GuoJiashu/mech5720-2026-single_pixel_imaging/README

# Reflective Single-Pixel Imaging — Calibration

This project uses a projector to illuminate a reflective target and a light-dependent resistor (LDR) to measure the returned light. A Python program controls the projected patterns, while an Arduino UNO records the LDR voltage and sends measurements to the computer over USB serial.

This README covers the hardware setup and calibration workflow: electrical response, projector alignment, temporal response, measurement repeatability, spatial response, and acquisition timing.

The scripts described below are restored versions of the calibration programs. They preserve the documented measurement methods but have not yet been revalidated on the hardware after restoration. Recorded settings are starting points for reproducing the setup, rather than universal calibration values.

<!-- IMAGE: 在这里放实验装置全景照片，标出 projector、reflective target、LDR、Arduino 和 computer，以及照明和反射光路。建议路径：docs/images/setup_overview.jpg。照片添加后取消下一行注释。 -->
<!-- ![Reflective imaging calibration setup](docs/images/setup_overview.jpg) -->

## Parts List

The quantities below describe one detector channel.

| Component | Quantity | Specification | Purchase link |
|---|---:|---|---|
| Projector | 1 | XGIMI Z7 | https://xgimi.com.au/product/xgimi-elfin-flip-laser-portable-projector-1600-iso-rgb-triple-laser-google-tv-netflix-harman-kardon-audio/ |
| Arduino | 1 | https://www.jaycar.com.au/duinotech-uno-r3-main-board/p/XC4410 | |
| LDR | 3 | https://www.jaycar.com.au/large-light-dependent-resistor-ldr/p/RD3485 | |
| Resistor | 3 | 22 kΩ | https://www.jaycar.com.au/22k-ohm-0-5-watt-metal-film-resistors-pack-of-8/p/RR0604 |
| Tracing Paper | 1 | | https://www.officeworks.com.au/shop/officeworks/p/studymate-a4-tracing-pad-50-leaf-orange-smtrce50r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 |
| Foam Board | 3 | https://www.officeworks.com.au/shop/officeworks/p/a3-foam-board-5mm-white-ljpcfba3we |  |

## Hardware Setup

1. With the LDR disconnected from the powered circuit, measure its resistance under dark and representative illuminated conditions. Record the lighting conditions and both resistance values.
2. Assemble the voltage divider using the connections below. The recorded setup uses a 22 kΩ resistor.
3. Connect the Arduino to the computer by USB.
4. Connect the projector as an **extended display**. Set its display output to 1920 × 1080.
5. Place the target inside the projected region and aim the LDR at the reflected light. Keep direct projector light out of the detector's field of view.
6. Fix the component positions and keep ambient lighting and projector settings constant throughout each comparison.

| Connection | Destination |
|---|---|
| Arduino 5 V | First LDR terminal |
| Second LDR terminal | Arduino A0 and one end of the 22 kΩ resistor |
| Other end of the 22 kΩ resistor | Arduino GND |

With this arrangement, stronger illumination normally reduces the LDR resistance and increases the A0 voltage. The ADC reading represents the divider voltage; it is not a direct measurement of optical power.

<!-- IMAGE: 在这里放分压电路接线图和面包板近照，清楚标出 5V、LDR、A0、22 kΩ、GND。不要画成 ADS1115 采集电路。 -->
<!-- ![LDR divider wiring](docs/images/ldr_wiring.jpg) -->

## Software Setup

Install Python, Arduino IDE, and the Python dependencies:

```bash
python -m pip install numpy scipy opencv-python pyserial screeninfo matplotlib
```

Organise the restored calibration scripts as follows:

```text
cali/
├── arduino/
│   ├── ldr_acquisition/
│   │   └── ldr_acquisition.ino
│   └── ldr_temporal_stream/
│       └── ldr_temporal_stream.ino
├── calibration_common.py
├── 01_ldr_electrical.py
├── 02_roi_calibration.py
├── 03_ldr_temporal.py
├── 04_hadamard_repeatability.py
├── 05_spatial_response.py
├── 06_point_timing.py
└── 07_hadamard_timing.py
```

Run the Python scripts from inside `cali/`. The scripts use relative paths for `roi_calibration.json` and `results/`.

Check the configuration in `calibration_common.py` before running:

| Setting | Recorded value | Action |
|---|---|---|
| `SERIAL_PORT` | `COM8` | Replace with the Arduino port on your computer |
| Serial baud rate | 115200 | Must match the uploaded firmware |
| `PROJECTOR_INDEX` | `1` | Check the printed monitor list |
| `EXPECTED_RESOLUTION` | `(1920, 1080)` | Match the projector display resolution |
| Initial ROI `(x, y, width, height)` | `(732, 664, 352, 384)` | Recalibrate for the physical setup |

The standalone ROI script also defines its own projector index and initial ROI. Update these if necessary. Close Arduino Serial Monitor before running a Python acquisition script.

## Calibration Workflow

| Stage | Purpose | Python script | Arduino firmware |
|---|---|---|---|
| 1. Electrical response | Check divider response and ADC operating range | `01_ldr_electrical.py` | `ldr_acquisition.ino` |
| 2. ROI / projector alignment | Set the projected region and inspect pattern visibility | `02_roi_calibration.py` | Not required |
| 3. Temporal response | Measure response to black–white transitions | `03_ldr_temporal.py` | `ldr_temporal_stream.ino` |
| 4. Hadamard repeatability | Check repeated complementary measurements | `04_hadamard_repeatability.py` | `ldr_acquisition.ino` |
| 5. Spatial response | Check reflected signals across the target region | `05_spatial_response.py` | `ldr_acquisition.ino` |
| 6A. Point timing | Compare settling times for individual illuminated cells | `06_point_timing.py` | `ldr_acquisition.ino` |
| 6B. Hadamard timing | Compare settling times for complementary patterns | `07_hadamard_timing.py` | `ldr_acquisition.ino` |

### 1. Electrical Response

Upload `ldr_acquisition.ino`, then run:

```bash
python 01_ldr_electrical.py
```

The script displays grayscale levels of 0, 64, 128, 192, and 255 within the current ROI. Each level is measured five times, with a 2.0 s settling period before acquisition. Each measurement uses 125 ADC samples at 4 ms intervals, giving an acquisition window of approximately 0.5 s.

Check that the response changes clearly with illumination and does not clip near either ADC limit, 0 or 1023. Compare the variation between repetitions with the change between grayscale levels. If the ROI does not illuminate the intended target, align it in Stage 2 and repeat this test.

Outputs: `electrical_raw.csv`, `electrical_summary.csv`, and `electrical_response.png` in a timestamped `results/electrical/` directory.

This test measures the combined projector–LDR–divider response. It does not separate projector nonlinearity from detector nonlinearity, or replace the initial resistance measurements.

<!-- IMAGE: 放 electrical_response.png，即灰度—ADC 曲线，误差棒为五次测量均值之间的标准差。可在图注补充实际暗态/照明阻值。 -->
<!-- ![Electrical response](docs/images/electrical_response.png) -->

### 2. ROI / Projector Alignment

```bash
python 02_roi_calibration.py
```

Align the region of interest (ROI) with the target and inspect the projected checkerboards.

| Key | Function |
|---|---|
| `W` / `A` / `S` / `D` | Move the ROI |
| `J` / `L` | Decrease / increase width |
| `K` / `I` | Decrease / increase height |
| `[` / `]` | Decrease / increase adjustment step |
| `1` | Show ROI outline |
| `2` | Show a white ROI |
| `3` / `4` | Show a 16 × 16 / 32 × 32 checkerboard |
| `P` | Save ROI settings |
| `R` | Reset to the script's initial settings |
| `Q` / `Esc` | Exit |

Use lowercase keyboard input, without Shift. Press `P` to create `roi_calibration.json`; the acquisition scripts load this file automatically. The ROI alignment script itself starts from its hard-coded values.

Choose dimensions divisible by the intended grid size when practical, so projected cells have equal display-pixel dimensions. Inspect focus, target coverage, and the visibility of small cells. A visible checkerboard alone does not establish that the LDR can detect an individual cell reliably.

<!-- IMAGE: 放目标上实际投影的白色 ROI 和棋盘格照片，标出 ROI 边界；不要只放电脑截图。 -->
<!-- ![ROI alignment and projected checkerboard](docs/images/roi_alignment.jpg) -->

### 3. Temporal Response

Upload `ldr_temporal_stream.ino`, then run:

```bash
python 03_ldr_temporal.py
```

The projector alternates between black for 10 s and white for 10 s over three cycles. The Arduino streams one ADC reading every 20 ms. Inspect the rise, decay, plateau stability, and noise to assess how long the system needs to settle after a pattern change.

Outputs: `ldr_temporal.csv`, `ldr_temporal.npz`, and `ldr_temporal.png` in `results/temporal/`. These filenames are reused; copy the results into a separate run folder before repeating the test if they need to be retained.

The recorded host timestamps include display and serial timing uncertainty. The nominal 10 s boundaries are not exact optical transition measurements, so interpret estimated response times accordingly.

**Re-upload `ldr_acquisition.ino` before proceeding to Stages 4–6.**

<!-- IMAGE: 放完整 black–white 时间响应曲线；可加一个上升沿和一个下降沿的局部放大图，说明 settling time 的选取依据。 -->
<!-- ![Temporal response](docs/images/ldr_temporal.png) -->

### 4. Hadamard Repeatability

```bash
python 04_hadamard_repeatability.py
```

The test uses a 16 × 16 grid and eight zero-based Hadamard row indices: `8, 16, 24, 32, 40, 64, 128, 136`. Each pattern and its complement are measured five times with 2.0 s settling per displayed pattern, producing 80 individual measurements.

For each pair, the script calculates `delta_adc = positive_adc - negative_adc`. Assess the standard deviation of this difference across repetitions, rather than relying only on the noise within individual ADC captures. A small mean difference can be physically valid for some patterns; it is not automatically a failed measurement.

Outputs: `hadamard_measurements.csv`, `hadamard_pair_differences.csv`, and `hadamard_repeatability_summary.csv` in a timestamped `results/hadamard_repeatability/` directory.

<!-- IMAGE: 用 summary CSV 绘制八组 Hadamard 差分均值及标准差；此脚本目前只输出 CSV，不自动生成该图。 -->
<!-- ![Hadamard repeatability](docs/images/hadamard_repeatability.png) -->

### 5. Spatial Response

```bash
python 05_spatial_response.py
```

The script projects a 96 × 96 display-pixel white patch at nine positions arranged in a 3 × 3 grid. Each position is tested three times. Before every patch, it measures a black reference after 6.0 s settling; the patch is measured after 2.0 s settling.

The response is calculated as `delta_adc = patch_adc - black_adc`. Inspect the 3 × 3 response map and the variation across repetitions to identify weak regions. Differences can arise from target shape, reflectance, illumination, or detector viewing geometry; the map is not a detector-only sensitivity calibration. The large patch test also does not establish the signal-to-noise ratio of a single fine-grid cell.

Outputs: `spatial_raw.csv`, `spatial_summary.csv`, `spatial_data.npz`, and `spatial_response.png` in a timestamped `results/spatial_response/` directory.

<!-- IMAGE: 放 spatial_response.png，并配一张目标照片，标出对应的九个测量位置以及 detector 所在方向。 -->
<!-- ![Spatial response](docs/images/spatial_response.png) -->

### 6. Acquisition Timing Optimisation

Keep the geometry, ambient lighting, and projector settings unchanged during each timing comparison.

#### 6A. Point-Scanning Timing

```bash
python 06_point_timing.py
```

The script measures 32 selected cells on a 16 × 16 grid using settling times of 2.0, 1.0, and 0.5 s. Black references are collected at the start and after every 16 cells, with 6.0 s black settling. The script interpolates the background in time and compares corrected measurements against the 2.0 s baseline.

Inspect Pearson correlation together with bias, MAE, RMSE, and the 95th-percentile absolute error. High correlation alone does not rule out a systematic change in signal amplitude.

Outputs: `point_timing_raw.csv`, `point_timing_corrected.csv`, and `point_timing_summary.csv` in a timestamped `results/point_timing/` directory. In the restored script, black-reference anchors are used internally but are not saved in a separate CSV.

#### 6B. Hadamard Timing

```bash
python 07_hadamard_timing.py
```

The script compares 2.0 s and 1.0 s settling using the same eight Hadamard rows as Stage 4, with three repetitions per setting. It records a black reference before each repetition and compares the mean complementary differences and their repeat standard deviations.

Outputs: `timing_raw.csv`, `timing_pairs.csv`, `black_reference.csv`, and `timing_comparison.csv` in a timestamped `results/hadamard_timing/` directory.

Both timing tests collect the waiting-time conditions sequentially. Drift can therefore contribute to the measured differences. Treat 2.0 s as the comparison baseline, not an independently established ground truth. The previously recorded working settling time was 1.0 s for both methods; confirm its suitability again after changing the setup.

<!-- IMAGE: 放 point timing 和 Hadamard timing 对比图，展示相对 2.0 s baseline 的误差及重复波动。两个 timing 脚本目前输出 CSV，需要另行绘图。 -->
<!-- ![Timing comparison](docs/images/timing_comparison.png) -->

## Known Pitfalls

| Symptom / issue | Check |
|---|---|
| Serial port fails to open | Confirm the port and close Serial Monitor or other programs using it |
| Acquisition times out | Confirm the baud rate and upload `ldr_acquisition.ino`; temporal firmware uses a different protocol |
| Patterns appear on the computer monitor | Check the monitor index in both the common module and the standalone ROI script |
| ROI changes are not loaded | Press `P` to save and run acquisition from the same `cali/` directory |
| Response is clipped or very weak | Check wiring, divider resistance, detector orientation, illumination, and direct light leakage |
| Measurements depend on the preceding pattern | Recheck temporal response and increase settling time |
| Timing comparisons disagree | Check drift and repeatability before attributing all differences to settling time |
| Changing the target or background changes the signal | Repeat the relevant checks; the detector integrates all received light, including background reflections |

Retain the raw CSV files, ROI settings, hardware configuration, and setup photographs with each experiment. Do not replace measured calibration results with example values.

<!-- SUBMISSION NOTE: 课程要求最终仓库提供一个从仓库内数据（或稳定公开链接）生成论文关键图的脚本。当前 README 只覆盖 calibration，等对应结果和脚本完成后再补充；此处不声称已满足最终提交全部要求。 -->
