GuoJiashu/mech5720-2026-single_pixel_imaging/fourier_results/20261024_222205_895619/reconstruction_corrected/spectrum_analysis/radial_frequency_profile.csv

radius | mean_magnitude | median_magnitude | rms_magnitude | count
1.767766953122618945e-01 | 3.022257671467889963e+02 | 3.022257671467889963e+02 | 3.022257671467889963e+02 | 1.000000000000000000e+00
5.303300859367856557e-01 | nan | nan | nan | 0.000000000000000000e+00
8.838834765613095001e-01 | 1.463829034139222074e+02 | 1.463829034139222074e+02 | 1.538807243068025912e+02 | 4.000000000000000000e+00
1.237436867185833123e+00 | 5.824770147730846759e+01 | 5.824770147730846759e+01 | 6.986801264962008418e+01 | 4.000000000000000000e+00
1.590990257810357189e+00 | nan | nan | nan | 0.000000000000000000e+00
1.944543648434880811e+00 | 7.046362253684843324e+01 | 7.046362253684843324e+01 | 7.810626516275235076e+01 | 4.000000000000000000e+00
2.298097039059404878e+00 | 4.133822684969020855e+01 | 3.694488819344392994e+01 | 4.294456626098556740e+01 | 8.000000000000000000e+00
2.651650429683928500e+00 | 3.255678118946195099e+01 | 3.255678118946195099e+01 | 3.315687817871332044e+01 | 4.000000000000000000e+00
3.005203820308452123e+00 | 3.578019599320380451e+01 | 3.196757954502769650e+01 | 3.827041707677187077e+01 | 1.200000000000000000e+01
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
