GuoJiashu/mech5720-2026-single_pixel_imaging/fourier_results/20261025_002849_105656/reconstruction_corrected/spectrum_analysis/radial_frequency_profile.csv

radius | mean_magnitude | median_magnitude | rms_magnitude | count
3.535533906088987877e-01 | 3.030005307019344514e+02 | 3.030005307019344514e+02 | 3.030005307019344514e+02 | 1.000000000000000000e+00
1.060660171826696363e+00 | 1.026816517705819649e+02 | 9.895339652200169667e+01 | 1.196109597882424254e+02 | 8.000000000000000000e+00
1.767766953044493938e+00 | 7.205127628615088042e+01 | 7.205127628615088042e+01 | 7.982760587445604017e+01 | 4.000000000000000000e+00
2.474873734262291514e+00 | 3.972473809764658625e+01 | 3.730737839621809826e+01 | 4.126148670433882870e+01 | 1.200000000000000000e+01
3.181980515480089089e+00 | 3.190269858779567258e+01 | 2.831407684867858876e+01 | 3.545440142013759299e+01 | 1.200000000000000000e+01
3.889087296697886664e+00 | 1.754463252263073159e+01 | 1.979047756634872712e+01 | 1.878180643430124874e+01 | 2.400000000000000000e+01
4.596194077915684240e+00 | 1.891775937697173049e+01 | 1.866498029131999203e+01 | 1.919303729291997485e+01 | 8.000000000000000000e+00
5.303300859133481815e+00 | 1.139635093040973501e+01 | 1.114701882084449736e+01 | 1.230009077193065714e+01 | 3.200000000000000000e+01
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
