GuoJiashu/mech5720-2026-single_pixel_imaging/fourier_results/20261025_080248_743060/reconstruction_corrected/spectrum_analysis/radial_frequency_profile.csv

radius | mean_magnitude | median_magnitude | rms_magnitude | count
7.071067812021725185e-01 | 1.032069103009124547e+02 | 8.963566167414252561e+01 | 1.263954955567347440e+02 | 9.000000000000000000e+00
2.121320343606517334e+00 | 4.290574844329907478e+01 | 3.671684088117390843e+01 | 4.825233089216124682e+01 | 1.600000000000000000e+01
3.535533906010862371e+00 | 1.924892990092063627e+01 | 1.596806944804961148e+01 | 2.171671499129238470e+01 | 3.600000000000000000e+01
4.949747468415207408e+00 | 1.105762064964178748e+01 | 1.168673737212324326e+01 | 1.209555776665056470e+01 | 4.000000000000000000e+01
6.363961030819552889e+00 | 7.654689417525719186e+00 | 7.770722261024829436e+00 | 8.664979351908172589e+00 | 6.000000000000000000e+01
7.778174593223897482e+00 | 7.081172089376984502e+00 | 5.867989467552281901e+00 | 8.567317490345420339e+00 | 6.400000000000000000e+01
9.192388155628242075e+00 | 3.844302833805369968e+00 | 3.131039093527419936e+00 | 4.749348535493709278e+00 | 8.000000000000000000e+01
1.060660171803258756e+01 | 4.983127674750293501e+00 | 3.858005837173887898e+00 | 6.353314220041501592e+00 | 1.000000000000000000e+02
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
