GuoJiashu/mech5720-2026-single_pixel_imaging/analyze/fourier/fourier_background_drift_16.png

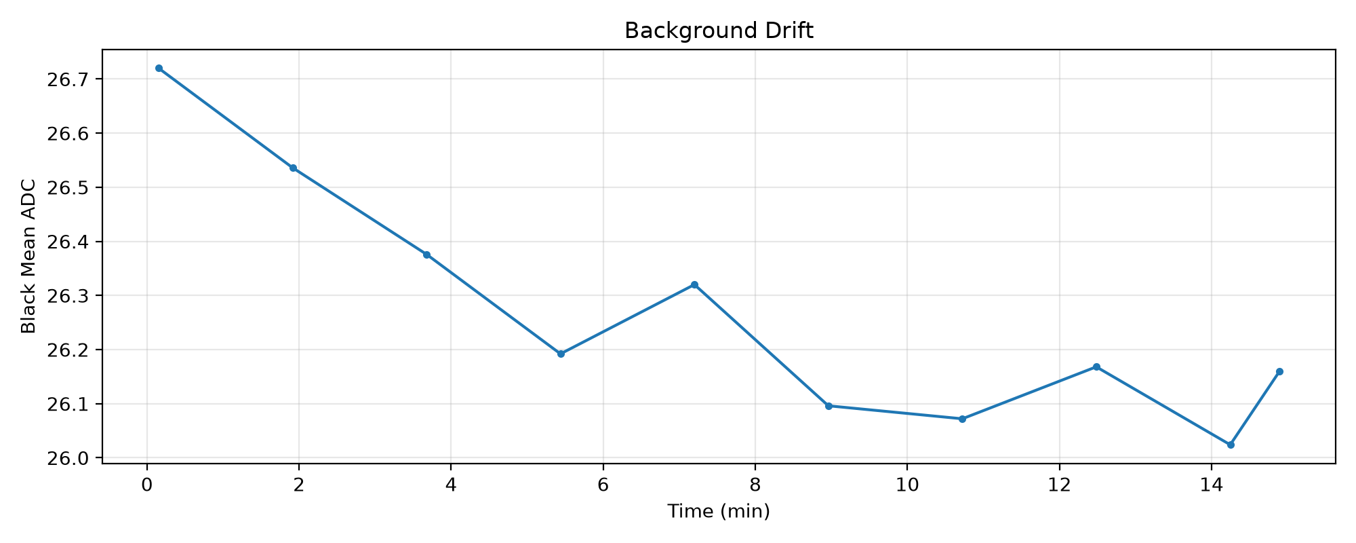
analyze/fourier/fourier_background_drift_16.png
