GuoJiashu/mech5720-2026-single_pixel_imaging/analyze/fourier/fourier_background_noise_32.png

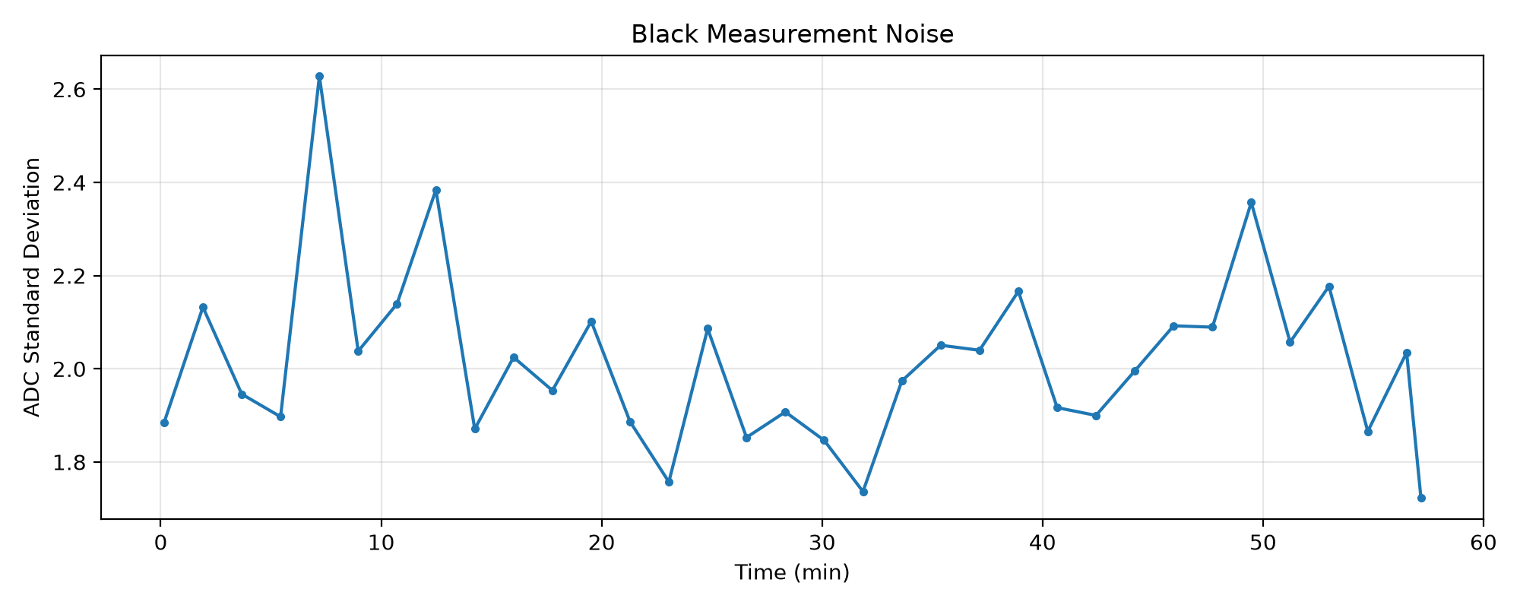
analyze/fourier/fourier_background_noise_32.png
