GuoJiashu/mech5720-2026-single_pixel_imaging/analyze/fourier/NLOS_background_drift_16.png

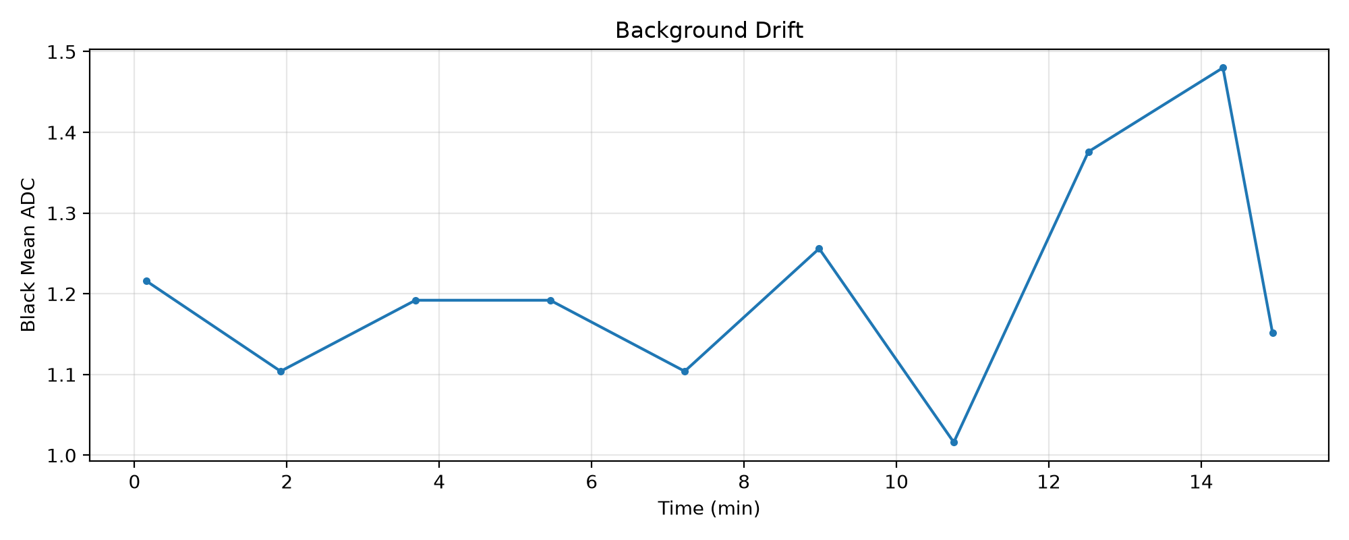
analyze/fourier/NLOS_background_drift_16.png
