GuoJiashu/mech5720-2026-single_pixel_imaging/analyze/fourier/NLOS_background_noise_32.png

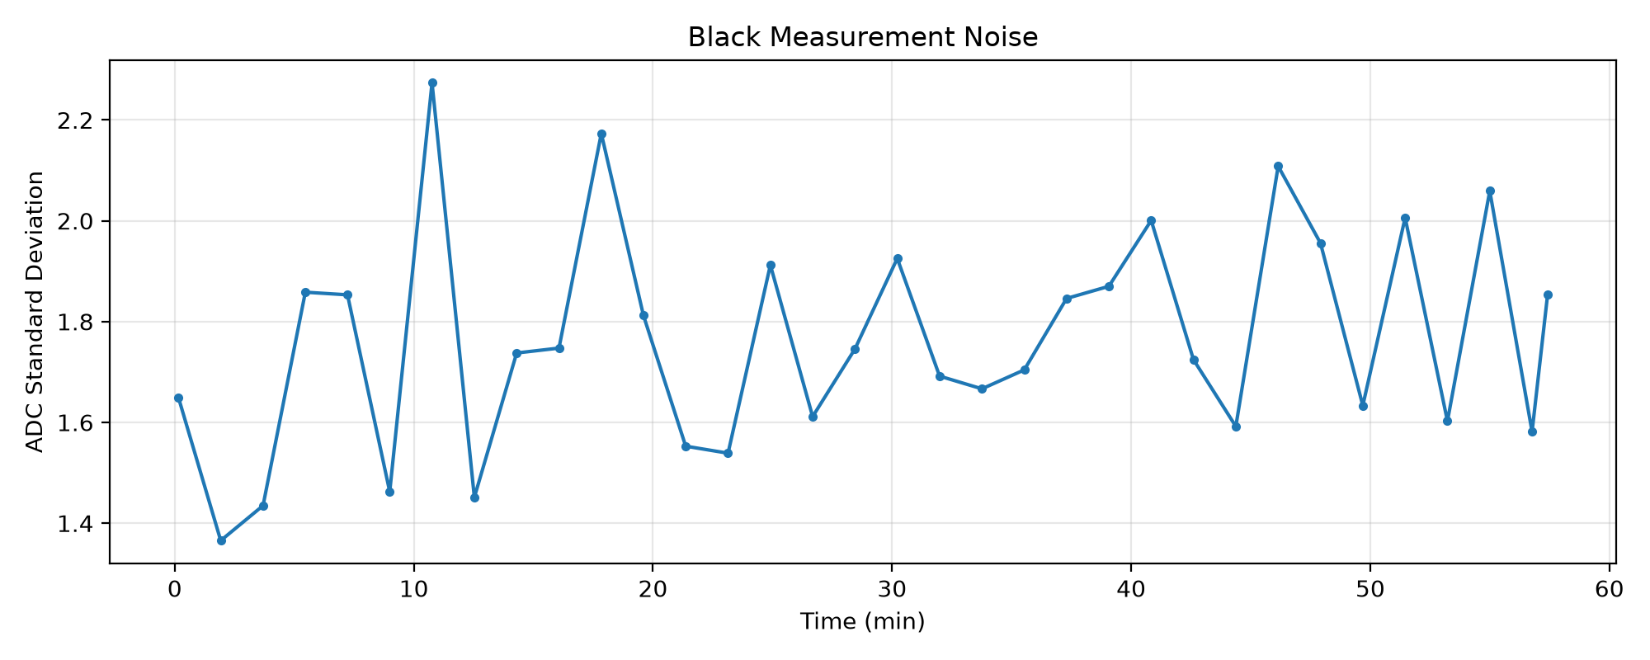
analyze/fourier/NLOS_background_noise_32.png
