GuoJiashu/mech5720-2026-single_pixel_imaging/analyze/fourier/NLOS_background_noise_64.png

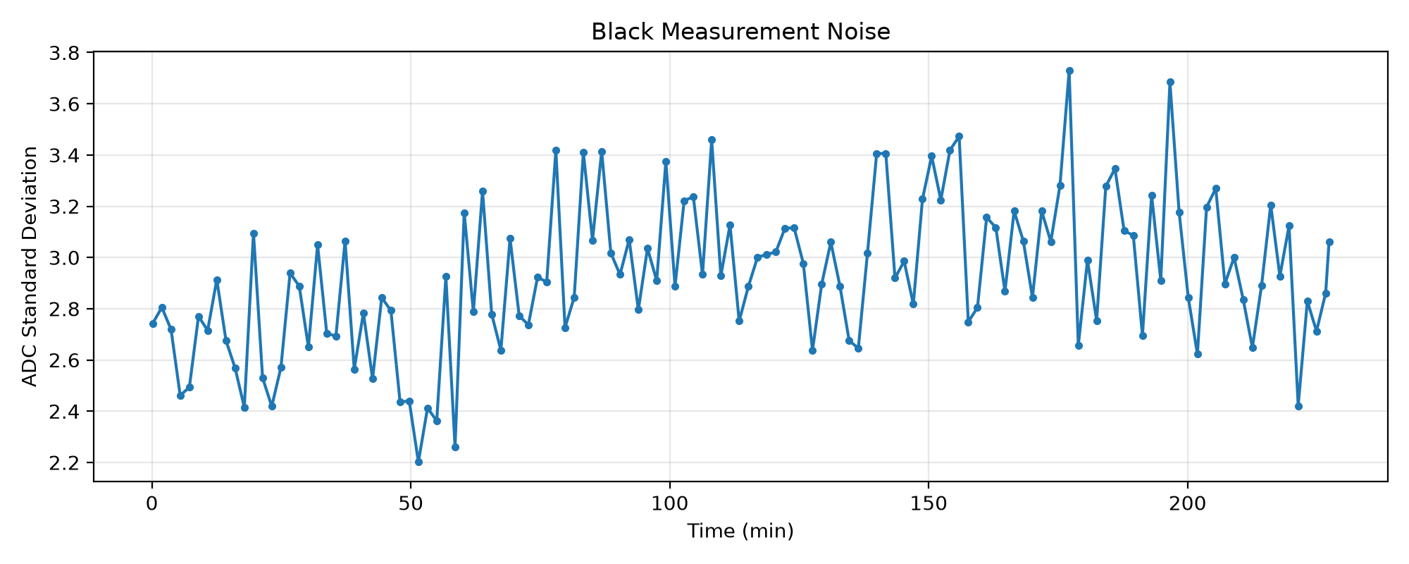
analyze/fourier/NLOS_background_noise_64.png
