GuoJiashu/mech5720-2026-single_pixel_imaging/analyze/hadamard/hadamard_background_drift_64.png

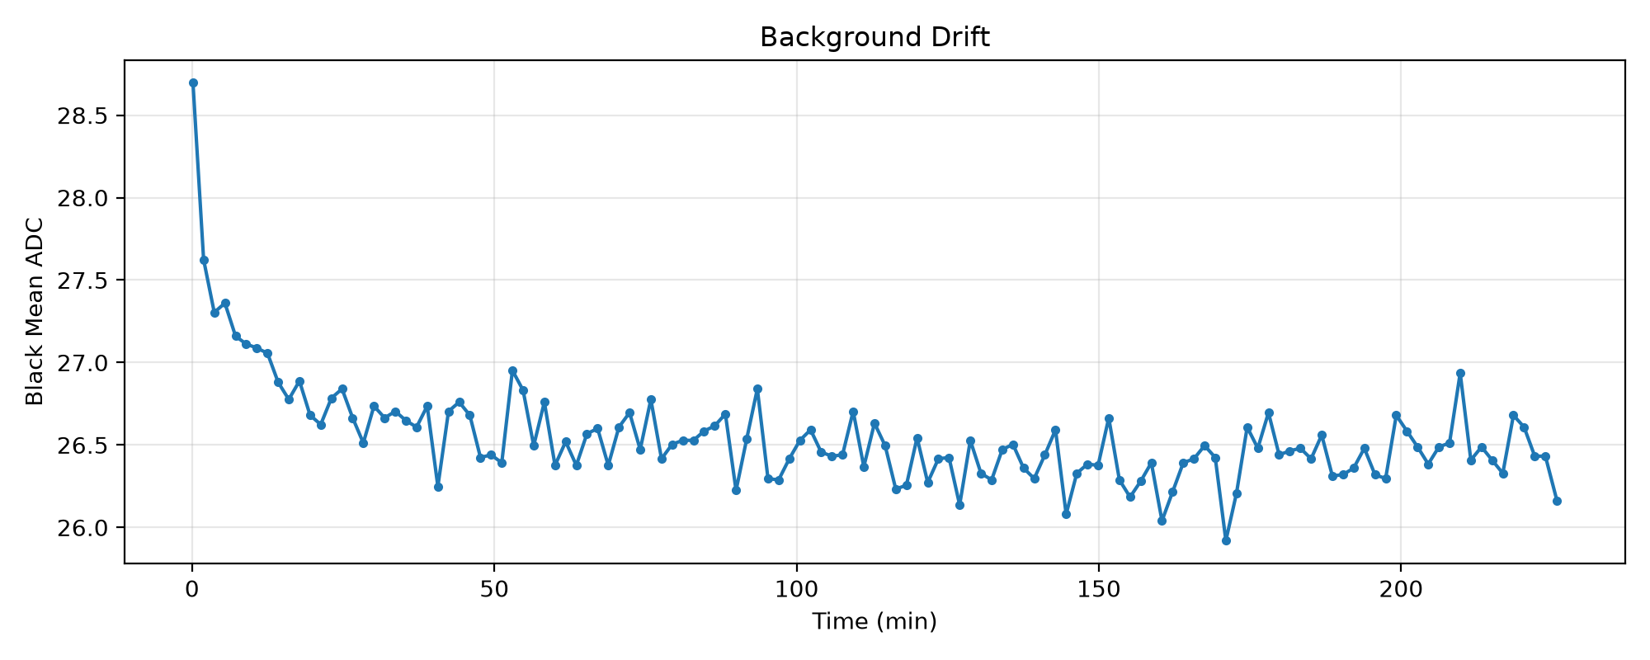
analyze/hadamard/hadamard_background_drift_64.png
