GuoJiashu/mech5720-2026-single_pixel_imaging/analyze/hadamard/NLOS_background_noise_64.png

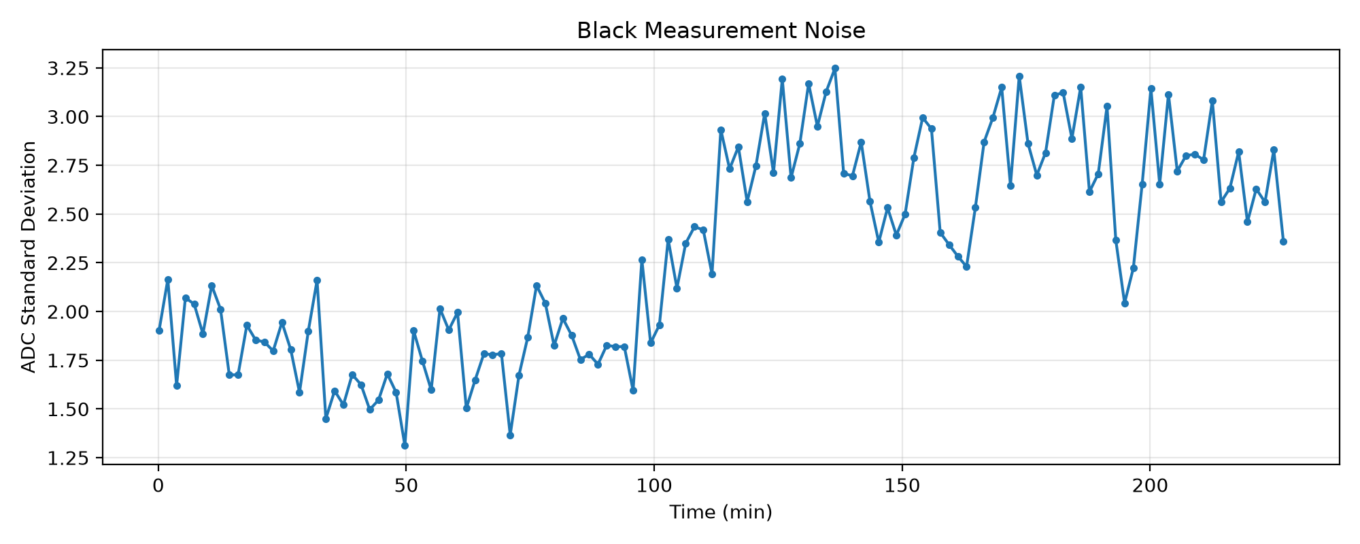
analyze/hadamard/NLOS_background_noise_64.png
