GuoJiashu/mech5720-2026-single_pixel_imaging/analyze/point_scanning/NLOS_background_drift_16.png

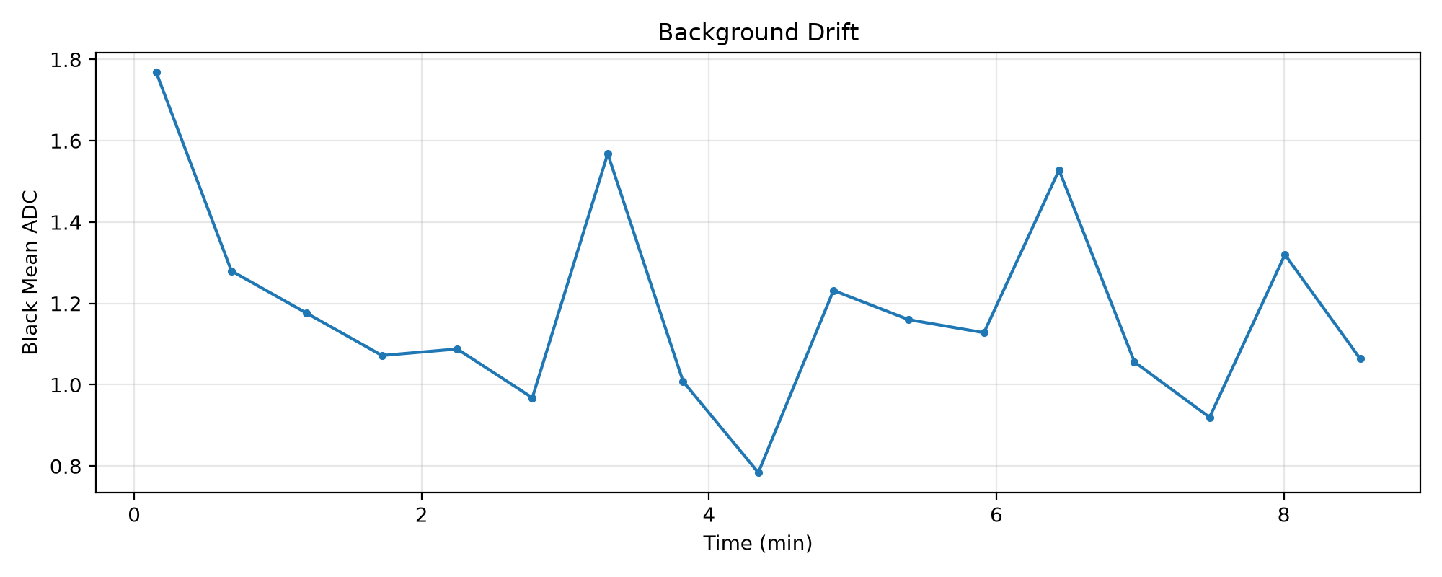
analyze/point_scanning/NLOS_background_drift_16.png
