GuoJiashu/mech5720-2026-single_pixel_imaging/analyze/point_scanning/NLOS_background_noise_64.png

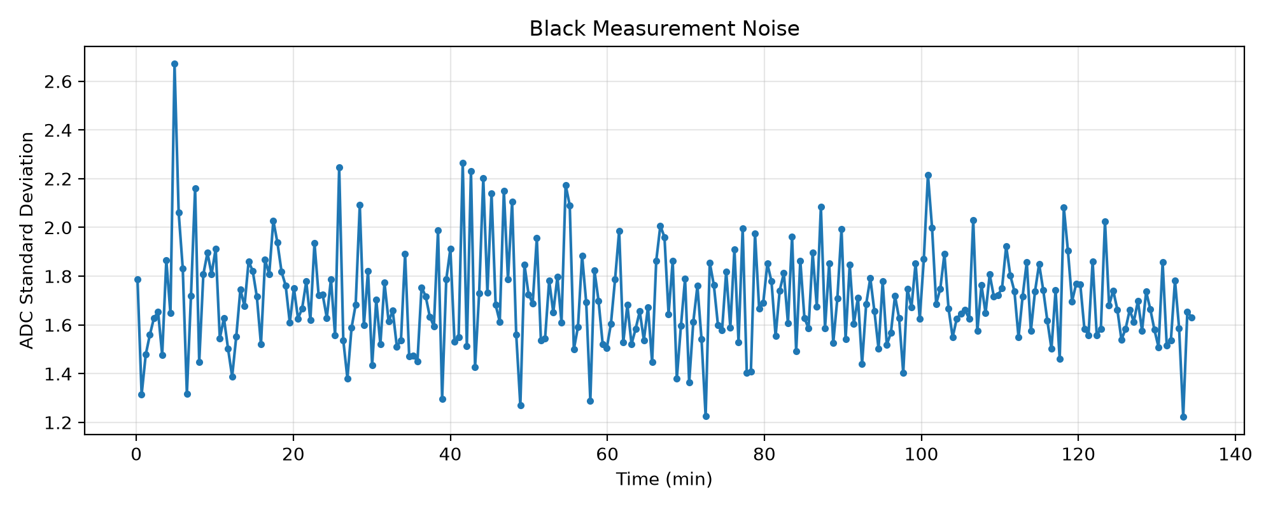
analyze/point_scanning/NLOS_background_noise_64.png
