GuoJiashu/mech5720-2026-single_pixel_imaging/analyze/point_scanning/PS_background_drift_32.png

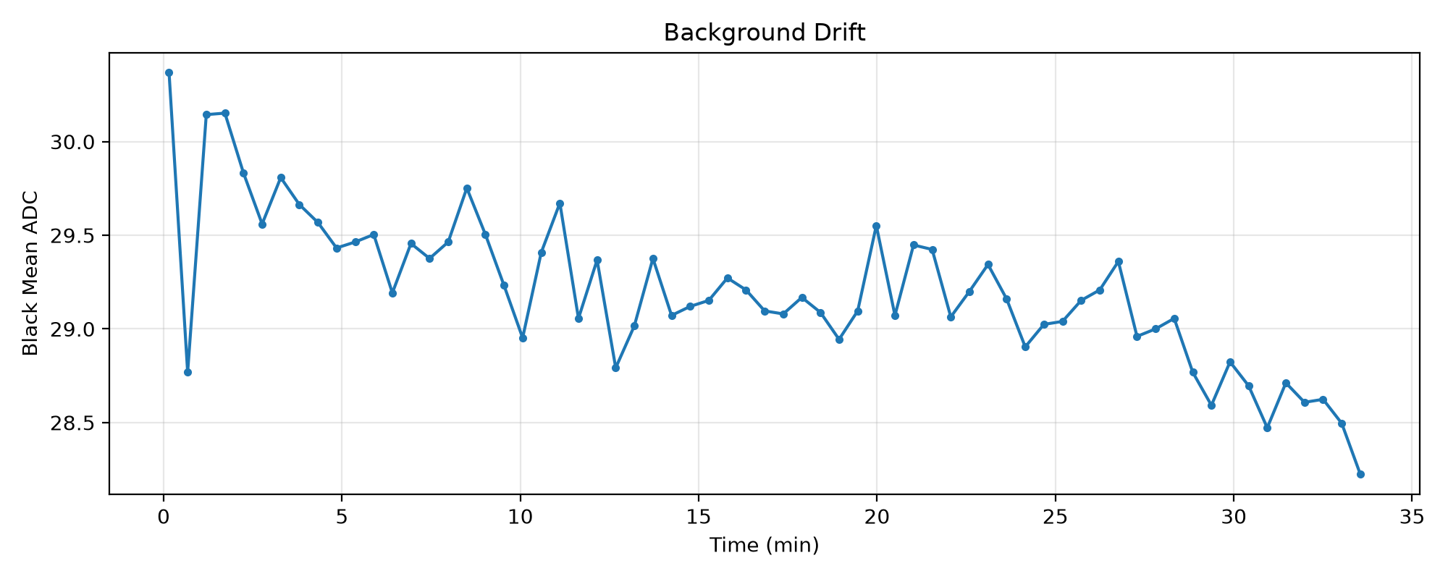
analyze/point_scanning/PS_background_drift_32.png
