GuoJiashu/mech5720-2026-single_pixel_imaging/enhancement_comparison.png

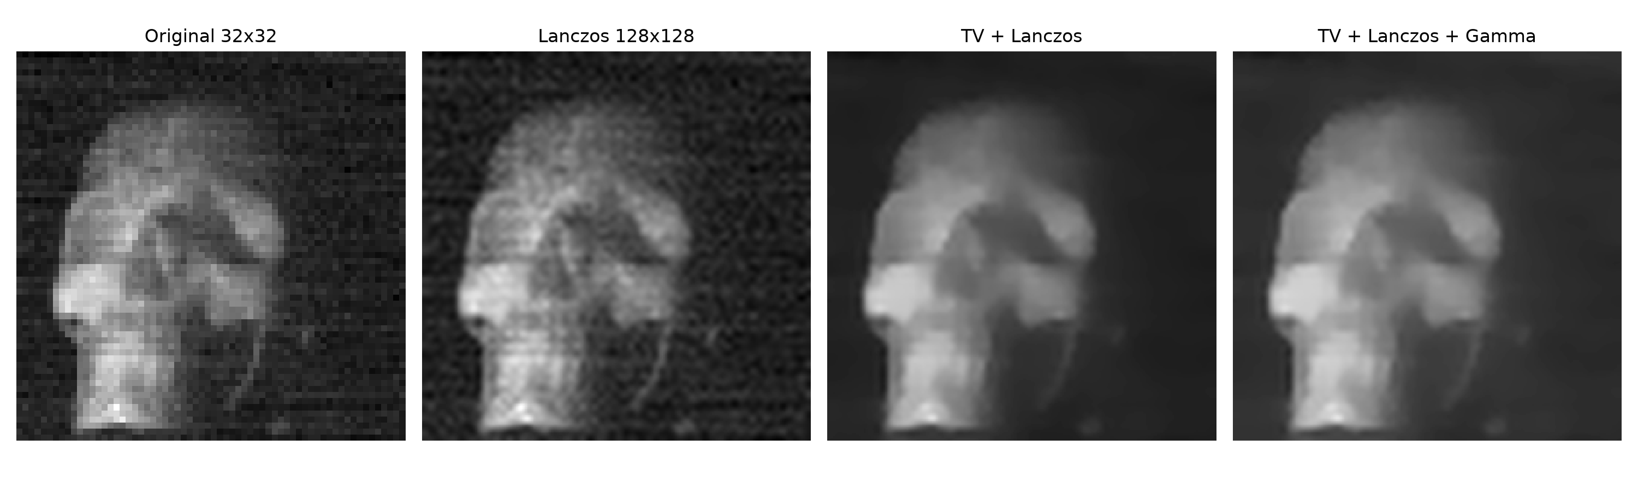
enhancement_comparison.png
