GuoJiashu/mech5720-2026-single_pixel_imaging/fourier_results/20261024_222205_895619/reconstruction_corrected/spectrum_analysis/filtering_comparison.png

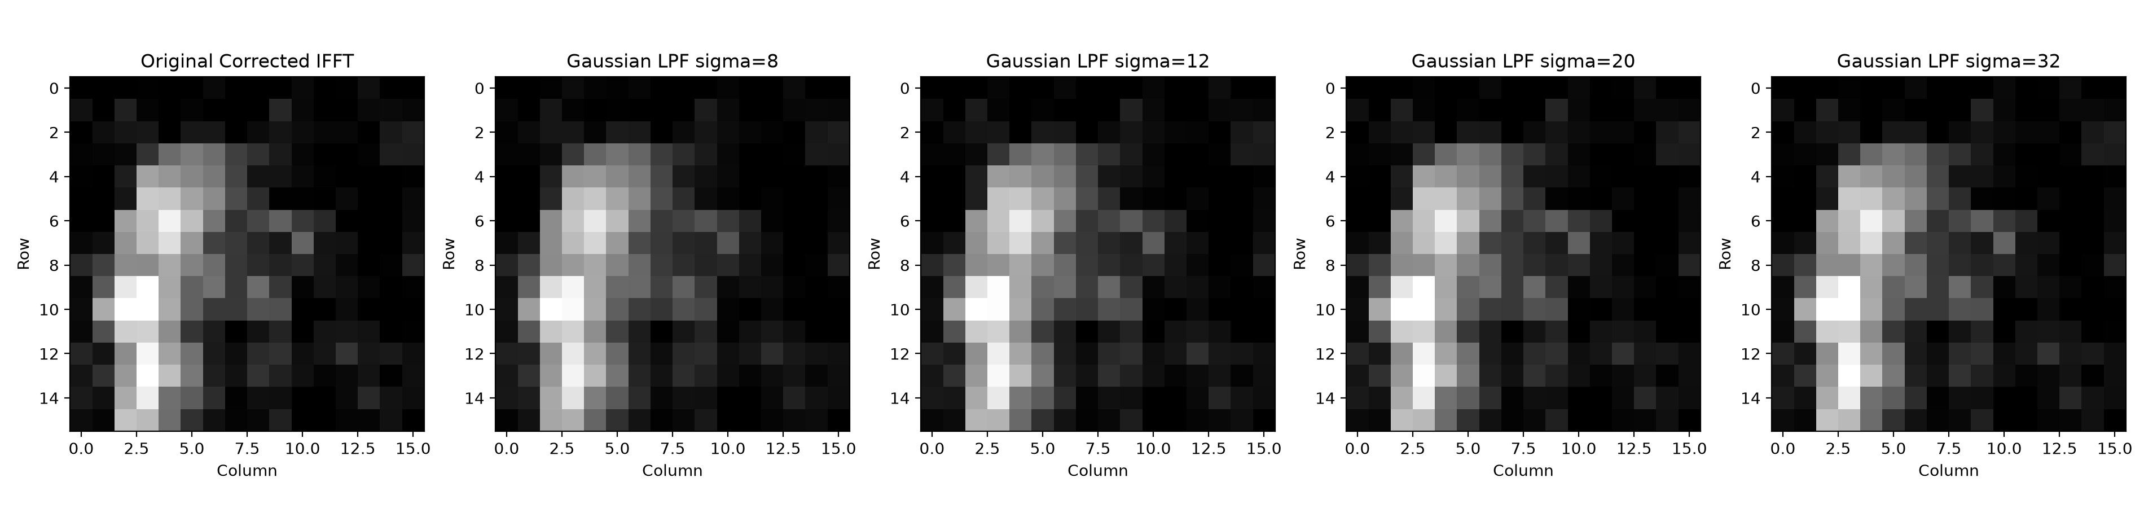
fourier_results/20261024_222205_895619/reconstruction_corrected/spectrum_analysis/filtering_comparison.png
