GuoJiashu/mech5720-2026-single_pixel_imaging/fourier_results/20261025_080248_743060/reconstruction_corrected/spectrum_analysis/spectrum_analysis.png

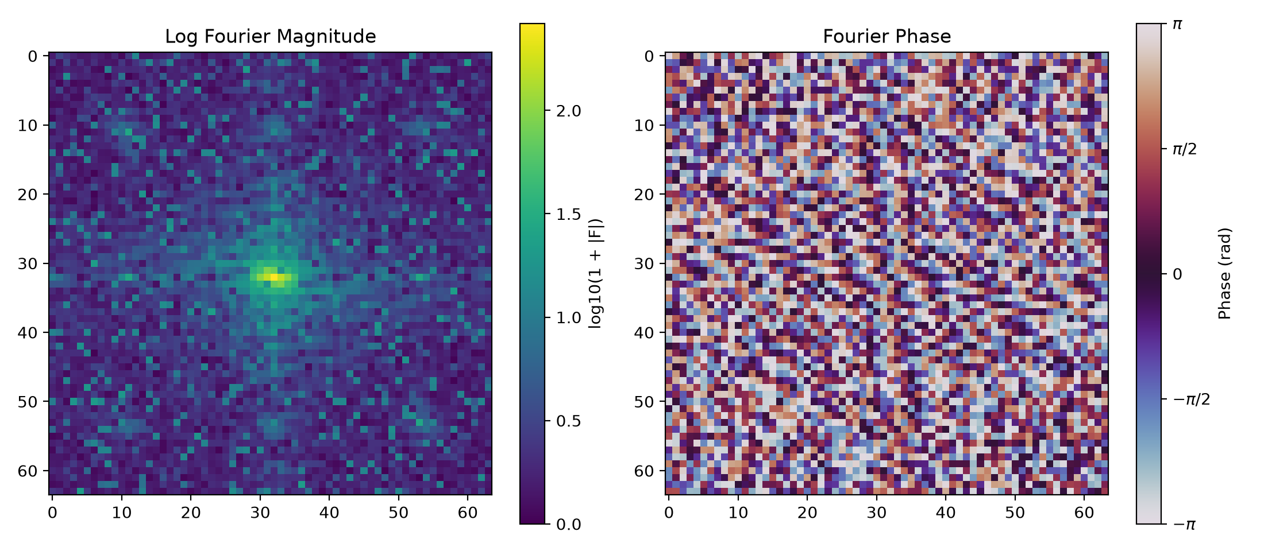
fourier_results/20261025_080248_743060/reconstruction_corrected/spectrum_analysis/spectrum_analysis.png
