GuoJiashu/mech5720-2026-single_pixel_imaging/imaging_2d/datasets/ground_truth/GT1.jpg

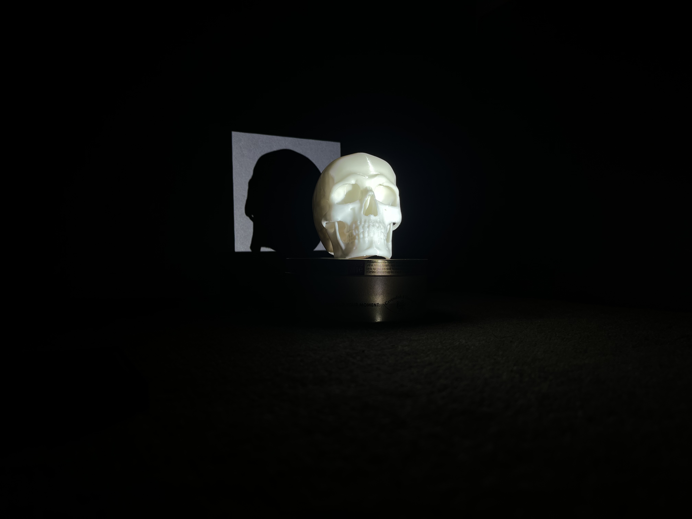
imaging_2d/datasets/ground_truth/GT1.jpg
