GuoJiashu/mech5720-2026-single_pixel_imaging/imaging_2d/results/fourier/20261025_002849_105656/reconstruction_corrected/spectrum_analysis/radial_frequency_analysis.png

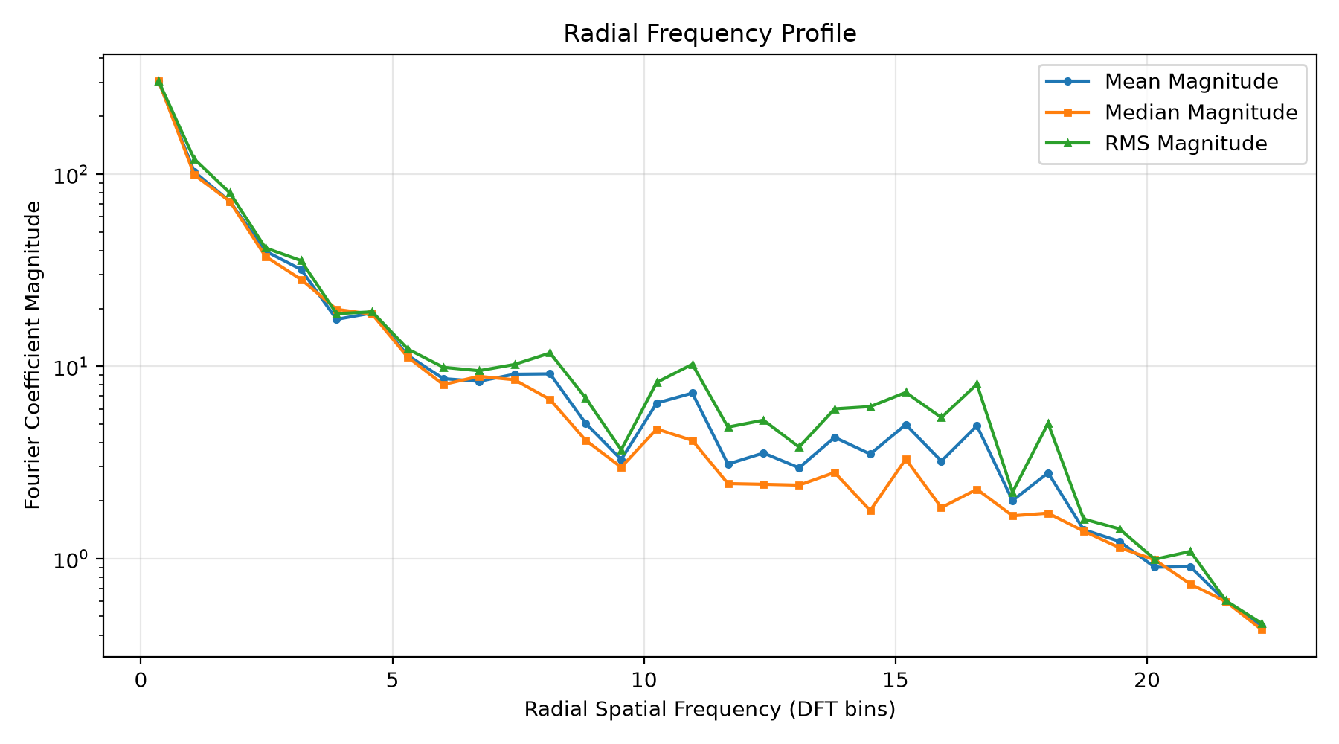
imaging_2d/results/fourier/20261025_002849_105656/reconstruction_corrected/spectrum_analysis/radial_frequency_analysis.png
