GuoJiashu/mech5720-2026-single_pixel_imaging/analyze/report_results/compressive_sensing/summary.csv

Scene | Method | Resolution | Algorithm | Requested_Rate | Actual_Group_Rate | Measured_Groups | Total_Groups | Signal_Projections | Full_Signal_Projections | SSIM | Reference | Sampling_Design | Source
Direct_Scene | Hadamard | 64x64 | ZeroFilled | 1.0 | 1.0 | 4096 | 4096 | 8192 | 8192 | 1.0 | Full-sampling internal reference; not independent ground truth | Retrospective subsets of a complete acquisition | C:\Users\13658\Desktop\MECH 5720\Major\code\hadamard_results\20261024_013607_094384\hadamard_data.npz
Direct_Scene | Hadamard | 64x64 | TV_ADMM | 1.0 | 1.0 | 4096 | 4096 | 8192 | 8192 | 0.9120054517499858 | Full-sampling internal reference; not independent ground truth | Retrospective subsets of a complete acquisition | C:\Users\13658\Desktop\MECH 5720\Major\code\hadamard_results\20261024_013607_094384\hadamard_data.npz
Direct_Scene | Hadamard | 64x64 | ZeroFilled | 0.5 | 0.5 | 2048 | 4096 | 4096 | 8192 | 0.3779824800803362 | Full-sampling internal reference; not independent ground truth | Retrospective subsets of a complete acquisition | C:\Users\13658\Desktop\MECH 5720\Major\code\hadamard_results\20261024_013607_094384\hadamard_data.npz
Direct_Scene | Hadamard | 64x64 | TV_ADMM | 0.5 | 0.5 | 2048 | 4096 | 4096 | 8192 | 0.8032941358001652 | Full-sampling internal reference; not independent ground truth | Retrospective subsets of a complete acquisition | C:\Users\13658\Desktop\MECH 5720\Major\code\hadamard_results\20261024_013607_094384\hadamard_data.npz
Direct_Scene | Hadamard | 64x64 | ZeroFilled | 0.25 | 0.25 | 1024 | 4096 | 2048 | 8192 | 0.25159493167986074 | Full-sampling internal reference; not independent ground truth | Retrospective subsets of a complete acquisition | C:\Users\13658\Desktop\MECH 5720\Major\code\hadamard_results\20261024_013607_094384\hadamard_data.npz
Direct_Scene | Hadamard | 64x64 | TV_ADMM | 0.25 | 0.25 | 1024 | 4096 | 2048 | 8192 | 0.524832433437833 | Full-sampling internal reference; not independent ground truth | Retrospective subsets of a complete acquisition | C:\Users\13658\Desktop\MECH 5720\Major\code\hadamard_results\20261024_013607_094384\hadamard_data.npz
Direct_Scene | Hadamard | 64x64 | ZeroFilled | 0.1 | 0.10009765625 | 410 | 4096 | 820 | 8192 | 0.14238077074370567 | Full-sampling internal reference; not independent ground truth | Retrospective subsets of a complete acquisition | C:\Users\13658\Desktop\MECH 5720\Major\code\hadamard_results\20261024_013607_094384\hadamard_data.npz
Direct_Scene | Hadamard | 64x64 | TV_ADMM | 0.1 | 0.10009765625 | 410 | 4096 | 820 | 8192 | 0.22462261931563787 | Full-sampling internal reference; not independent ground truth | Retrospective subsets of a complete acquisition | C:\Users\13658\Desktop\MECH 5720\Major\code\hadamard_results\20261024_013607_094384\hadamard_data.npz
Direct_Scene | Fourier | 64x64 | ZeroFilled | 1.0 | 1.0 | 2050 | 2050 | 8200 | 8200 | 1.0 | Full-sampling internal reference; not independent ground truth | Retrospective subsets of a complete acquisition | C:\Users\13658\Desktop\MECH 5720\Major\code\fourier_results\20261024_052155_912611\fourier_data.npz
Direct_Scene | Fourier | 64x64 | TV_ADMM | 1.0 | 1.0 | 2050 | 2050 | 8200 | 8200 | 0.9502124463127677 | Full-sampling internal reference; not independent ground truth | Retrospective subsets of a complete acquisition | C:\Users\13658\Desktop\MECH 5720\Major\code\fourier_results\20261024_052155_912611\fourier_data.npz
Direct_Scene | Fourier | 64x64 | ZeroFilled | 0.5 | 0.5 | 1025 | 2050 | 4100 | 8200 | 0.5823616899685953 | Full-sampling internal reference; not independent ground truth | Retrospective subsets of a complete acquisition | C:\Users\13658\Desktop\MECH 5720\Major\code\fourier_results\20261024_052155_912611\fourier_data.npz
Direct_Scene | Fourier | 64x64 | TV_ADMM | 0.5 | 0.5 | 1025 | 2050 | 4100 | 8200 | 0.5553774821518953 | Full-sampling internal reference; not independent ground truth | Retrospective subsets of a complete acquisition | C:\Users\13658\Desktop\MECH 5720\Major\code\fourier_results\20261024_052155_912611\fourier_data.npz
Direct_Scene | Fourier | 64x64 | ZeroFilled | 0.25 | 0.2497560975609756 | 512 | 2050 | 2048 | 8200 | 0.3087289583544085 | Full-sampling internal reference; not independent ground truth | Retrospective subsets of a complete acquisition | C:\Users\13658\Desktop\MECH 5720\Major\code\fourier_results\20261024_052155_912611\fourier_data.npz
Direct_Scene | Fourier | 64x64 | TV_ADMM | 0.25 | 0.2497560975609756 | 512 | 2050 | 2048 | 8200 | 0.2528710077523149 | Full-sampling internal reference; not independent ground truth | Retrospective subsets of a complete acquisition | C:\Users\13658\Desktop\MECH 5720\Major\code\fourier_results\20261024_052155_912611\fourier_data.npz
Direct_Scene | Fourier | 64x64 | ZeroFilled | 0.1 | 0.1 | 205 | 2050 | 820 | 8200 | 0.1700509246643884 | Full-sampling internal reference; not independent ground truth | Retrospective subsets of a complete acquisition | C:\Users\13658\Desktop\MECH 5720\Major\code\fourier_results\20261024_052155_912611\fourier_data.npz
Direct_Scene | Fourier | 64x64 | TV_ADMM | 0.1 | 0.1 | 205 | 2050 | 820 | 8200 | 0.11895291734797789 | Full-sampling internal reference; not independent ground truth | Retrospective subsets of a complete acquisition | C:\Users\13658\Desktop\MECH 5720\Major\code\fourier_results\20261024_052155_912611\fourier_data.npz
NLOS | Hadamard | 64x64 | ZeroFilled | 1.0 | 1.0 | 4096 | 4096 | 8192 | 8192 | 1.0 | Full-sampling internal reference; not independent ground truth | Retrospective subsets of a complete acquisition | C:\Users\13658\Desktop\MECH 5720\Major\code\hadamard_results\20261025_041555_865482\hadamard_data.npz
NLOS | Hadamard | 64x64 | TV_ADMM | 1.0 | 1.0 | 4096 | 4096 | 8192 | 8192 | 0.9438816604482299 | Full-sampling internal reference; not independent ground truth | Retrospective subsets of a complete acquisition | C:\Users\13658\Desktop\MECH 5720\Major\code\hadamard_results\20261025_041555_865482\hadamard_data.npz
NLOS | Hadamard | 64x64 | ZeroFilled | 0.5 | 0.5 | 2048 | 4096 | 4096 | 8192 | 0.5207121931238394 | Full-sampling internal reference; not independent ground truth | Retrospective subsets of a complete acquisition | C:\Users\13658\Desktop\MECH 5720\Major\code\hadamard_results\20261025_041555_865482\hadamard_data.npz
NLOS | Hadamard | 64x64 | TV_ADMM | 0.5 | 0.5 | 2048 | 4096 | 4096 | 8192 | 0.6288402339627459 | Full-sampling internal reference; not independent ground truth | Retrospective subsets of a complete acquisition | C:\Users\13658\Desktop\MECH 5720\Major\code\hadamard_results\20261025_041555_865482\hadamard_data.npz
NLOS | Hadamard | 64x64 | ZeroFilled | 0.25 | 0.25 | 1024 | 4096 | 2048 | 8192 | 0.37288933718652845 | Full-sampling internal reference; not independent ground truth | Retrospective subsets of a complete acquisition | C:\Users\13658\Desktop\MECH 5720\Major\code\hadamard_results\20261025_041555_865482\hadamard_data.npz
NLOS | Hadamard | 64x64 | TV_ADMM | 0.25 | 0.25 | 1024 | 4096 | 2048 | 8192 | 0.4368921613918815 | Full-sampling internal reference; not independent ground truth | Retrospective subsets of a complete acquisition | C:\Users\13658\Desktop\MECH 5720\Major\code\hadamard_results\20261025_041555_865482\hadamard_data.npz
NLOS | Hadamard | 64x64 | ZeroFilled | 0.1 | 0.10009765625 | 410 | 4096 | 820 | 8192 | 0.19367132736849113 | Full-sampling internal reference; not independent ground truth | Retrospective subsets of a complete acquisition | C:\Users\13658\Desktop\MECH 5720\Major\code\hadamard_results\20261025_041555_865482\hadamard_data.npz
NLOS | Hadamard | 64x64 | TV_ADMM | 0.1 | 0.10009765625 | 410 | 4096 | 820 | 8192 | 0.17501959244174875 | Full-sampling internal reference; not independent ground truth | Retrospective subsets of a complete acquisition | C:\Users\13658\Desktop\MECH 5720\Major\code\hadamard_results\20261025_041555_865482\hadamard_data.npz
NLOS | Fourier | 64x64 | ZeroFilled | 1.0 | 1.0 | 2050 | 2050 | 8200 | 8200 | 1.0 | Full-sampling internal reference; not independent ground truth | Retrospective subsets of a complete acquisition | C:\Users\13658\Desktop\MECH 5720\Major\code\fourier_results\20261025_080248_743060\fourier_data.npz
NLOS | Fourier | 64x64 | TV_ADMM | 1.0 | 1.0 | 2050 | 2050 | 8200 | 8200 | 0.9681595812173144 | Full-sampling internal reference; not independent ground truth | Retrospective subsets of a complete acquisition | C:\Users\13658\Desktop\MECH 5720\Major\code\fourier_results\20261025_080248_743060\fourier_data.npz
NLOS | Fourier | 64x64 | ZeroFilled | 0.5 | 0.5 | 1025 | 2050 | 4100 | 8200 | 0.602240985383804 | Full-sampling internal reference; not independent ground truth | Retrospective subsets of a complete acquisition | C:\Users\13658\Desktop\MECH 5720\Major\code\fourier_results\20261025_080248_743060\fourier_data.npz
NLOS | Fourier | 64x64 | TV_ADMM | 0.5 | 0.5 | 1025 | 2050 | 4100 | 8200 | 0.5384187684106608 | Full-sampling internal reference; not independent ground truth | Retrospective subsets of a complete acquisition | C:\Users\13658\Desktop\MECH 5720\Major\code\fourier_results\20261025_080248_743060\fourier_data.npz
NLOS | Fourier | 64x64 | ZeroFilled | 0.25 | 0.2497560975609756 | 512 | 2050 | 2048 | 8200 | 0.3666058882949119 | Full-sampling internal reference; not independent ground truth | Retrospective subsets of a complete acquisition | C:\Users\13658\Desktop\MECH 5720\Major\code\fourier_results\20261025_080248_743060\fourier_data.npz
NLOS | Fourier | 64x64 | TV_ADMM | 0.25 | 0.2497560975609756 | 512 | 2050 | 2048 | 8200 | 0.30226388817661987 | Full-sampling internal reference; not independent ground truth | Retrospective subsets of a complete acquisition | C:\Users\13658\Desktop\MECH 5720\Major\code\fourier_results\20261025_080248_743060\fourier_data.npz
NLOS | Fourier | 64x64 | ZeroFilled | 0.1 | 0.1 | 205 | 2050 | 820 | 8200 | 0.23098820423687255 | Full-sampling internal reference; not independent ground truth | Retrospective subsets of a complete acquisition | C:\Users\13658\Desktop\MECH 5720\Major\code\fourier_results\20261025_080248_743060\fourier_data.npz
NLOS | Fourier | 64x64 | TV_ADMM | 0.1 | 0.1 | 205 | 2050 | 820 | 8200 | 0.12958511125384792 | Full-sampling internal reference; not independent ground truth | Retrospective subsets of a complete acquisition | C:\Users\13658\Desktop\MECH 5720\Major\code\fourier_results\20261025_080248_743060\fourier_data.npz
