GuoJiashu/mech5720-2026-single_pixel_imaging/analyze/fourier_snr_results/fourier_snr_summary.csv

Scene | Resolution | Grid_Size | Acquired_Groups | Expected_Groups | Valid_NonDC_Pairs | Complete_Flag | Duration_min | Median_Coefficient_Magnitude_ADC | Median_Noise_Proxy_ADC | SNR_P10_dB | Median_SNR_Proxy_dB | SNR_P90_dB | Fraction_SNR_Above_0dB_pct | DC_Real_Difference_ADC | Black_Reference_Count | Source_File
Direct_Scene | 16x16 | 16 | 130 | 130 | 126 | True | 14.404881 | 10.007789 | 21.676545 | -18.967370 | -6.798228 | 4.879398 | 22.222222 | 685.528000 | 10 | C:\Users\13658\Desktop\MECH 5720\Major\code\fourier_results\20261023_213635_003130\fourier_data.npz
Direct_Scene | 32x32 | 32 | 514 | 514 | 510 | True | 56.673260 | 3.431254 | 21.690873 | -26.371010 | -16.019729 | -2.485206 | 6.078431 | 684.648100 | 34 | C:\Users\13658\Desktop\MECH 5720\Major\code\fourier_results\20261023_215608_700959\fourier_data.npz
Direct_Scene | 64x64 | 64 | 2050 | 2050 | 2046 | True | 225.764181 | 1.226373 | 21.556254 | -35.703356 | -24.869646 | -5.908587 | 1.612903 | 671.776100 | 130 | C:\Users\13658\Desktop\MECH 5720\Major\code\fourier_results\20261024_052155_912611\fourier_data.npz
NLOS | 16x16 | 16 | 130 | 130 | 126 | True | 14.444003 | 8.277000 | 7.846080 | -10.154370 | 0.490063 | 12.016826 | 51.587302 | 302.336000 | 10 | C:\Users\13658\Desktop\MECH 5720\Major\code\fourier_results\20261024_222205_895619\fourier_data.npz
NLOS | 32x32 | 32 | 514 | 514 | 510 | True | 56.926574 | 3.028232 | 8.021560 | -18.554335 | -8.473266 | 6.596578 | 21.960784 | 302.936000 | 34 | C:\Users\13658\Desktop\MECH 5720\Major\code\fourier_results\20261025_002849_105656\fourier_data.npz
NLOS | 64x64 | 64 | 2050 | 2050 | 2046 | True | 226.824159 | 1.248320 | 7.856106 | -26.233285 | -15.832533 | 0.210265 | 10.508309 | 262.216000 | 130 | C:\Users\13658\Desktop\MECH 5720\Major\code\fourier_results\20261025_080248_743060\fourier_data.npz
