GuoJiashu/mech5720-2026-single_pixel_imaging/analyze/hadamard_snr_results/hadamard_snr_summary.csv

Scene | Method | Resolution | Grid_Size | Total_Hadamard_Rows | Measured_Rows_Including_DC | Valid_NonDC_Rows | Median_Abs_Differential_ADC | Mean_Abs_Differential_ADC | Median_Noise_Proxy_ADC | Mean_Noise_Proxy_ADC | Median_SNR_Proxy_dB | P10_SNR_Proxy_dB | P90_SNR_Proxy_dB | Fraction_SNR_Proxy_Above_0_dB | Fraction_SNR_Proxy_Above_10_dB | DC_Differential_ADC | Source_File
Direct_Scene | Hadamard | 16x16 | 16 | 256 | 256 | 255 | 9.272300 | 16.567065 | 15.242327 | 15.241105 | -4.329363 | -23.575895 | 6.568828 | 0.286275 | 0.058824 | 688.007900 | C:\Users\13658\Desktop\MECH 5720\Major\code\hadamard_results\20261023_191716_313850\hadamard_data.npz
Direct_Scene | Hadamard | 32x32 | 32 | 1024 | 1024 | 1023 | 2.991800 | 6.816676 | 15.330944 | 15.332499 | -14.210127 | -30.735645 | -0.854977 | 0.086022 | 0.015640 | 685.495900 | C:\Users\13658\Desktop\MECH 5720\Major\code\hadamard_results\20261023_200537_930670\hadamard_data.npz
Direct_Scene | Hadamard | 64x64 | 64 | 4096 | 4096 | 4095 | 0.968000 | 2.580931 | 15.270257 | 15.265281 | -23.938788 | -40.394867 | -9.593360 | 0.021978 | 0.003663 | 683.992300 | C:\Users\13658\Desktop\MECH 5720\Major\code\hadamard_results\20261024_013607_094384\hadamard_data.npz
NLOS | Hadamard | 16x16 | 16 | 256 | 256 | 255 | 6.808000 | 13.091264 | 6.032707 | 6.039384 | 0.969685 | -11.445572 | 14.622929 | 0.545098 | 0.180392 | 305.896000 | C:\Users\13658\Desktop\MECH 5720\Major\code\hadamard_results\20261024_220710_549725\hadamard_data.npz
NLOS | Hadamard | 32x32 | 32 | 1024 | 1024 | 1023 | 2.688000 | 5.470704 | 5.938548 | 5.956468 | -6.909689 | -22.164536 | 5.514110 | 0.220919 | 0.044966 | 300.015900 | C:\Users\13658\Desktop\MECH 5720\Major\code\hadamard_results\20261024_232029_873143\hadamard_data.npz
NLOS | Hadamard | 64x64 | 64 | 4096 | 4096 | 4095 | 0.928000 | 2.272679 | 5.808734 | 5.759512 | -15.894604 | -32.071028 | -0.915125 | 0.084982 | 0.010256 | 221.495900 | C:\Users\13658\Desktop\MECH 5720\Major\code\hadamard_results\20261025_041555_865482\hadamard_data.npz
