GuoJiashu/mech5720-2026-single_pixel_imaging/analyze/hadamard_snr_results/Direct_Scene_hadamard_acquisition_order.png

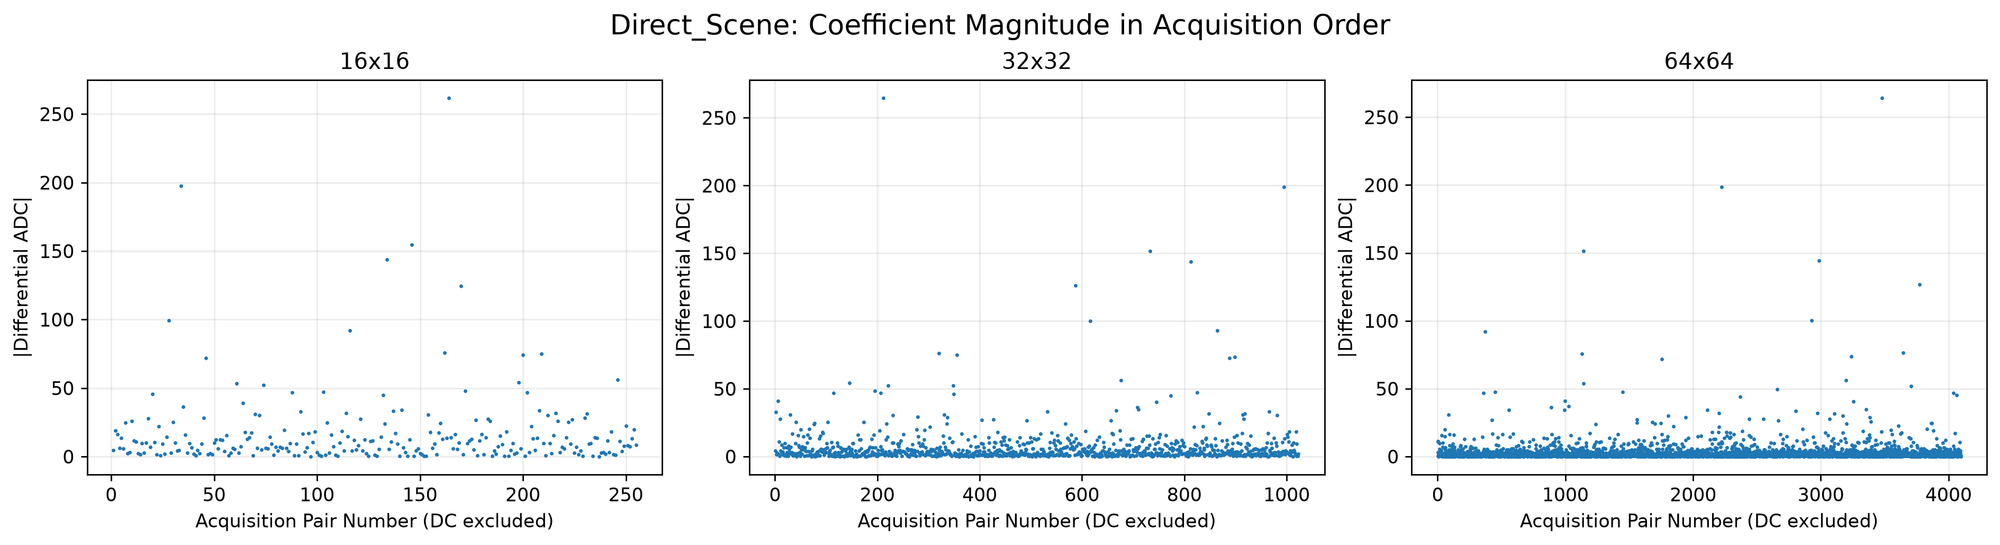
analyze/hadamard_snr_results/Direct_Scene_hadamard_acquisition_order.png
