GuoJiashu/mech5720-2026-single_pixel_imaging/model/Lens Holder.stl

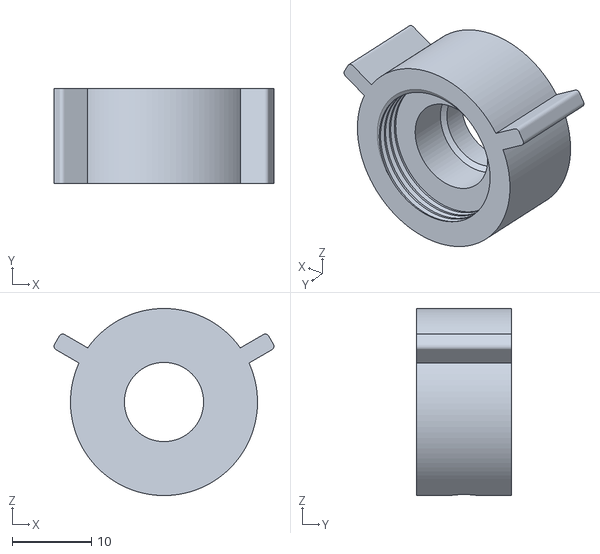
[picture p43: CAD file, 2026-10-23]
model/Lens Holder.stl
27.8 x 12.0 x 23.6
