GuoJiashu/mech5720-2026-single_pixel_imaging/model/Lens Holder Cap.stl

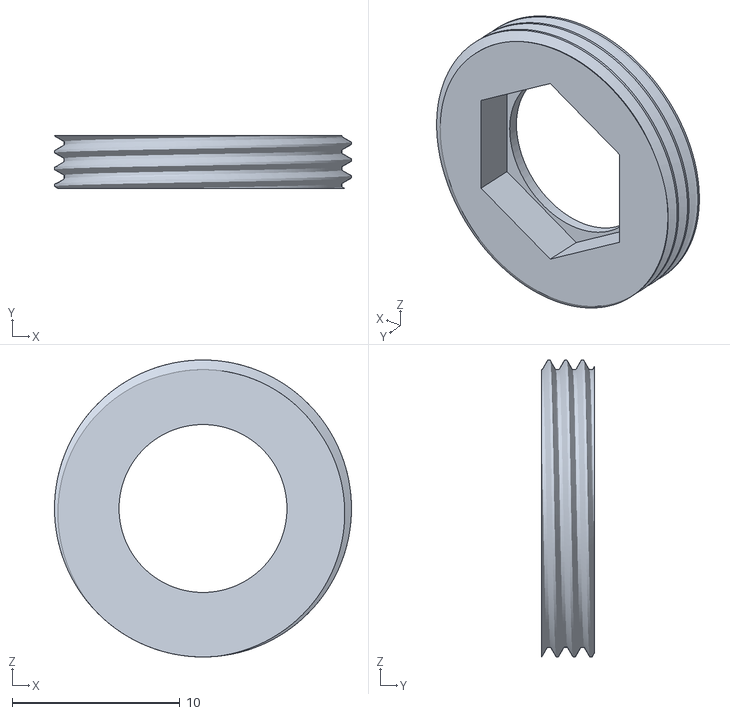
[picture p44: CAD file, 2026-10-23]
model/Lens Holder Cap.stl
17.7 x 3.15 x 17.7
