GuoJiashu/mech5720-2026-single_pixel_imaging/model/LDR_stander.SLDPRT

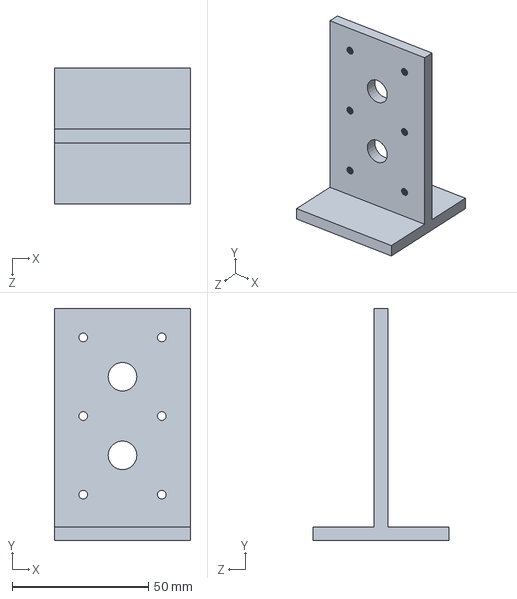
[picture p45: CAD file, 2026-10-23]
model/LDR_stander.SLDPRT
50.0 x 85.0 x 50.0 mm
