GuoJiashu/mech5720-2026-single_pixel_imaging/model/holder_tube.stl

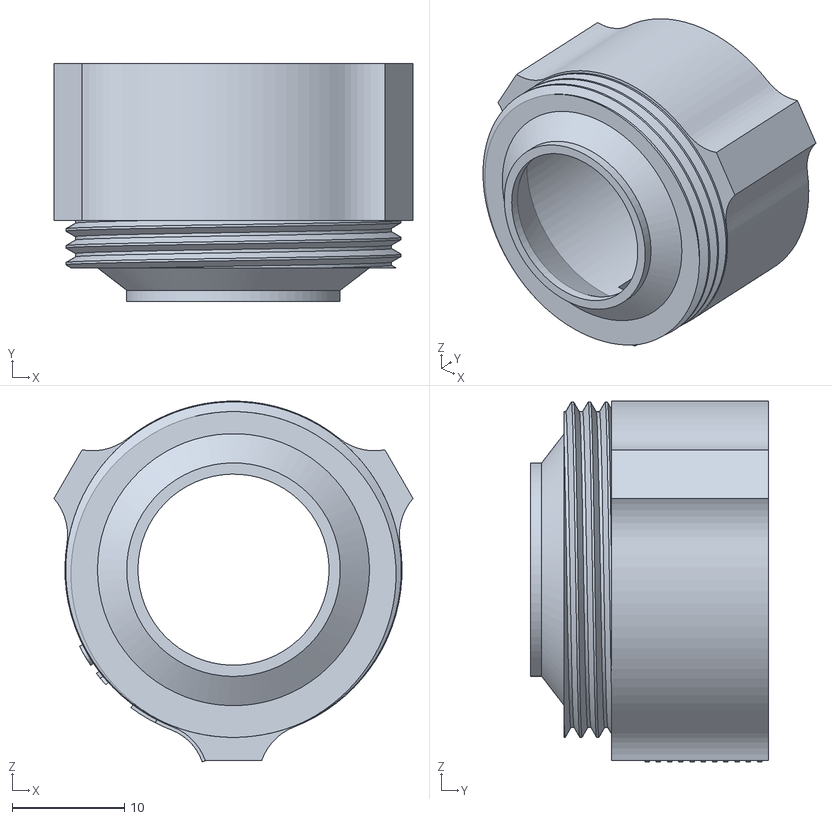
[picture p46: CAD file, 2026-10-23]
model/holder_tube.stl
31.9 x 21.2 x 32.1
