GuoJiashu/mech5720-2026-single_pixel_imaging/model/LDR_holder.SLDPRT

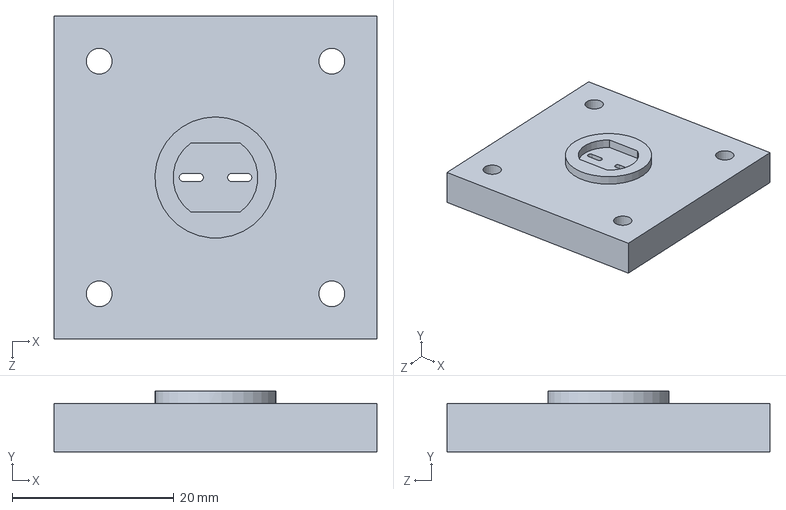
[picture p47: CAD file, 2026-10-23]
model/LDR_holder.SLDPRT
40.0 x 7.50 x 40.0 mm
