GuoJiashu/mech5720-2026-single_pixel_imaging/model/Lens Base.stl

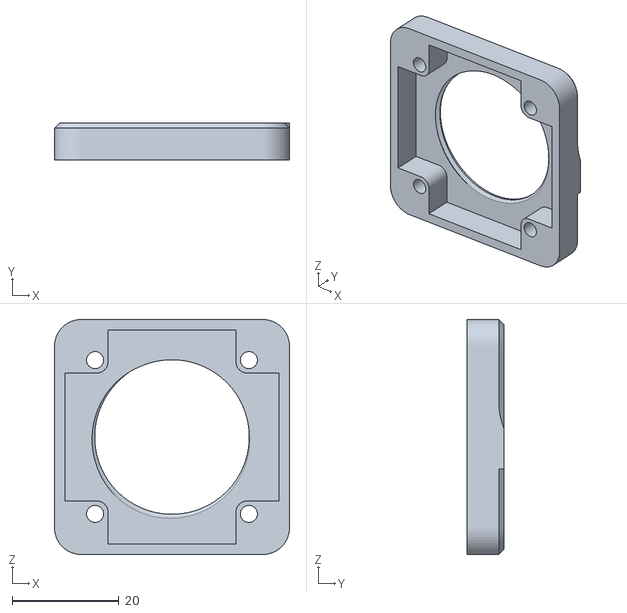
[picture p48: CAD file, 2026-10-23]
model/Lens Base.stl
44.0 x 7.00 x 44.0
