GuoJiashu/mech5720-2026-single_pixel_imaging/model/USYD.SLDPRT

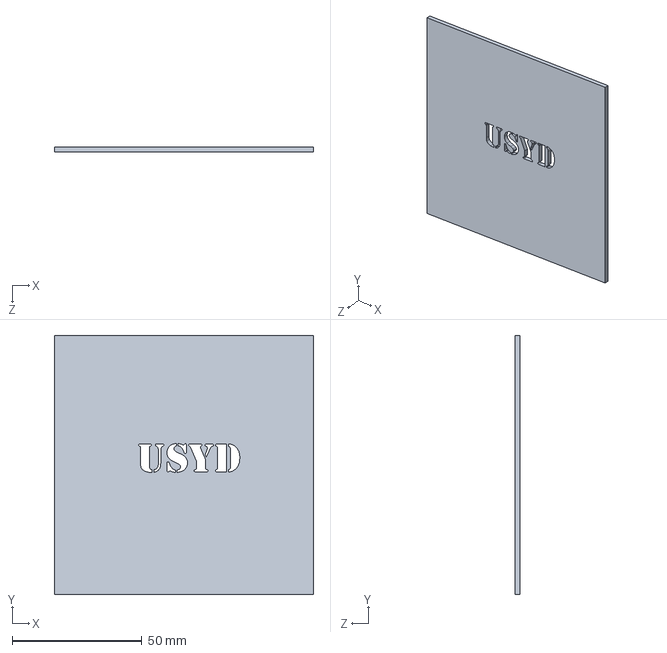
[picture p49: CAD file, 2026-10-23]
model/USYD.SLDPRT
100.0 x 100.0 x 2.00 mm
