GuoJiashu/mech5720-2026-single_pixel_imaging/model/A4_FoamBoard_Holder_5mm.SLDPRT

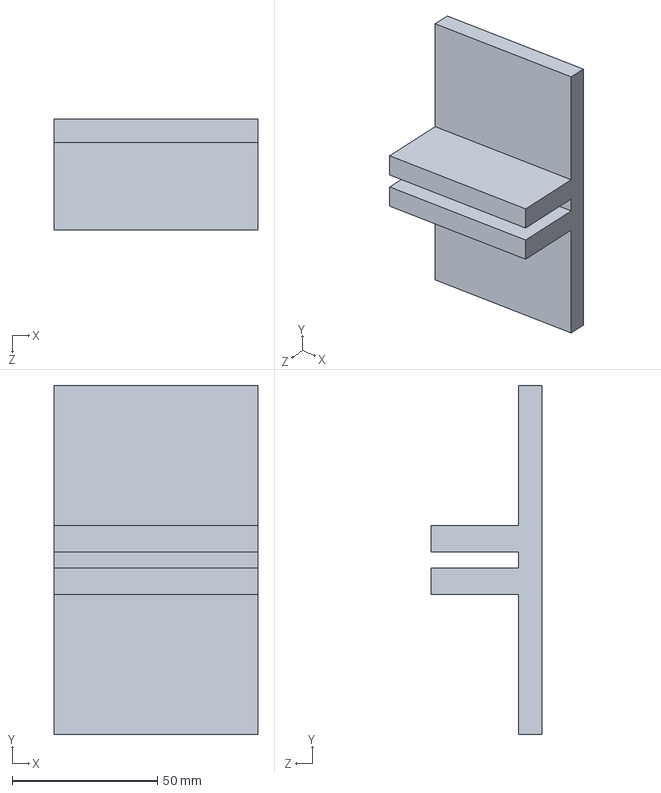
[picture p50: CAD file, 2026-10-23]
model/A4_FoamBoard_Holder_5mm.SLDPRT
70.0 x 120.0 x 38.0 mm
