GuoJiashu/mech5720-2026-single_pixel_imaging/model/holder.SLDPRT

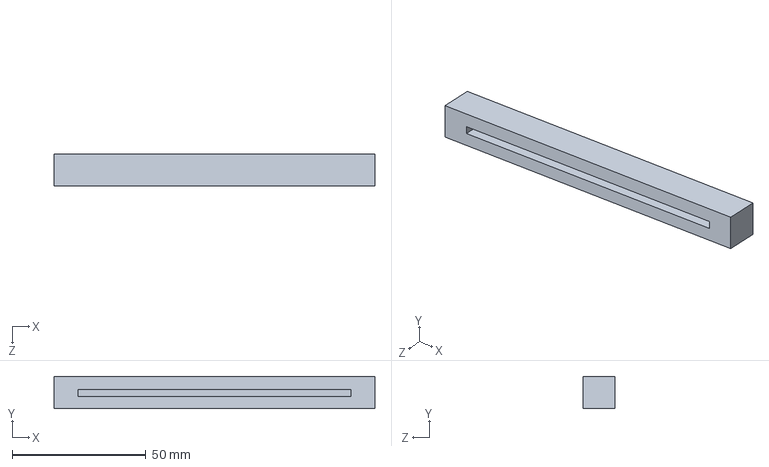
[picture p51: CAD file, 2026-10-23]
model/holder.SLDPRT
120.0 x 12.0 x 12.0 mm
