GuoJiashu/mech5720-2026-single_pixel_imaging/(list of files, cad)

Other CAD files:
model/TRON.SLDPRT
model/A4_FoamBoard_Holder_5mm.stl
model/LDR_holder.STL
model/LDR_stander.STL
model/Lens Holder Cap.f3d
model/Lens Holder.f3d
model/TRON.STL
model/USYD.STL
model/holder.STL
model/holder_tube.f3d
