GuoJiashu/mech5720-2026-single_pixel_imaging/fourier_results/20261024_222205_895619/reconstruction_corrected/fourier_coefficients.csv

fy | fx | real | imag | magnitude
1 | 12 | -5.955271983079598 | 7.828728104302627 | 9.836373728338641
3 | 5 | -0.07528908238236909 | 5.428710646267319 | 5.4292327014802115
6 | 1 | 0.6526151481439513 | 8.99670645435424 | 9.020345534257885
8 | 6 | -0.49928851228219173 | -2.107171958007484 | 2.165516723350355
3 | 8 | -0.6512849154356388 | -2.531263123729161 | 2.613707145535842
2 | 10 | 3.0687197822575456 | -0.947271839523097 | 3.2115985178680524
1 | 0 | -92.21928938039167 | 35.82871079342064 | 98.93479595644293
5 | 9 | -0.52328075726939 | 0.7807154258416347 | 0.9398613339612983
0 | 3 | -51.67527182629945 | 37.42873273027041 | 63.80629868685343
2 | 8 | 8.636832659074031 | 4.8207323421283945 | 9.891124238189029
5 | 5 | -9.475276380118743 | -10.899271394572025 | 14.442125169523084
4 | 6 | -6.987384368820756 | -5.067284848576577 | 8.631391316251069
6 | 2 | 8.844692998339696 | 10.756702211556359 | 13.92606321624962
1 | 11 | 12.732727851148127 | -2.787267342089649 | 13.034232534663584
5 | 2 | -3.26726748881984 | -6.00326760698681 | 6.8347830107909235
7 | 1 | -1.8752798605967484 | 9.236732360218383 | 9.425173698657506
6 | 9 | -18.42131626566652 | -4.917423441735025 | 19.066356397199623
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
