GuoJiashu/mech5720-2026-single_pixel_imaging/fourier_results/20261024_222205_895619/reconstruction_corrected/fourier_raw_corrected.csv

freq_index | fy | fx | phase_deg | time_s | measurement_id | mean_adc | std_adc | min_adc | max_adc | n_samples | capture_ms | estimated_black_adc | corrected_adc
0 | 1 | 12 | 0 | 10.732011299995065 | 1 | 146.248 | 4.7001 | 137 | 157 | 125 | 496 | 1.2143451235876108 | 145.03365487641238
0 | 1 | 12 | 90 | 12.276348799998232 | 2 | 162.728 | 4.1258 | 153 | 171 | 125 | 496 | 1.212711375051895 | 161.5152886249481
0 | 1 | 12 | 180 | 13.824926799999957 | 3 | 152.2 | 3.3745 | 145 | 161 | 125 | 496 | 1.2110731405079955 | 150.98892685949198
0 | 1 | 12 | 270 | 15.3691816999999 | 4 | 154.896 | 4.0438 | 145 | 166 | 125 | 496 | 1.2094394793544965 | 153.6865605206455
1 | 3 | 5 | 0 | 16.917511899999226 | 5 | 162.04 | 3.9419 | 153 | 174 | 125 | 496 | 1.2078015069572399 | 160.83219849304274
1 | 3 | 5 | 90 | 18.4659171999956 | 6 | 165.448 | 4.2378 | 156 | 174 | 125 | 496 | 1.2061634551119933 | 164.241836544888
1 | 3 | 5 | 180 | 20.026590899993607 | 7 | 162.112 | 4.1547 | 153 | 171 | 125 | 496 | 1.2045124245748882 | 160.9074875754251
1 | 3 | 5 | 270 | 21.57525270000042 | 8 | 160.016 | 3.7178 | 152 | 168 | 125 | 496 | 1.2028741013792945 | 158.81312589862068
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
