GuoJiashu/mech5720-2026-single_pixel_imaging/fourier_results/20261025_002849_105656/reconstruction_corrected/fourier_coefficients.csv

fy | fx | real | imag | magnitude
14 | 9 | -19.922050087466715 | -4.066060645470799 | 20.33275507303865
11 | 17 | -0.7380366804003131 | -1.2180362612777742 | 1.4241876545609613
3 | 20 | -1.954102200741886 | 1.5818105231062702 | 2.5140882923942858
10 | 11 | 3.2458960179064604 | 5.341897961405124 | 6.250737139660028
5 | 12 | -1.54608563229408 | 2.7260336288945837 | 3.133949605250595
9 | 22 | -1.5141009220135686 | -1.5781015405025585 | 2.186985613619552
16 | 7 | -0.4741892260675229 | -0.5860869259101378 | 0.7538921055703606
8 | 11 | 0.76593681034214 | -0.3540902316379686 | 0.8438240868679452
1 | 18 | -2.6100900704618937 | -1.7860772828553593 | 3.162695406809792
3 | 11 | 2.645884702245297 | 1.6058835448845343 | 3.095087691375901
7 | 9 | 0.6299368902828633 | -0.03408892572335276 | 0.6308585741639852
13 | 17 | -1.3541148802503926 | 0.14189907410263913 | 1.3615294547481231
3 | 0 | 7.40591124969319 | 25.58194882346197 | 26.63237929747471
9 | 15 | -3.7940899076675976 | 0.03789846402855801 | 3.7942791833286127
6 | 15 | -0.9861164013900918 | -0.058091025219766834 | 0.9878259585076858
13 | 7 | -1.274214499641829 | -1.35409020509897 | 1.8593501215861545
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
