GuoJiashu/mech5720-2026-single_pixel_imaging/fourier_results/20261025_002849_105656/reconstruction_corrected/fourier_raw_corrected.csv

freq_index | fy | fx | phase_deg | time_s | measurement_id | mean_adc | std_adc | min_adc | max_adc | n_samples | capture_ms | estimated_black_adc | corrected_adc
0 | 14 | 9 | 0 | 10.7133857000008 | 1 | 137.064 | 4.6848 | 126 | 150 | 125 | 496 | 1.058936863206632 | 136.00506313679335
0 | 14 | 9 | 90 | 12.26686989999871 | 2 | 154.072 | 4.3703 | 142 | 164 | 125 | 496 | 1.0539090621648435 | 153.01809093783515
0 | 14 | 9 | 180 | 13.818650200002594 | 3 | 156.976 | 3.6621 | 149 | 164 | 125 | 496 | 1.0488867757399176 | 155.92711322426007
0 | 14 | 9 | 270 | 15.375396600000386 | 4 | 158.128 | 3.7265 | 148 | 166 | 125 | 496 | 1.0438484166940258 | 157.08415158330595
1 | 11 | 17 | 0 | 16.931712600002356 | 5 | 159.344 | 3.9022 | 149 | 168 | 125 | 496 | 1.0388114506237096 | 158.30518854937628
1 | 11 | 17 | 90 | 18.489355500001693 | 6 | 159.112 | 3.6283 | 150 | 168 | 125 | 496 | 1.0337701900847471 | 158.07822980991526
1 | 11 | 17 | 180 | 20.03283460000239 | 7 | 160.072 | 3.9333 | 150 | 168 | 125 | 496 | 1.0287747702233976 | 159.0432252297766
1 | 11 | 17 | 270 | 21.59034800000518 | 8 | 160.32 | 4.1593 | 150 | 169 | 125 | 496 | 1.0237339288069582 | 159.29626607119303
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
