GuoJiashu/mech5720-2026-single_pixel_imaging/fourier_results/20261025_080248_743060/reconstruction_corrected/fourier_coefficients.csv

fy | fx | real | imag | magnitude
30 | 45 | -6.996901854868867 | -1.8609033531860177 | 7.240137903145654
29 | 24 | 0.042990387718731427 | 0.07509629237316062 | 0.08653107282590501
19 | 43 | 0.8753968240343397 | 1.955132090856381 | 2.142162713760524
9 | 42 | 0.9474659012348638 | -0.32495908841121945 | 1.0016436707451624
13 | 33 | 1.0351350310997418 | 0.10694751707046635 | 1.0406451383720587
20 | 23 | 0.03460325069966075 | 0.7311414915831165 | 0.7319598798249587
9 | 4 | 3.098754192923451 | -2.884973781577145 | 4.233834109710512
11 | 45 | -0.6461208323998449 | 1.5700446101908199 | 1.6977962799023658
14 | 10 | 0.12279855436463549 | -1.0850813391973304 | 1.092007782769114
29 | 3 | -0.8766351459763939 | 0.835654182129133 | 1.21111811615175
21 | 22 | 3.5708874716407593 | 4.858793833861881 | 6.029851976217589
24 | 27 | 0.4911468645775585 | 0.859049490658947 | 0.9895409390145326
2 | 34 | -1.2934212943000603 | 0.22658673540308882 | 1.3131184993021279
11 | 4 | 0.47481132227517264 | -0.11696798164214783 | 0.4890064421765174
23 | 30 | -0.062234301135248415 | 0.5934778529652363 | 0.596731991934419
10 | 35 | 0.4428191360751157 | 0.4434380293289166 | 0.6266786043335332
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
