GuoJiashu/mech5720-2026-single_pixel_imaging/fourier_results/20261025_080248_743060/reconstruction_corrected/fourier_raw_corrected.csv

freq_index | fy | fx | phase_deg | time_s | measurement_id | mean_adc | std_adc | min_adc | max_adc | n_samples | capture_ms | estimated_black_adc | corrected_adc
0 | 30 | 45 | 0 | 10.733819600005518 | 1 | 250.288 | 3.837 | 242 | 260 | 125 | 496 | 142.85340037675334 | 107.43459962324667
0 | 30 | 45 | 90 | 12.29429400000663 | 2 | 255.776 | 3.6186 | 247 | 264 | 125 | 496 | 142.97910383228873 | 112.79689616771128
0 | 30 | 45 | 180 | 13.850935400012531 | 3 | 257.536 | 3.8112 | 247 | 265 | 125 | 496 | 143.10449852188447 | 114.43150147811554
0 | 30 | 45 | 270 | 15.411391200002981 | 4 | 257.888 | 3.8168 | 243 | 266 | 125 | 496 | 143.23020047910268 | 114.6577995208973
1 | 29 | 24 | 0 | 16.97215810000489 | 5 | 257.6719 | 3.5646 | 250 | 265 | 125 | 496 | 143.35592749687072 | 114.31597250312927
1 | 29 | 24 | 90 | 18.525032200006535 | 6 | 257.968 | 3.7156 | 249 | 267 | 125 | 496 | 143.48101871296598 | 114.48698128703404
1 | 29 | 24 | 180 | 20.089177600006224 | 7 | 257.88 | 3.7964 | 251 | 265 | 125 | 496 | 143.60701788458945 | 114.27298211541054
1 | 29 | 24 | 270 | 21.642124999998487 | 8 | 258.144 | 3.7604 | 249 | 266 | 125 | 496 | 143.73211500533912 | 114.41188499466088
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
