GuoJiashu/mech5720-2026-single_pixel_imaging/3d_cali/results/spi_capture/20261029_203517_780684/plots/05_reconstruct_3d/3d/surface_3d.png

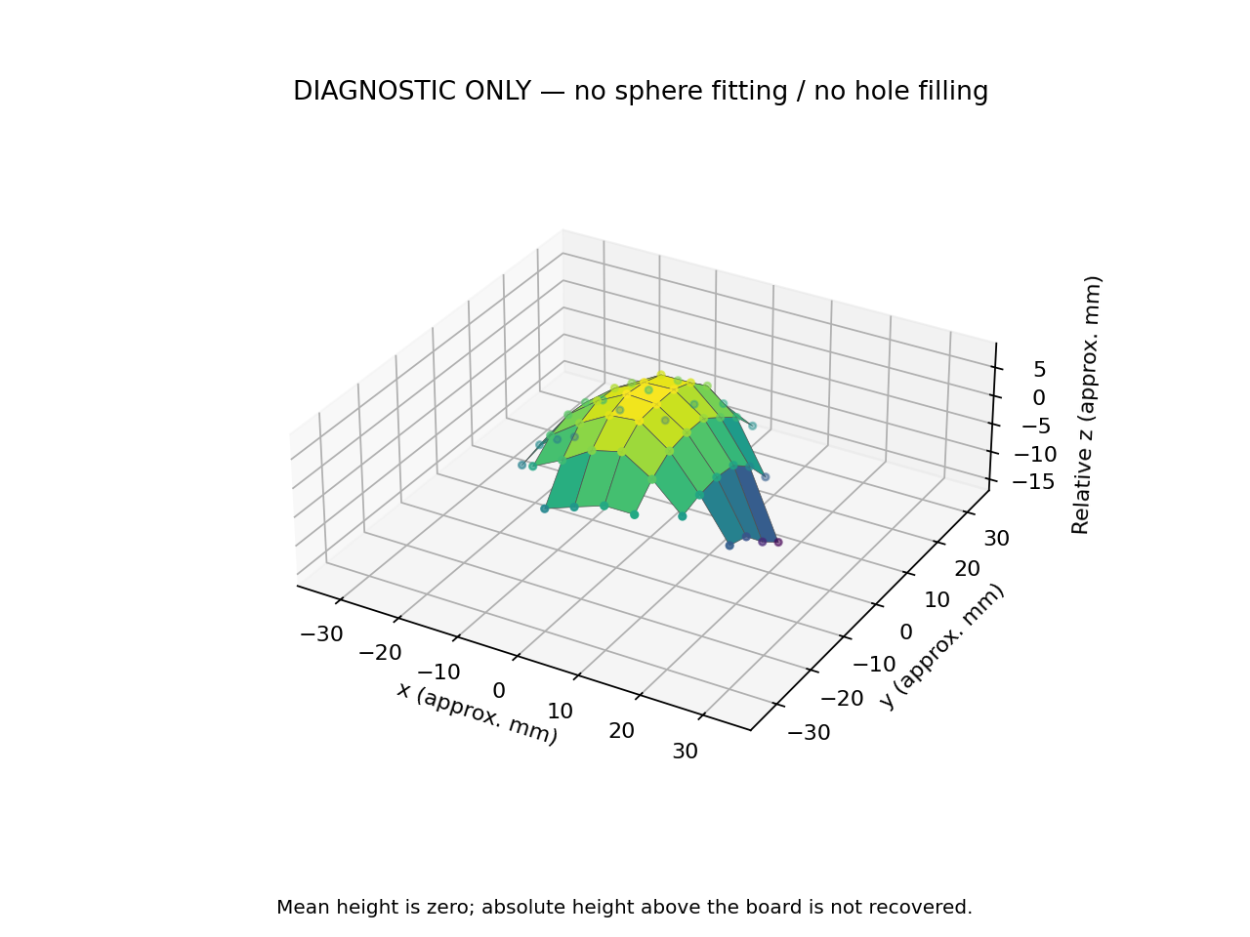
3d_cali/results/spi_capture/20261029_203517_780684/plots/05_reconstruct_3d/3d/surface_3d.png
