GuoJiashu/mech5720-2026-single_pixel_imaging/cali/results/ldr_timing/20261028_232909_437906/step_responses.png

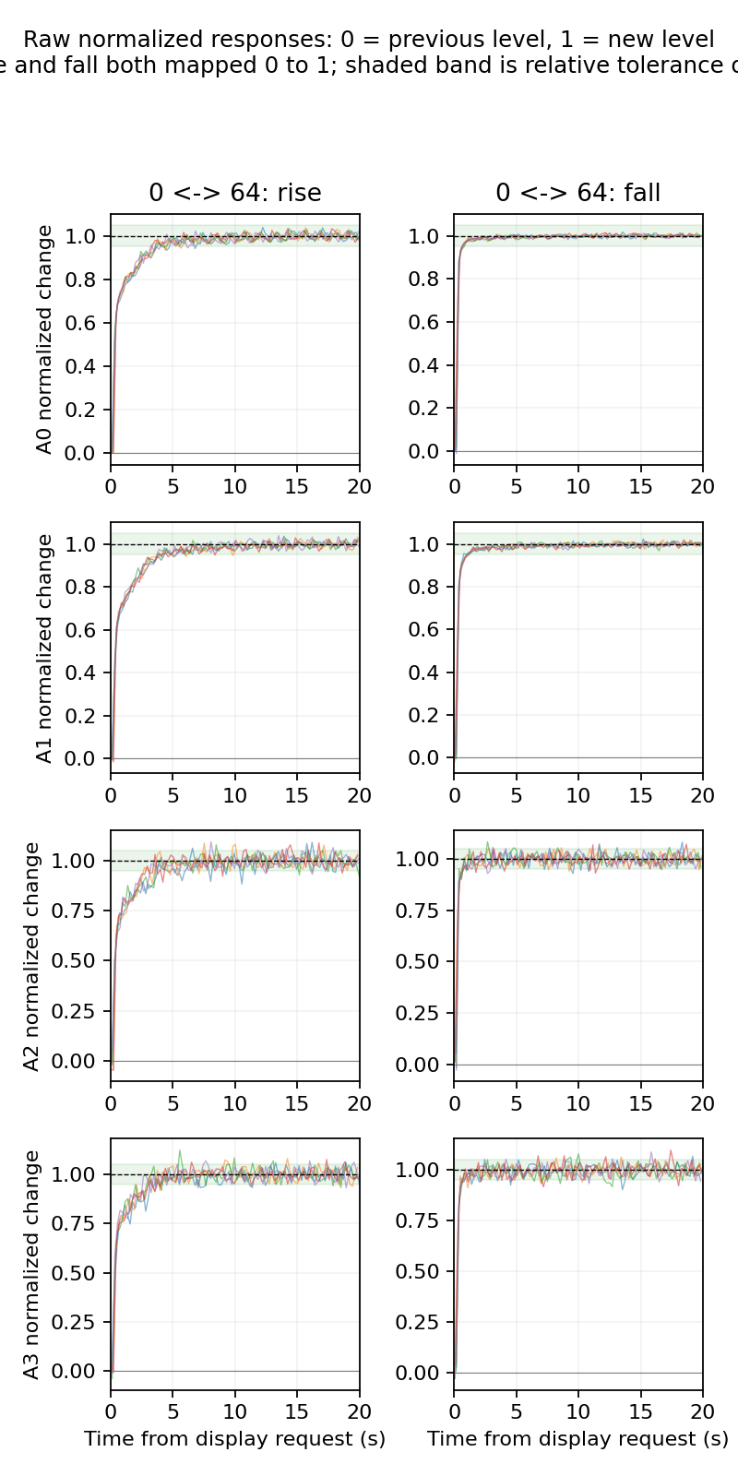
cali/results/ldr_timing/20261028_232909_437906/step_responses.png
