GuoJiashu/mech5720-2026-single_pixel_imaging/imaging_2d/results/calibration/ldr_timing/20261028_231529_496515/step_responses.png

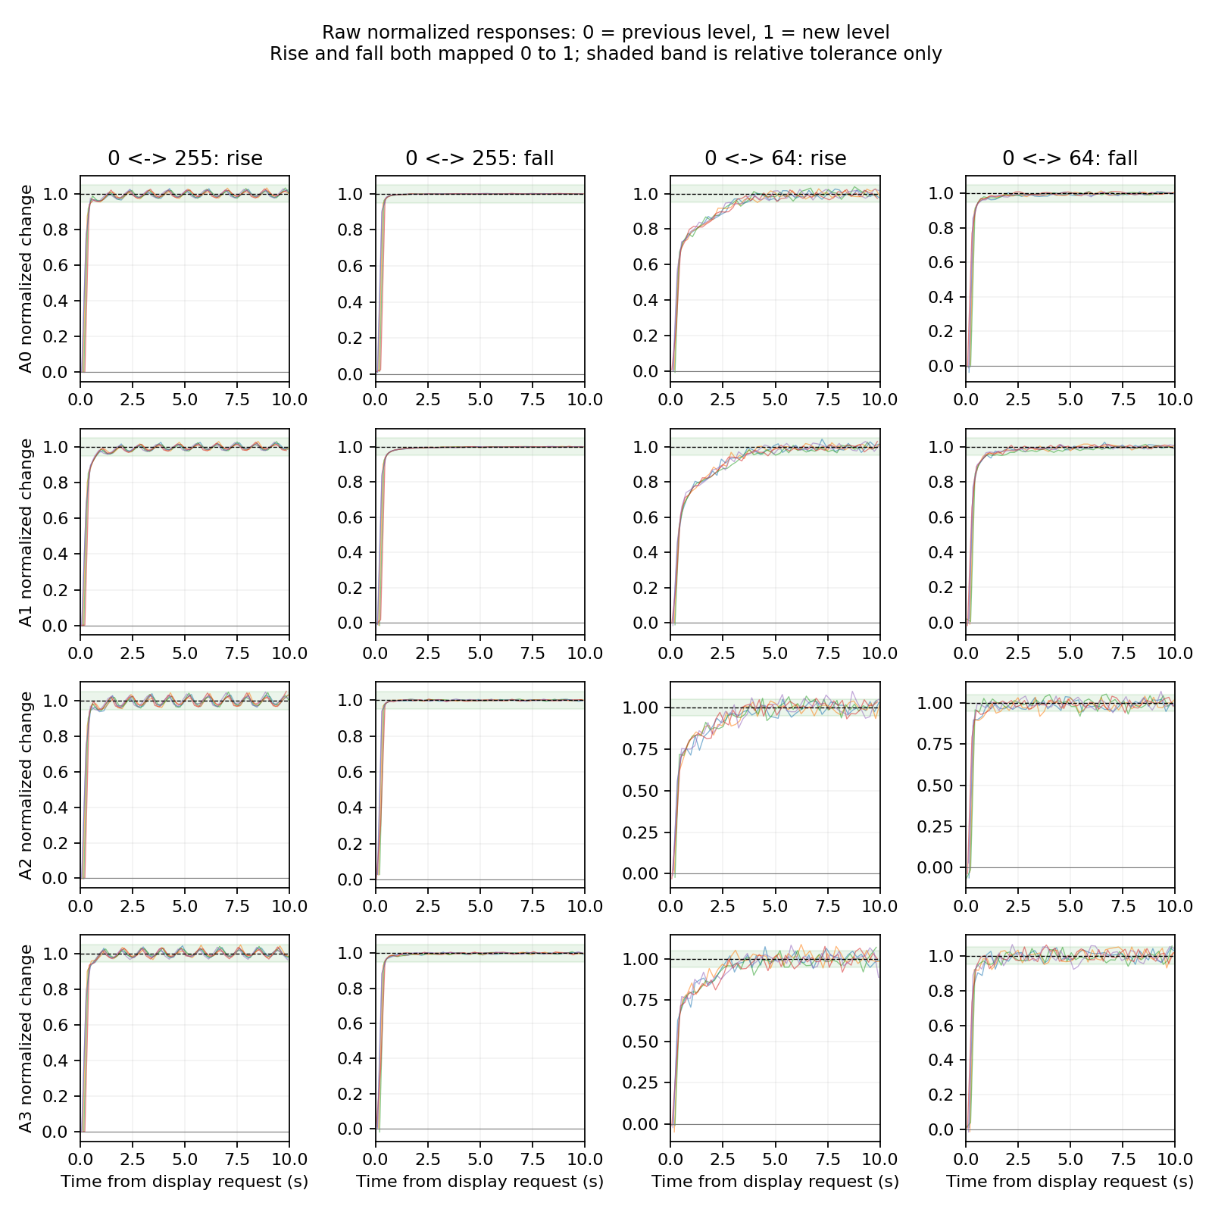
imaging_2d/results/calibration/ldr_timing/20261028_231529_496515/step_responses.png
