GuoJiashu/mech5720-2026-single_pixel_imaging/imaging_3d/results/calibration/ldr_timing/2026-11-07_17-41-25/02_plot_ldr_timing_test/step_responses.png

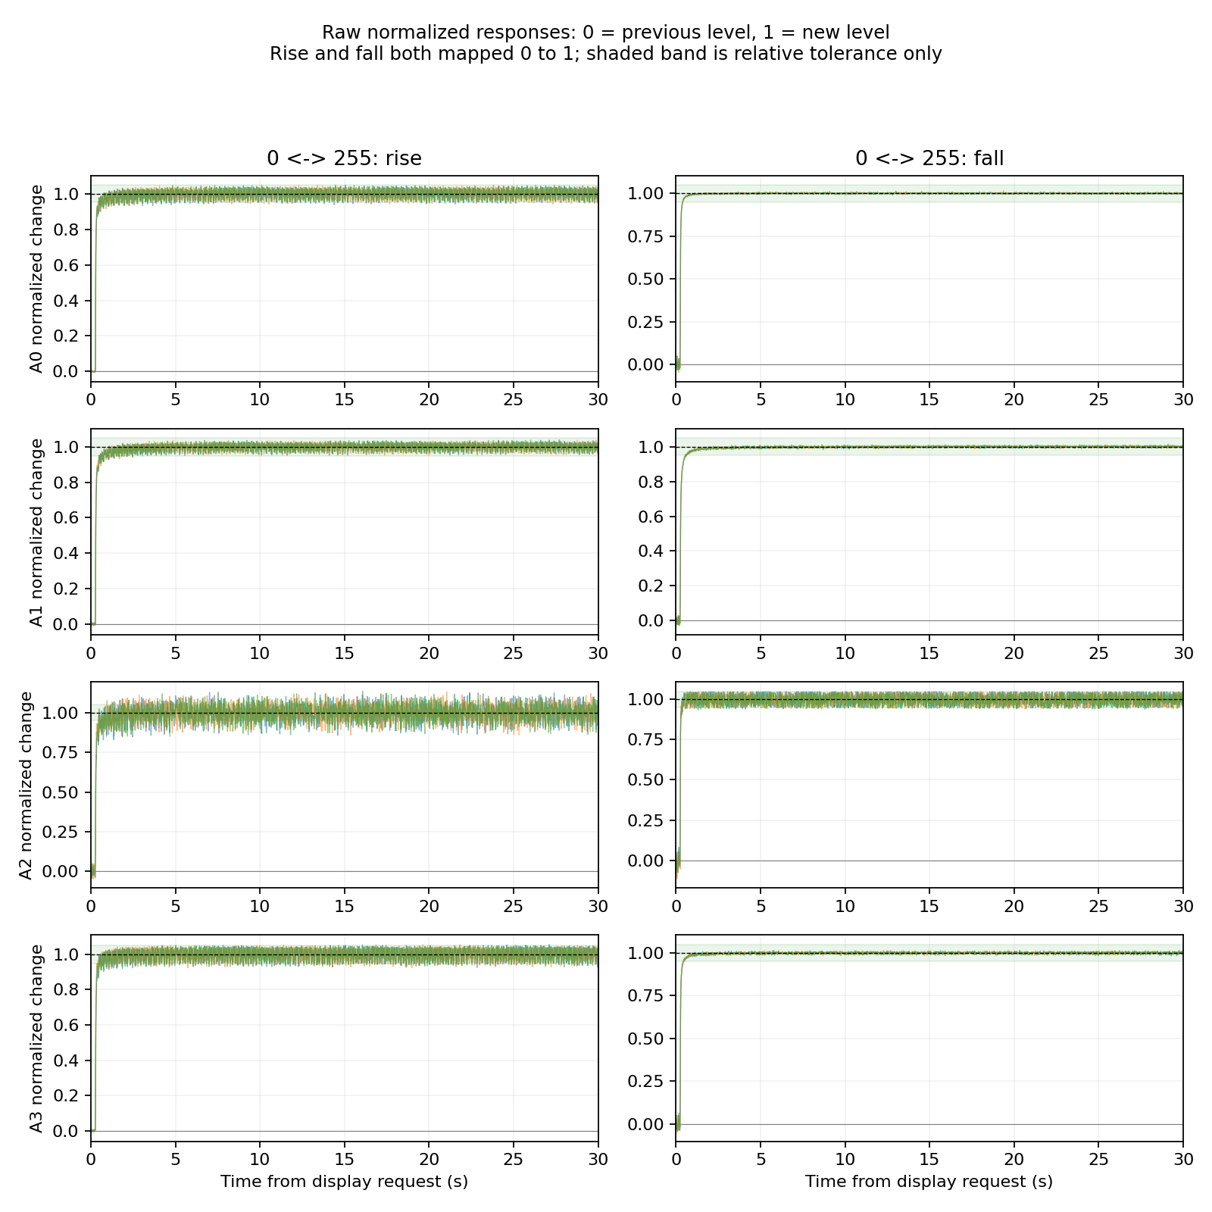
imaging_3d/results/calibration/ldr_timing/2026-11-07_17-41-25/02_plot_ldr_timing_test/step_responses.png
