GuoJiashu/mech5720-2026-single_pixel_imaging/imaging_3d/results/hadamard_capture/2026-11-07_12-58-59/05_reconstruct_3d/3d/surface_3d.png

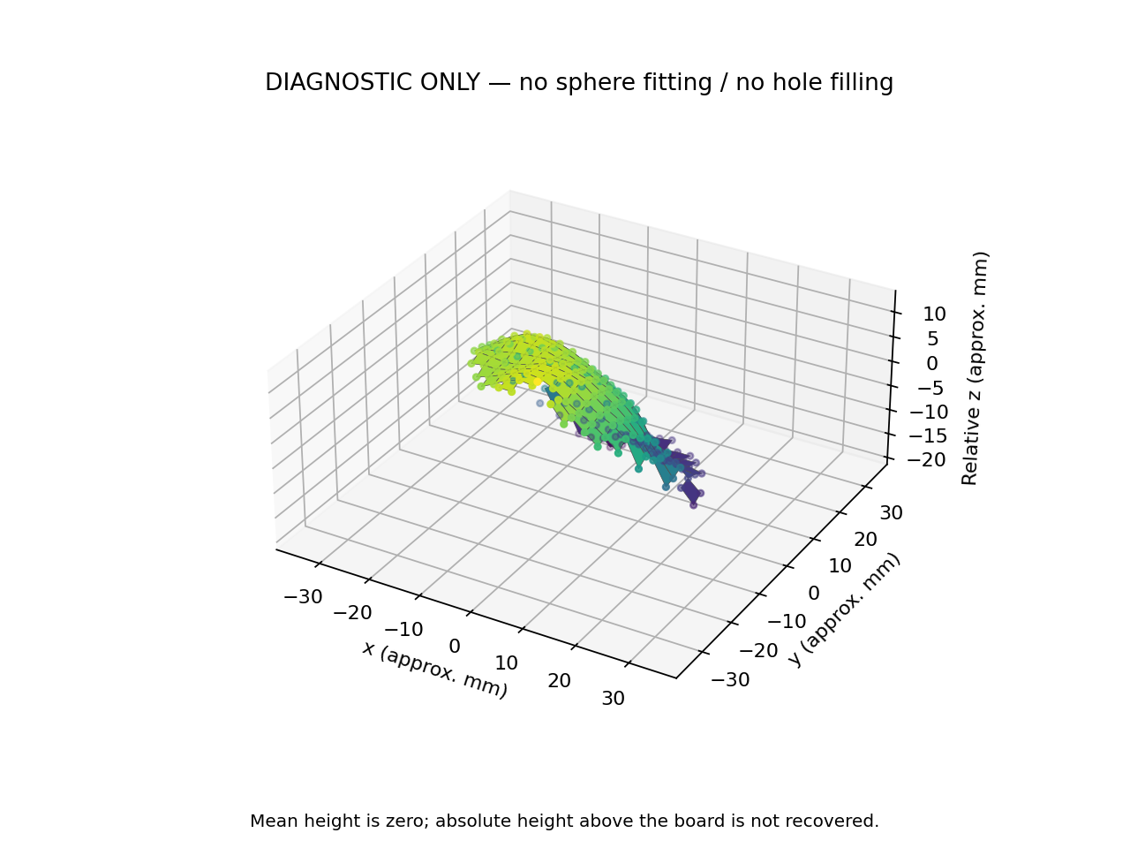
imaging_3d/results/hadamard_capture/2026-11-07_12-58-59/05_reconstruct_3d/3d/surface_3d.png
