GuoJiashu/mech5720-2026-single_pixel_imaging/analyze/image_cnr_results/image_cnr_summary.csv

Scene | Method | Resolution | Grid_Size | Signal_Pixels | Background_Pixels | Signal_Mean | Background_Mean | Background_Spatial_Std | Absolute_Contrast | CNR_Linear | CNR_dB | Signal_Median | Background_Median | Source_File
Direct_Scene | Point Scanning | 16x16 | 16 | 6 | 12 | 30.62579974 | 0.53755929 | 0.38153760 | 30.08824045 | 78.86048550 | 37.93718893 | 28.16805911 | 0.57858232 | C:\Users\13658\Desktop\MECH 5720\Major\code\point_scan_results\20261023_212721_046887\point_scan_data.npz
Direct_Scene | Point Scanning | 32x32 | 32 | 28 | 54 | 8.42091326 | 0.05029968 | 0.26424456 | 8.37061358 | 31.67752440 | 30.01502468 | 8.16282285 | 0.02001840 | C:\Users\13658\Desktop\MECH 5720\Major\code\point_scan_results\20261023_183716_068313\point_scan_data.npz
Direct_Scene | Point Scanning | 64x64 | 64 | 105 | 215 | 1.99540289 | -0.00023016 | 0.18903027 | 1.99563305 | 10.55721434 | 20.47098678 | 1.89335068 | -0.00795765 | C:\Users\13658\Desktop\MECH 5720\Major\code\point_scan_results\20261023_232207_754080\point_scan_data.npz
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
