GuoJiashu/mech5720-2026-single_pixel_imaging/analyze/background_analysis_results_NLOS/background_summary.csv

Method | Resolution | Grid_Size | Black_Measurements | Duration_min | Mean_Black_ADC | Between_Window_Std_ADC | Min_Black_ADC | Max_Black_ADC | Drift_Range_ADC | Net_Drift_ADC | Mean_Within_Window_Std_ADC | Median_Within_Window_Std_ADC | Max_Within_Window_Std_ADC | Mean_Black_Interval_s | Std_Black_Interval_s | Source_File
Point Scanning | 16x16 | 16 | 17 | 8.377504 | 1.183529 | 0.250064 | 0.784000 | 1.768000 | 0.984000 | -0.704000 | 1.747394 | 1.751200 | 2.265200 | 31.415641 | 0.046153 | C:\Users\13658\Desktop\MECH 5720\Major\code\point_scan_results\20261024_215743_952485\black_anchors.csv
Point Scanning | 32x32 | 32 | 65 | 33.529268 | 1.035323 | 0.218792 | 0.632000 | 1.592000 | 0.960000 | -0.224000 | 1.617602 | 1.616400 | 2.159400 | 31.433688 | 0.038969 | C:\Users\13658\Desktop\MECH 5720\Major\code\point_scan_results\20261024_223747_962874\black_anchors.csv
Point Scanning | 64x64 | 64 | 257 | 134.247369 | 1.097837 | 0.153879 | 0.704000 | 1.576000 | 0.872000 | -0.320000 | 1.704387 | 1.682000 | 2.671200 | 31.464227 | 0.028677 | C:\Users\13658\Desktop\MECH 5720\Major\code\point_scan_results\20261025_020124_483501\black_anchors.csv
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
