GuoJiashu/mech5720-2026-single_pixel_imaging/fourier_results/20261024_222205_895619/fourier_frequencies.csv

freq_index | fy | fx | fourier_real | fourier_imag
0 | 1 | 12 | -5.951999999999998 | 7.832000000000022
1 | 3 | 5 | -0.07200000000000273 | 5.432000000000016
2 | 6 | 1 | 0.6559000000000026 | 9.0
3 | 8 | 6 | -0.4960000000000093 | -2.10390000000001
4 | 3 | 8 | -0.6479999999999961 | -2.5279999999999916
5 | 2 | 10 | 3.0719999999999743 | -0.9439999999999884
6 | 1 | 0 | -92.216 | 35.831999999999994
7 | 5 | 9 | -0.5199999999999818 | 0.7839999999999918
8 | 0 | 3 | -51.672000000000025 | 37.43199999999999
9 | 2 | 8 | 8.64009999999999 | 4.824000000000012
10 | 5 | 5 | -9.472000000000008 | -10.895999999999987
11 | 4 | 6 | -6.984100000000012 | -5.063999999999993
12 | 6 | 2 | 8.848000000000013 | 10.76000000000002
13 | 1 | 11 | 12.736000000000018 | -2.783999999999992
14 | 5 | 2 | -3.26400000000001 | -6.0
15 | 7 | 1 | -1.872000000000014 | 9.240000000000009
16 | 6 | 9 | -18.423900000000003 | -4.920000000000016
17 | 5 | 11 | 0.856000000000023 | 1.200000000000017
18 | 6 | 3 | 9.423900000000003 | -3.695999999999998
19 | 5 | 6 | 2.200000000000017 | 4.391999999999996
20 | 6 | 0 | -15.831999999999994 | -0.02400000000000091
21 | 4 | 8 | -0.695999999999998 | 4.680000000000007
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
