GuoJiashu/mech5720-2026-single_pixel_imaging/fourier_results/20261025_002849_105656/fourier_frequencies.csv

freq_index | fy | fx | fourier_real | fourier_imag
0 | 14 | 9 | -19.912000000000006 | -4.055999999999983
1 | 11 | 17 | -0.7280000000000086 | -1.2079999999999984
2 | 3 | 20 | -1.9440000000000168 | 1.5919000000000096
3 | 10 | 11 | 3.2560000000000002 | 5.352000000000004
4 | 5 | 12 | -1.5360000000000014 | 2.7360999999999933
5 | 9 | 22 | -1.5039999999999907 | -1.568000000000012
6 | 16 | 7 | -0.46410000000000196 | -0.5760000000000218
7 | 8 | 11 | 0.7760000000000105 | -0.3439999999999941
8 | 1 | 18 | -2.5999999999999943 | -1.775999999999982
9 | 3 | 11 | 2.656000000000006 | 1.6159999999999854
10 | 7 | 9 | 0.6399999999999864 | -0.02400000000000091
11 | 13 | 17 | -1.343999999999994 | 0.1519999999999868
12 | 3 | 0 | 7.415999999999997 | 25.591999999999985
13 | 9 | 15 | -3.783999999999992 | 0.04800000000000182
14 | 6 | 15 | -0.9759999999999991 | -0.04800000000000182
15 | 13 | 7 | -1.2641000000000133 | -1.3440000000000225
16 | 12 | 25 | -18.88810000000001 | -5.415999999999997
17 | 14 | 7 | -1.0 | -1.2639999999999816
18 | 1 | 29 | 13.864000000000004 | -26.599999999999994
19 | 12 | 20 | -1.0320000000000107 | -0.5520000000000209
20 | 6 | 24 | -1.728100000000012 | -0.3199999999999932
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
