GuoJiashu/mech5720-2026-single_pixel_imaging/point_scan_results/20261024_215743_952485/black_anchors.csv

time_s | measurement_id | mean_adc | std_adc | min_adc | max_adc | n_samples | capture_ms
9.21562350000022 | 0 | 1.768 | 2.2652 | 0 | 10 | 125 | 496
40.5897432999991 | 17 | 1.28 | 1.8648 | 0 | 7 | 125 | 496
72.00475419999566 | 34 | 1.176 | 1.7601 | 0 | 9 | 125 | 496
103.45670439999958 | 51 | 1.072 | 1.6567 | 0 | 7 | 125 | 496
134.8801145999969 | 68 | 1.088 | 1.8449 | 0 | 8 | 125 | 496
166.23005520000152 | 85 | 0.968 | 1.6845 | 0 | 9 | 125 | 496
197.7104232999991 | 102 | 1.568 | 1.9064 | 0 | 8 | 125 | 496
229.1908551000015 | 119 | 1.008 | 1.4892 | 0 | 7 | 125 | 496
260.5816427999962 | 136 | 0.784 | 1.2154 | 0 | 6 | 125 | 496
291.9640689000007 | 153 | 1.232 | 1.7512 | 0 | 8 | 125 | 496
323.3952533999982 | 170 | 1.16 | 1.6333 | 0 | 7 | 125 | 496
354.80609879999975 | 187 | 1.128 | 1.875 | 0 | 9 | 125 | 496
386.1441552999968 | 204 | 1.528 | 2.1424 | 0 | 12 | 125 | 496
417.6286977999989 | 221 | 1.056 | 1.5466 | 0 | 7 | 125 | 496
448.99885820000054 | 238 | 0.92 | 1.4897 | 0 | 6 | 125 | 496
480.45087039999635 | 255 | 1.32 | 1.9903 | 0 | 9 | 125 | 496
511.8658753999989 | 272 | 1.064 | 1.59 | 0 | 8 | 125 | 496
