GuoJiashu/mech5720-2026-single_pixel_imaging/point_scan_results/20261024_215743_952485/point_scan_corrected.csv

row | col | spot_adc | estimated_black_adc | delta_adc
0 | 0 | 1.248 | 1.7437225997715569 | -0.49572259977155686
0 | 1 | 1.328 | 1.7193817118783976 | -0.39138171187839754
0 | 2 | 1.48 | 1.6953018067076455 | -0.21530180670764554
0 | 3 | 1.208 | 1.6710826134857804 | -0.4630826134857804
0 | 4 | 1.248 | 1.646999137065804 | -0.3989991370658039
0 | 5 | 1.192 | 1.62266084050594 | -0.43066084050594
0 | 6 | 0.912 | 1.5985851520845287 | -0.6865851520845286
0 | 7 | 1.136 | 1.5745548073288043 | -0.43855480732880436
0 | 8 | 1.216 | 1.550407269293392 | -0.33440726929339193
0 | 9 | 1.232 | 1.5263207224700803 | -0.29432072247008034
0 | 10 | 1.168 | 1.5022408359644228 | -0.3342408359644229
0 | 11 | 1.232 | 1.478287409943516 | -0.24628740994351594
0 | 12 | 1.36 | 1.4542616583494359 | -0.09426165834943578
0 | 13 | 1.032 | 1.4301805352830554 | -0.3981805352830554
0 | 14 | 1.16 | 1.4061561649038121 | -0.2461561649038122
0 | 15 | 1.176 | 1.3818794972791084 | -0.20587949727910848
1 | 0 | 0.792 | 1.2748729275786967 | -0.4828729275786967
1 | 1 | 1.072 | 1.2697602108933288 | -0.19776021089332874
1 | 2 | 1.104 | 1.264635725973912 | -0.16063572597391196
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
