GuoJiashu/mech5720-2026-single_pixel_imaging/point_scan_results/20261025_020124_483501/point_scan_corrected.csv

row | col | spot_adc | estimated_black_adc | delta_adc
0 | 0 | 1.24 | 1.3198959916225281 | -0.07989599162252814
0 | 1 | 1.28 | 1.2877898456742012 | -0.007789845674201157
0 | 2 | 1.08 | 1.2556768241133702 | -0.17567682411337016
0 | 3 | 0.832 | 1.2234858480836586 | -0.3914858480836586
0 | 4 | 0.944 | 1.1913776612593445 | -0.24737766125934457
0 | 5 | 1.2 | 1.1592655984164457 | 0.040734401583554236
0 | 6 | 0.904 | 1.1271570248131084 | -0.2231570248131084
0 | 7 | 0.96 | 1.0951301808879677 | -0.1351301808879677
0 | 8 | 1.12 | 1.062945843877265 | 0.05705415612273512
0 | 9 | 1.304 | 1.030833818066373 | 0.2731661819336271
0 | 10 | 0.992 | 0.9988845809204474 | -0.006884580920447414
0 | 11 | 0.712 | 0.9668641517647731 | -0.2548641517647732
0 | 12 | 0.832 | 0.9348371617686551 | -0.1028371617686551
0 | 13 | 1.096 | 0.9029794369270314 | 0.19302056307296866
0 | 14 | 0.992 | 0.870873031754655 | 0.12112696824534497
0 | 15 | 0.712 | 0.8388459286051655 | -0.12684592860516553
0 | 16 | 1.088 | 0.7107513708883784 | 0.3772486291116217
0 | 17 | 1.088 | 0.7174707119146169 | 0.3705292880853832
0 | 18 | 1.12 | 0.7242074411985354 | 0.3957925588014647
0 | 19 | 1.032 | 0.7309262646578545 | 0.30107373534214554
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
