GuoJiashu/mech5720-2026-single_pixel_imaging/point_scan_results/20261025_020124_483501/spot_raw.csv

row | col | index | time_s | measurement_id | mean_adc | std_adc | min_adc | max_adc | n_samples | capture_ms
0 | 0 | 0 | 10.740856399999757 | 1 | 1.24 | 1.6675 | 0 | 9 | 125 | 496
0 | 1 | 1 | 12.301426300000458 | 2 | 1.28 | 1.8032 | 0 | 8 | 125 | 496
0 | 2 | 2 | 13.862330399999337 | 3 | 1.08 | 1.7255 | 0 | 9 | 125 | 496
0 | 3 | 3 | 15.427023600001121 | 4 | 0.832 | 1.1963 | 0 | 4 | 125 | 496
0 | 4 | 4 | 16.98769270000048 | 5 | 0.944 | 1.4045 | 0 | 5 | 125 | 496
0 | 5 | 5 | 18.548550200001046 | 6 | 1.2 | 1.8923 | 0 | 10 | 125 | 496
0 | 6 | 6 | 20.109238100005314 | 7 | 0.904 | 1.4942 | 0 | 6 | 125 | 496
0 | 7 | 7 | 21.665953399999125 | 8 | 0.96 | 1.5155 | 0 | 7 | 125 | 496
0 | 8 | 8 | 23.230323900002986 | 9 | 1.12 | 1.8254 | 0 | 7 | 125 | 496
0 | 9 | 9 | 24.791179600004398 | 10 | 1.304 | 1.8238 | 0 | 8 | 125 | 496
0 | 10 | 10 | 26.344122700000298 | 11 | 0.992 | 1.6039 | 0 | 7 | 125 | 496
0 | 11 | 11 | 27.90052619999915 | 12 | 0.712 | 1.3843 | 0 | 8 | 125 | 496
0 | 12 | 12 | 29.457248600003368 | 13 | 0.832 | 1.5066 | 0 | 7 | 125 | 496
0 | 13 | 13 | 31.0057436000061 | 14 | 1.096 | 1.6916 | 0 | 7 | 125 | 496
0 | 14 | 14 | 32.56632610000088 | 15 | 0.992 | 1.6728 | 0 | 8 | 125 | 496
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
