GuoJiashu/mech5720-2026-single_pixel_imaging/fourier_results/20261023_215608_700959/black_reference.csv

after_groups | time_s | mean_adc | std_adc
0 | 9.156917799999064 | 26.424 | 1.8848
16 | 114.8185794999954 | 25.968 | 2.1325
32 | 220.49754699999903 | 26.064 | 1.9458
48 | 326.14275749999797 | 25.768 | 1.8971
64 | 431.8217602000004 | 25.592 | 2.6277
80 | 537.4834560000018 | 26.008 | 2.0379
96 | 643.1988729000004 | 25.896 | 2.1396
112 | 748.8949457999988 | 25.728 | 2.384
128 | 854.6009584999993 | 25.912 | 1.8709
144 | 960.2915218999988 | 26.072 | 2.0248
160 | 1066.0196213000017 | 26.12 | 1.9535
176 | 1171.6373534000013 | 26.256 | 2.1019
192 | 1277.2540747999956 | 26.192 | 1.8867
208 | 1382.923390799995 | 26.024 | 1.7573
224 | 1488.5539680000002 | 26.104 | 2.0861
240 | 1594.2443268999996 | 25.896 | 1.8527
256 | 1699.9097389000017 | 26.08 | 1.9075
272 | 1805.6170366000006 | 26.44 | 1.8465
288 | 1911.2674359000011 | 26.016 | 1.7366
304 | 2017.0116443000006 | 26.216 | 1.974
320 | 2122.714092299997 | 26.144 | 2.0506
336 | 2228.3967454000012 | 26.128 | 2.0398
352 | 2334.1039298999967 | 26.032 | 2.1662
368 | 2439.7577317999967 | 26.328 | 1.9167
384 | 2545.411191399995 | 26.104 | 1.9
400 | 2651.073630699997 | 26.256 | 1.9956
416 | 2756.694410099997 | 26.096 | 2.0923
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
