GuoJiashu/mech5720-2026-single_pixel_imaging/fourier_results/20261024_052155_912611/fourier_raw.csv

freq_index | fy | fx | phase_deg | time_s | measurement_id | mean_adc | std_adc | min_adc | max_adc | n_samples | capture_ms
0 | 30 | 45 | 0 | 10.709997199999634 | 1 | 536.0482 | 11.3193 | 508 | 559 | 125 | 496
0 | 30 | 45 | 90 | 12.254169599997113 | 2 | 546.8319 | 11.3881 | 524 | 566 | 125 | 496
0 | 30 | 45 | 180 | 13.804006200000003 | 3 | 550.2561 | 10.6725 | 530 | 570 | 125 | 496
0 | 30 | 45 | 270 | 15.359025899997505 | 4 | 551.096 | 10.703 | 531 | 571 | 125 | 496
1 | 29 | 24 | 0 | 16.907200000001467 | 5 | 549.7921 | 10.7578 | 528 | 570 | 125 | 496
1 | 29 | 24 | 90 | 18.45570790000056 | 6 | 550.52 | 11.1287 | 528 | 570 | 125 | 496
1 | 29 | 24 | 180 | 20.004111099995498 | 7 | 551.0321 | 10.624 | 532 | 572 | 125 | 496
1 | 29 | 24 | 270 | 21.552584500001103 | 8 | 550.6641 | 10.6043 | 529 | 572 | 125 | 496
2 | 19 | 43 | 0 | 23.101716099998157 | 9 | 550.3439 | 10.6696 | 531 | 571 | 125 | 496
2 | 19 | 43 | 90 | 24.65337400000135 | 10 | 552.6478 | 10.331 | 533 | 574 | 125 | 496
2 | 19 | 43 | 180 | 26.19810399999551 | 11 | 551.5359 | 11.1229 | 530 | 571 | 125 | 496
2 | 19 | 43 | 270 | 27.746828199997253 | 12 | 549.3521 | 11.0119 | 526 | 569 | 125 | 496
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
