GuoJiashu/mech5720-2026-single_pixel_imaging/point_scan_results/20261023_183716_068313/spot_raw.csv

row | col | index | time_s | measurement_id | mean_adc | std_adc | min_adc | max_adc | n_samples | capture_ms
0 | 0 | 0 | 10.712244599999394 | 1 | 29.928 | 2.0367 | 23 | 37 | 125 | 496
0 | 1 | 1 | 12.260036499999842 | 2 | 29.84 | 2.2697 | 24 | 36 | 125 | 496
0 | 2 | 2 | 13.804697999999917 | 3 | 29.528 | 1.941 | 25 | 35 | 125 | 496
0 | 3 | 3 | 15.352744200001325 | 4 | 29.664 | 2.2999 | 24 | 38 | 125 | 496
0 | 4 | 4 | 16.901681300001655 | 5 | 29.136 | 2.1035 | 24 | 38 | 125 | 496
0 | 5 | 5 | 18.446199800000613 | 6 | 29.632 | 2.046 | 22 | 37 | 125 | 496
0 | 6 | 6 | 19.997912499999074 | 7 | 30.024 | 2.2341 | 23 | 36 | 125 | 496
0 | 7 | 7 | 21.54282560000138 | 8 | 29.864 | 2.1415 | 23 | 35 | 125 | 496
0 | 8 | 8 | 23.08232059999864 | 9 | 29.744 | 2.0237 | 23 | 35 | 125 | 496
0 | 9 | 9 | 24.628021700002137 | 10 | 30.08 | 2.0891 | 24 | 36 | 125 | 496
0 | 10 | 10 | 26.1711647000011 | 11 | 30.312 | 2.0416 | 25 | 36 | 125 | 496
0 | 11 | 11 | 27.715808400000242 | 12 | 30.272 | 2.2554 | 23 | 35 | 125 | 496
0 | 12 | 12 | 29.256403800001863 | 13 | 30.08 | 2.1425 | 24 | 36 | 125 | 496
0 | 13 | 13 | 30.808121800000663 | 14 | 29.832 | 2.2423 | 24 | 36 | 125 | 496
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
