GuoJiashu/mech5720-2026-single_pixel_imaging/point_scan_results/20261023_212721_046887/spot_raw.csv

row | col | index | time_s | measurement_id | mean_adc | std_adc | min_adc | max_adc | n_samples | capture_ms
0 | 0 | 0 | 10.698466599998937 | 1 | 26.472 | 1.9493 | 22 | 32 | 125 | 496
0 | 1 | 1 | 12.238978400000633 | 2 | 26.512 | 1.937 | 22 | 32 | 125 | 496
0 | 2 | 2 | 13.787007999999332 | 3 | 26.528 | 2.0501 | 21 | 32 | 125 | 496
0 | 3 | 3 | 15.334754600000451 | 4 | 26.104 | 2.0392 | 20 | 32 | 125 | 496
0 | 4 | 4 | 16.888084999998682 | 5 | 26.064 | 1.9417 | 22 | 31 | 125 | 496
0 | 5 | 5 | 18.43604509999932 | 6 | 26.032 | 2.0943 | 20 | 30 | 125 | 496
0 | 6 | 6 | 19.98051000000123 | 7 | 26.28 | 1.974 | 21 | 31 | 125 | 496
0 | 7 | 7 | 21.528748199998518 | 8 | 26.224 | 1.9297 | 21 | 32 | 125 | 496
0 | 8 | 8 | 23.073436499998934 | 9 | 26.104 | 2.1658 | 22 | 31 | 125 | 496
0 | 9 | 9 | 24.617712800001755 | 10 | 26.176 | 1.8668 | 21 | 32 | 125 | 496
0 | 10 | 10 | 26.169621900000493 | 11 | 26.184 | 1.7057 | 21 | 30 | 125 | 496
0 | 11 | 11 | 27.722204599998804 | 12 | 26.152 | 1.8581 | 22 | 31 | 125 | 496
0 | 12 | 12 | 29.266846200000145 | 13 | 26.44 | 2.0651 | 19 | 32 | 125 | 496
0 | 13 | 13 | 30.81019599999854 | 14 | 26.176 | 1.7828 | 23 | 31 | 125 | 496
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
