GuoJiashu/mech5720-2026-single_pixel_imaging/analyze/background_analysis_results/Direct_Scene/background_summary.csv

Scene_Type | Method | Resolution | Grid_Size | Black_Measurements | Duration_min | Mean_Black_ADC | Median_Black_ADC | Between_Window_Std_ADC | First_Black_ADC | Last_Black_ADC | Min_Black_ADC | Max_Black_ADC | Drift_Range_ADC | Net_Drift_ADC | Mean_Within_Window_Std_ADC | Median_Within_Window_Std_ADC | Max_Within_Window_Std_ADC | Mean_Black_Interval_s | Std_Black_Interval_s | Source_File
Direct_Scene | Point Scanning | 16x16 | 16 | 17 | 8.354458 | 26.098824 | 26.368000 | 0.472635 | 26.472000 | 26.552000 | 25.088000 | 26.552000 | 1.464000 | 0.080000 | 2.053394 | 2.080400 | 2.325400 | 31.329217 | 0.016616 | C:\Users\13658\Desktop\MECH 5720\Major\code\point_scan_results\20261023_212721_046887\black_anchors.csv
Direct_Scene | Point Scanning | 32x32 | 32 | 65 | 33.394391 | 29.202462 | 29.160000 | 0.406288 | 30.368000 | 28.224000 | 28.224000 | 30.368000 | 2.144000 | -2.144000 | 2.108208 | 2.102600 | 2.728800 | 31.307241 | 0.017838 | C:\Users\13658\Desktop\MECH 5720\Major\code\point_scan_results\20261023_183716_068313\black_anchors.csv
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
