GuoJiashu/mech5720-2026-single_pixel_imaging/hadamard_results/20261024_220710_549725/admm_results_128_256_sequency/admm_convergence.csv

iteration | objective | primal | dual | data_fidelity
1.000000000000000000e+00 | 1.112300783820153516e+00 | 7.571186228560874976e-02 | 2.927543352822334355e-01 | 9.170122989020455806e-02
2.000000000000000000e+00 | 1.102935484373791741e+00 | 6.565794848889056068e-02 | 2.468170168068046233e-01 | 8.514206423038134242e-02
3.000000000000000000e+00 | 1.096831010466064793e+00 | 5.099292335897673278e-02 | 2.662276473006977007e-01 | 8.005795793986247855e-02
4.000000000000000000e+00 | 1.091440341815701265e+00 | 2.795321113313139691e-02 | 2.891027452504114637e-01 | 7.564977218082390154e-02
5.000000000000000000e+00 | 1.086220270306430091e+00 | 9.493949469846701267e-03 | 2.919968975902774155e-01 | 7.139511519172372922e-02
6.000000000000000000e+00 | 1.080773990677038388e+00 | 1.220096608869444474e-02 | 2.790415178660897721e-01 | 6.695507202219197485e-02
7.000000000000000000e+00 | 1.075167558469439788e+00 | 1.867951697955473264e-02 | 2.593095316887558677e-01 | 6.237889252948476682e-02
8.000000000000000000e+00 | 1.069641731825554665e+00 | 2.041947864830395698e-02 | 2.395369113982144804e-01 | 5.786962101033520101e-02
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
