GuoJiashu/mech5720-2026-single_pixel_imaging/hadamard_results/20261024_220710_549725/admm_results_192_256_sequency/admm_convergence.csv

iteration | objective | primal | dual | data_fidelity
1.000000000000000000e+00 | 1.016054220595769664e+00 | 4.503838993129382490e-02 | 1.475584524440284317e-01 | 9.715925339634425006e-03
2.000000000000000000e+00 | 1.012906134660803259e+00 | 1.942367285733604537e-02 | 1.245534791785677386e-01 | 9.560888275268701955e-03
3.000000000000000000e+00 | 1.011532768966077800e+00 | 1.428106850693684239e-02 | 1.220158845868052622e-01 | 9.437568867532998909e-03
4.000000000000000000e+00 | 1.010354473218172178e+00 | 7.308040765299997008e-03 | 1.211140174368221106e-01 | 9.367879184153870067e-03
5.000000000000000000e+00 | 1.009277458093496893e+00 | 2.716486195912326887e-03 | 1.179382518885960934e-01 | 9.309266659967419325e-03
6.000000000000000000e+00 | 1.008267530655392763e+00 | 3.746213778376763625e-03 | 1.129756969368379133e-01 | 9.236703442170954986e-03
7.000000000000000000e+00 | 1.007314491229545084e+00 | 4.936484009656212993e-03 | 1.074803989595246173e-01 | 9.152288340603973588e-03
8.000000000000000000e+00 | 1.006421132290439502e+00 | 5.009553022210778278e-03 | 1.022877513673152577e-01 | 9.067473142605102579e-03
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
