GuoJiashu/mech5720-2026-single_pixel_imaging/hadamard_results/20261024_220710_549725/admm_results_256_256_sequency/admm_convergence.csv

iteration | objective | primal | dual | data_fidelity
1.000000000000000000e+00 | 1.018321080806217971e+00 | 4.376546754935997652e-02 | 1.369979393702964454e-01 | 8.201973513887338488e-03
2.000000000000000000e+00 | 1.015677496269047131e+00 | 1.777931093773097923e-02 | 1.046634799660046966e-01 | 8.541879809471363688e-03
3.000000000000000000e+00 | 1.014816461322718188e+00 | 1.472959354280270645e-02 | 9.427373171336764224e-02 | 8.814386318289874067e-03
4.000000000000000000e+00 | 1.014117846448591820e+00 | 9.447374922693740559e-03 | 8.831664578155067058e-02 | 9.123348719242330498e-03
5.000000000000000000e+00 | 1.013548168515256531e+00 | 4.645634440559464826e-03 | 8.227228623313297129e-02 | 9.459246819009382162e-03
6.000000000000000000e+00 | 1.013076908132026555e+00 | 1.957024629071126270e-03 | 7.541222911947347007e-02 | 9.807766236152842820e-03
7.000000000000000000e+00 | 1.012682341696997890e+00 | 2.252097515351334303e-03 | 6.845889877814140267e-02 | 1.015757669320187413e-02
8.000000000000000000e+00 | 1.012350398187308764e+00 | 2.792895920004734821e-03 | 6.213836148005601884e-02 | 1.050177760734124534e-02
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
