GuoJiashu/mech5720-2026-single_pixel_imaging/hadamard_results/20261024_220710_549725/admm_results_64_256_sequency/admm_convergence.csv

iteration | objective | primal | dual | data_fidelity
1.000000000000000000e+00 | 1.067678189603714412e+00 | 8.626746080853617271e-02 | 3.169372195333048370e-01 | 1.081176090227241871e-01
2.000000000000000000e+00 | 1.051975379713174119e+00 | 7.821904390603397206e-02 | 2.805866104231291014e-01 | 9.469840534157918099e-02
3.000000000000000000e+00 | 1.041707247522863478e+00 | 5.392290642530610939e-02 | 3.201389701640803276e-01 | 8.488889731674210959e-02
4.000000000000000000e+00 | 1.033226252946800372e+00 | 2.139627630966062580e-02 | 3.416256317384734897e-01 | 7.678902568870708822e-02
5.000000000000000000e+00 | 1.024835376370701212e+00 | 1.013391424067703640e-02 | 3.299632248679823521e-01 | 6.876228045604244887e-02
6.000000000000000000e+00 | 1.016236638381600388e+00 | 2.446795143906343312e-02 | 2.991252041410557561e-01 | 6.052131609341135365e-02
7.000000000000000000e+00 | 1.007847231438009805e+00 | 2.956169409449178540e-02 | 2.639162431726695957e-01 | 5.249337576125274324e-02
8.000000000000000000e+00 | 1.000223583287550566e+00 | 2.758888583763387942e-02 | 2.324007728090277669e-01 | 4.519019446824477926e-02
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
