GuoJiashu/mech5720-2026-single_pixel_imaging/hadamard_results/20261024_232029_873143/admm_results_1024_1024_sequency/admm_convergence.csv

iteration | objective | primal | dual | data_fidelity
1.000000000000000000e+00 | 9.628527673395786968e-01 | 1.095029959989640561e-01 | 3.351008465211570142e-01 | 1.249437514988870346e-01
2.000000000000000000e+00 | 9.529307836913631924e-01 | 7.381389802370204312e-02 | 2.287001609081840414e-01 | 1.263968513089465395e-01
3.000000000000000000e+00 | 9.495389165603749237e-01 | 5.840204390177755611e-02 | 2.059571088154702190e-01 | 1.271014996208981729e-01
4.000000000000000000e+00 | 9.468517711828047245e-01 | 3.613366682643663619e-02 | 2.038995953741111478e-01 | 1.279903491045739639e-01
5.000000000000000000e+00 | 9.446332661740459713e-01 | 1.795709275793533344e-02 | 1.949515892385422777e-01 | 1.291773007232461801e-01
6.000000000000000000e+00 | 9.427100912683697986e-01 | 9.420116636470379085e-03 | 1.775444071384829348e-01 | 1.305472273945851303e-01
7.000000000000000000e+00 | 9.409868631603323097e-01 | 9.686604044681966161e-03 | 1.570579363356937319e-01 | 1.319995525924990976e-01
8.000000000000000000e+00 | 9.394761836238416652e-01 | 1.070044975519026872e-02 | 1.377825433599620675e-01 | 1.334765078887377721e-01
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
