GuoJiashu/mech5720-2026-single_pixel_imaging/hadamard_results/20261024_232029_873143/admm_results_256_1024_sequency/admm_convergence.csv

iteration | objective | primal | dual | data_fidelity
1.000000000000000000e+00 | 7.278900178332450288e-01 | 8.637666152455303337e-02 | 2.445252595307933763e-01 | 1.915559349674021000e-02
2.000000000000000000e+00 | 7.163466846999576587e-01 | 2.371579339530535679e-02 | 2.178826785470667771e-01 | 1.927727474869016938e-02
3.000000000000000000e+00 | 7.109076891695450540e-01 | 1.603039684956331784e-02 | 2.143589453394109112e-01 | 1.876679949526993685e-02
4.000000000000000000e+00 | 7.061805916499847013e-01 | 7.948986078773047012e-03 | 2.098553040422191651e-01 | 1.842995590594893179e-02
5.000000000000000000e+00 | 7.018051090756042276e-01 | 6.497223479494260157e-03 | 2.020295879898653668e-01 | 1.814654642507891602e-02
6.000000000000000000e+00 | 6.976704322294954297e-01 | 8.054568354827613269e-03 | 1.934482992544251656e-01 | 1.788118287115851579e-02
7.000000000000000000e+00 | 6.937476115606774352e-01 | 8.872912885356127113e-03 | 1.854369076148910112e-01 | 1.761578935223508113e-02
8.000000000000000000e+00 | 6.900418056886122864e-01 | 8.318347221280142020e-03 | 1.786274500382750430e-01 | 1.737592300611805196e-02
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
