GuoJiashu/mech5720-2026-single_pixel_imaging/hadamard_results/20261024_232029_873143/admm_results_512_1024_sequency/admm_convergence.csv

iteration | objective | primal | dual | data_fidelity
1.000000000000000000e+00 | 7.766919570863823896e-01 | 9.050492370702500899e-02 | 2.624970988309827113e-01 | 3.309929293612393075e-02
2.000000000000000000e+00 | 7.656608127416326681e-01 | 2.984925010724330877e-02 | 2.274384499501267698e-01 | 3.343989477933511506e-02
3.000000000000000000e+00 | 7.607997005684292713e-01 | 2.104027364275825110e-02 | 2.198724012669160399e-01 | 3.309884728901579809e-02
4.000000000000000000e+00 | 7.565797409299739318e-01 | 1.136479890208399492e-02 | 2.143792756180629144e-01 | 3.299478615748988042e-02
5.000000000000000000e+00 | 7.527843253773478516e-01 | 6.022899930748409729e-03 | 2.064504307158031293e-01 | 3.297602550620564593e-02
6.000000000000000000e+00 | 7.492785327285378383e-01 | 6.671043074442460641e-03 | 1.963854634732589421e-01 | 3.298176810998450920e-02
7.000000000000000000e+00 | 7.460494664796435416e-01 | 8.480273041153724503e-03 | 1.856446073555300669e-01 | 3.300002195386709386e-02
8.000000000000000000e+00 | 7.430738690419866899e-01 | 8.766054135321608640e-03 | 1.761165912290241498e-01 | 3.302252100430680404e-02
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
