GuoJiashu/mech5720-2026-single_pixel_imaging/hadamard_results/20261024_232029_873143/admm_results_768_1024_sequency/admm_convergence.csv

iteration | objective | primal | dual | data_fidelity
1.000000000000000000e+00 | 8.276254706420769214e-01 | 9.560921552019581438e-02 | 2.776472298110881365e-01 | 5.667590293126634204e-02
2.000000000000000000e+00 | 8.172706132455631600e-01 | 4.350272322020042742e-02 | 2.198756433494153673e-01 | 5.751494339331401223e-02
3.000000000000000000e+00 | 8.133328729021050973e-01 | 3.268022615380142271e-02 | 2.069263218070696853e-01 | 5.781155488436860029e-02
4.000000000000000000e+00 | 8.101082743335703551e-01 | 1.956485145884758262e-02 | 2.009379629266893896e-01 | 5.829683807378182453e-02
5.000000000000000000e+00 | 8.073145224049743662e-01 | 9.746175367524782460e-03 | 1.926477851673129016e-01 | 5.891531983143550449e-02
6.000000000000000000e+00 | 8.048219181953657486e-01 | 5.772915529342547217e-03 | 1.811663486679279400e-01 | 5.959122180147590625e-02
7.000000000000000000e+00 | 8.025713772029516857e-01 | 6.902880997829059090e-03 | 1.684769487278728051e-01 | 6.028093511686989647e-02
8.000000000000000000e+00 | 8.005459672041568275e-01 | 8.004572780236050844e-03 | 1.566031515769628069e-01 | 6.094950084815171226e-02
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
