GuoJiashu/mech5720-2026-single_pixel_imaging/hadamard_results/20261025_041555_865482/admm_results_1024_4096_sequency/admm_convergence.csv

iteration | objective | primal | dual | data_fidelity
1.000000000000000000e+00 | 6.950759379369766400e-01 | 2.167544814761287741e-01 | 4.089311652570049027e-01 | 1.952259438688074000e-01
2.000000000000000000e+00 | 6.677039711654721987e-01 | 7.339582671158825788e-02 | 3.302301630368789653e-01 | 2.004881814355372049e-01
3.000000000000000000e+00 | 6.581823102333484998e-01 | 4.109882629005703891e-02 | 3.015429911751448810e-01 | 2.028375925787042899e-01
4.000000000000000000e+00 | 6.504560901227439684e-01 | 2.274322983344980592e-02 | 2.746973116488952149e-01 | 2.052620464788483812e-01
5.000000000000000000e+00 | 6.439788415605738336e-01 | 1.675778804872075922e-02 | 2.477607011586918651e-01 | 2.076883021079679592e-01
6.000000000000000000e+00 | 6.385472093679331884e-01 | 1.563863396246550908e-02 | 2.233531883507903770e-01 | 2.099688386879700608e-01
7.000000000000000000e+00 | 6.340056398510680591e-01 | 1.353492252755062082e-02 | 2.041199360975907151e-01 | 2.120241963854376799e-01
8.000000000000000000e+00 | 6.301912551868398271e-01 | 1.121935557540478315e-02 | 1.888582423730258142e-01 | 2.138226926292804975e-01
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
