GuoJiashu/mech5720-2026-single_pixel_imaging/hadamard_results/20261025_041555_865482/admm_results_2048_4096_sequency/admm_convergence.csv

iteration | objective | primal | dual | data_fidelity
1.000000000000000000e+00 | 9.590565427501196449e-01 | 2.376403832636680702e-01 | 4.578812987366149834e-01 | 3.144860947978386778e-01
2.000000000000000000e+00 | 9.317649245099818289e-01 | 9.506041420552212295e-02 | 3.670460140462751264e-01 | 3.201188371275596189e-01
3.000000000000000000e+00 | 9.220985795138383345e-01 | 5.524902533649739267e-02 | 3.406246269312813157e-01 | 3.227100141337426731e-01
4.000000000000000000e+00 | 9.138866443256966621e-01 | 3.013011095976522377e-02 | 3.141046282020089064e-01 | 3.257517875367599292e-01
5.000000000000000000e+00 | 9.065977424182370958e-01 | 1.859472318680881198e-02 | 2.850198404943646291e-01 | 3.292290943078244325e-01
6.000000000000000000e+00 | 9.003243389093575910e-01 | 1.469124908754156425e-02 | 2.562597489632777448e-01 | 3.328457300554332754e-01
7.000000000000000000e+00 | 8.950923724531762993e-01 | 1.328266013844338345e-02 | 2.305481479461647387e-01 | 3.363823836564024949e-01
8.000000000000000000e+00 | 8.908026293200080881e-01 | 1.204869736244469115e-02 | 2.081975103301002550e-01 | 3.397330991207780926e-01
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
