GuoJiashu/mech5720-2026-single_pixel_imaging/hadamard_results/20261025_041555_865482/admm_results_3072_4096_sequency/admm_convergence.csv

iteration | objective | primal | dual | data_fidelity
1.000000000000000000e+00 | 1.200469447913755650e+00 | 2.530958418947913957e-01 | 5.093796921578138681e-01 | 4.368065003930227674e-01
2.000000000000000000e+00 | 1.171813911765891891e+00 | 1.147615071127682657e-01 | 3.938069582623627829e-01 | 4.423497790516300876e-01
3.000000000000000000e+00 | 1.162240462961626974e+00 | 7.145501727767292199e-02 | 3.630633621732745620e-01 | 4.450884472640091460e-01
4.000000000000000000e+00 | 1.153937816722313991e+00 | 4.183192877043150071e-02 | 3.397204001434567244e-01 | 4.487033266671369147e-01
5.000000000000000000e+00 | 1.146395952280995889e+00 | 2.520742681441819066e-02 | 3.131714038380774001e-01 | 4.532153325461368842e-01
6.000000000000000000e+00 | 1.139856094665908648e+00 | 1.672172215609476695e-02 | 2.827058058355571557e-01 | 4.581002828343546662e-01
7.000000000000000000e+00 | 1.134354412116076016e+00 | 1.406428880631097056e-02 | 2.506507790478772479e-01 | 4.630310285769246859e-01
8.000000000000000000e+00 | 1.129820130161681258e+00 | 1.313812527124824485e-02 | 2.210947919267882145e-01 | 4.678428533446301052e-01
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
