GuoJiashu/mech5720-2026-single_pixel_imaging/hadamard_results/20261025_041555_865482/admm_results_4096_4096_sequency/admm_convergence.csv

iteration | objective | primal | dual | data_fidelity
1.000000000000000000e+00 | 1.485993711297640685e+00 | 2.683354537097504267e-01 | 6.086758307677462287e-01 | 5.982143078652204515e-01
2.000000000000000000e+00 | 1.454678601964270790e+00 | 1.405355378285034484e-01 | 4.556876713078546470e-01 | 6.028416851365561158e-01
3.000000000000000000e+00 | 1.444560629540780461e+00 | 9.511248025206221757e-02 | 4.133006750019372899e-01 | 6.053499170104534866e-01
4.000000000000000000e+00 | 1.435543625984187166e+00 | 6.066646963756217037e-02 | 3.936808017536507776e-01 | 6.089961189790253915e-01
5.000000000000000000e+00 | 1.426856015661789989e+00 | 3.677010277148320266e-02 | 3.725129581582305449e-01 | 6.140403061910555405e-01
6.000000000000000000e+00 | 1.419113982490959547e+00 | 2.201935860965162362e-02 | 3.420446695590643182e-01 | 6.197421136772257588e-01
7.000000000000000000e+00 | 1.412405670915084066e+00 | 1.591580325341699839e-02 | 3.046829852397567873e-01 | 6.257303855495432998e-01
8.000000000000000000e+00 | 1.406752180847806732e+00 | 1.615436379621908169e-02 | 2.646641330658225932e-01 | 6.317652719003001849e-01
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
