GuoJiashu/mech5720-2026-single_pixel_imaging/point_scan_results/20261024_215743_952485/admm_results/admm_convergence.csv

iteration | objective | primal | dual
1.000000000000000000e+00 | 2.048159017440849539e+01 | 9.363187937070600597e-01 | 2.292959772228223780e+00
2.000000000000000000e+00 | 1.975047396772405151e+01 | 1.999702281017078365e-01 | 1.763534675829275811e+00
3.000000000000000000e+00 | 1.948870440790520675e+01 | 1.173602624799313932e-01 | 1.574712757716111966e+00
4.000000000000000000e+00 | 1.930414173704439307e+01 | 7.083858004287522936e-02 | 1.405117796727886281e+00
5.000000000000000000e+00 | 1.915848097347472390e+01 | 4.616134323830772129e-02 | 1.251496023405438862e+00
6.000000000000000000e+00 | 1.904910210659782166e+01 | 4.105159897310536876e-02 | 1.100792242534053056e+00
7.000000000000000000e+00 | 1.896519928577342284e+01 | 4.635686590186172129e-02 | 9.631001173577992125e-01
8.000000000000000000e+00 | 1.890279865973772289e+01 | 4.354501153634194460e-02 | 8.455670058654567445e-01
9.000000000000000000e+00 | 1.885177011971412853e+01 | 3.831769127558898314e-02 | 7.468935038018065242e-01
1.000000000000000000e+01 | 1.881070352250643651e+01 | 3.098858299174297309e-02 | 6.648768896465712119e-01
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
