GuoJiashu/mech5720-2026-single_pixel_imaging/point_scan_results/20261024_223747_962874/admm_results/admm_convergence.csv

iteration | objective | primal | dual
1.000000000000000000e+00 | 1.688089083265742119e+01 | 9.348551677868806031e-01 | 2.005333833365495533e+00
2.000000000000000000e+00 | 1.677993127922544048e+01 | 6.770419755089510661e-01 | 1.139204910393226688e+00
3.000000000000000000e+00 | 1.675793227425964105e+01 | 4.619539415990864262e-01 | 8.983152833506979906e-01
4.000000000000000000e+00 | 1.673708240001921865e+01 | 2.937514341214849667e-01 | 9.304515185315647141e-01
5.000000000000000000e+00 | 1.670898411931669258e+01 | 1.749651047134513915e-01 | 9.680448987061016641e-01
6.000000000000000000e+00 | 1.668066366210134888e+01 | 9.728403369241868381e-02 | 9.248221854892195726e-01
7.000000000000000000e+00 | 1.665206687347597025e+01 | 6.557867873832112782e-02 | 8.131685073643201145e-01
8.000000000000000000e+00 | 1.662611726546640512e+01 | 7.011138652640647173e-02 | 6.540430733028061994e-01
9.000000000000000000e+00 | 1.660485131858520447e+01 | 7.289834643224217536e-02 | 5.149625363012004797e-01
1.000000000000000000e+01 | 1.658791263441837316e+01 | 6.254378927822938639e-02 | 4.295892121499643723e-01
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
