GuoJiashu/mech5720-2026-single_pixel_imaging/point_scan_results/20261025_020124_483501/admm_results/admm_convergence.csv

iteration | objective | primal | dual
1.000000000000000000e+00 | 4.188657232165608946e+01 | 1.621307798725932781e+00 | 3.129947981272350521e+00
2.000000000000000000e+00 | 4.155961459412686310e+01 | 1.044227772741272542e+00 | 1.962648736406359395e+00
3.000000000000000000e+00 | 4.149793004109560002e+01 | 6.958227709817946804e-01 | 1.687752019127308101e+00
4.000000000000000000e+00 | 4.142027646053868750e+01 | 4.359294481448318659e-01 | 1.706967687859874738e+00
5.000000000000000000e+00 | 4.131508486658857748e+01 | 2.628904880075703665e-01 | 1.704925396142197291e+00
6.000000000000000000e+00 | 4.120501928985207485e+01 | 1.506366624187334136e-01 | 1.596517994123813677e+00
7.000000000000000000e+00 | 4.110101139767193956e+01 | 1.058176409978264371e-01 | 1.397515569998111662e+00
8.000000000000000000e+00 | 4.100871293340459545e+01 | 1.116183185846884862e-01 | 1.146365548546092406e+00
9.000000000000000000e+00 | 4.093309596973034559e+01 | 1.075682958108655496e-01 | 9.366772622461962960e-01
1.000000000000000000e+01 | 4.087344305027259850e+01 | 8.693198053434486594e-02 | 8.053558722762047539e-01
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
