GuoJiashu/mech5720-2026-single_pixel_imaging/fourier_results/20261024_222205_895619/reconstruction_corrected/fourier_admm_results/admm_convergence.csv

iteration | objective | primal | dual | data_fidelity
1.000000000000000000e+00 | 2.872146941809769594e+00 | 7.978588104449310658e-02 | 2.648659235806628542e-01 | 3.260892799237555542e-29
2.000000000000000000e+00 | 2.860587207146704891e+00 | 2.274615392038407177e-03 | 2.154745044182711511e-01 | 1.453443693821128598e-03
3.000000000000000000e+00 | 2.856835379089044835e+00 | 3.208628101945493107e-03 | 1.962482354313407618e-01 | 2.705482085200700167e-03
4.000000000000000000e+00 | 2.853779533963845427e+00 | 2.560788629314873256e-03 | 1.794452640447140312e-01 | 4.126568230951145957e-03
5.000000000000000000e+00 | 2.851278100909044433e+00 | 1.052465881576179069e-03 | 1.645781732581709234e-01 | 5.635206031717686880e-03
6.000000000000000000e+00 | 2.849219470430679024e+00 | 2.582712437000630264e-04 | 1.512528481212921661e-01 | 7.174531620730492665e-03
7.000000000000000000e+00 | 2.847514973455703036e+00 | 2.435916544162190019e-04 | 1.392347485329514800e-01 | 8.705194789755253681e-03
8.000000000000000000e+00 | 2.846095841094849366e+00 | 2.268288391758821487e-04 | 1.283534165448807496e-01 | 1.020225793940696818e-02
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
