GuoJiashu/mech5720-2026-single_pixel_imaging/fourier_results/20261025_002849_105656/reconstruction_corrected/fourier_admm_results/admm_convergence.csv

iteration | objective | primal | dual | data_fidelity
1.000000000000000000e+00 | 3.425453134359942364e+00 | 1.599218559171947940e-01 | 6.002159416315514529e-01 | 2.451179050055784942e-29
2.000000000000000000e+00 | 3.369269276554160530e+00 | 1.901833667982537465e-03 | 4.962585846228652064e-01 | 5.929844379706538868e-03
3.000000000000000000e+00 | 3.349854653478826272e+00 | 2.651513921025263308e-03 | 4.544132913385705574e-01 | 1.145892252371841225e-02
4.000000000000000000e+00 | 3.333780548579884595e+00 | 3.174462439029592051e-03 | 4.164302396433360864e-01 | 1.797473777232089925e-02
5.000000000000000000e+00 | 3.320414289030700239e+00 | 3.057529079193955449e-03 | 3.820686753036460215e-01 | 2.509388656246596544e-02
6.000000000000000000e+00 | 3.309265699423789453e+00 | 2.175525268648108301e-03 | 3.509082784756699658e-01 | 3.254405138022434252e-02
7.000000000000000000e+00 | 3.299957387056506430e+00 | 1.386567912405416419e-03 | 3.225213835932492223e-01 | 4.012752467303721399e-02
8.000000000000000000e+00 | 3.292171589835603207e+00 | 1.197614246754287199e-03 | 2.966070415605005506e-01 | 4.769670551139008896e-02
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
