GuoJiashu/mech5720-2026-single_pixel_imaging/fourier_results/20261025_080248_743060/reconstruction_corrected/fourier_admm_results/admm_convergence.csv

iteration | objective | primal | dual | data_fidelity
1.000000000000000000e+00 | 4.299714613892906989e+00 | 3.198190770491849411e-01 | 1.286973367960541959e+00 | 3.132368024663616581e-30
2.000000000000000000e+00 | 4.060164068384198188e+00 | 9.951642710090767563e-03 | 1.076498315814264473e+00 | 2.287546850130419210e-02
3.000000000000000000e+00 | 3.975542223090403837e+00 | 9.019428321416637570e-03 | 9.889928763196603745e-01 | 4.480074197265701552e-02
4.000000000000000000e+00 | 3.904754082044728403e+00 | 9.583363062683035102e-03 | 9.088104314382720039e-01 | 7.097512582374702894e-02
5.000000000000000000e+00 | 3.845482675571906039e+00 | 9.385613673263125054e-03 | 8.354405889277647379e-01 | 9.988805708920162063e-02
6.000000000000000000e+00 | 3.795752655426283262e+00 | 8.062908104937580034e-03 | 7.684883978440886221e-01 | 1.304136888365292068e-01
7.000000000000000000e+00 | 3.754004156568234940e+00 | 6.658156318856630479e-03 | 7.071387303186581486e-01 | 1.617083959838748197e-01
8.000000000000000000e+00 | 3.718998867940058517e+00 | 6.352378471109832239e-03 | 6.506908156675261790e-01 | 1.931351976508100532e-01
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
