GuoJiashu/mech5720-2026-single_pixel_imaging/analyze/background_analysis_results_basic/background_summary.csv

Method | Resolution | Grid_Size | Black_Measurements | Duration_min | Mean_Black_ADC | Between_Window_Std_ADC | Min_Black_ADC | Max_Black_ADC | Drift_Range_ADC | Net_Drift_ADC | Mean_Within_Window_Std_ADC | Median_Within_Window_Std_ADC | Max_Within_Window_Std_ADC | Mean_Black_Interval_s | Std_Black_Interval_s | Source_File
Point Scanning | 16x16 | 16 | 65 | 33.394391 | 29.202462 | 0.406288 | 28.224000 | 30.368000 | 2.144000 | -2.144000 | 2.108208 | 2.102600 | 2.728800 | 31.307241 | 0.017838 | C:\Users\13658\Desktop\MECH 5720\Major\code\point_scan_results\20261023_183716_068313\black_anchors.csv
Point Scanning | 32x32 | 32 | 65 | 33.394391 | 29.202462 | 0.406288 | 28.224000 | 30.368000 | 2.144000 | -2.144000 | 2.108208 | 2.102600 | 2.728800 | 31.307241 | 0.017838 | C:\Users\13658\Desktop\MECH 5720\Major\code\point_scan_results\20261023_183716_068313\black_anchors.csv
Point Scanning | 64x64 | 64 | 257 | 133.713914 | 27.396856 | 0.556997 | 25.528000 | 28.416000 | 2.888000 | 1.728000 | 2.031572 | 2.015500 | 2.542700 | 31.339199 | 0.022137 | C:\Users\13658\Desktop\MECH 5720\Major\code\point_scan_results\20261023_232207_754080\black_anchors.csv
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
