GuoJiashu/mech5720-2026-single_pixel_imaging/fourier_results/20261025_002849_105656/fourier_raw.csv

freq_index | fy | fx | phase_deg | time_s | measurement_id | mean_adc | std_adc | min_adc | max_adc | n_samples | capture_ms
0 | 14 | 9 | 0 | 10.7133857000008 | 1 | 137.064 | 4.6848 | 126 | 150 | 125 | 496
0 | 14 | 9 | 90 | 12.26686989999871 | 2 | 154.072 | 4.3703 | 142 | 164 | 125 | 496
0 | 14 | 9 | 180 | 13.818650200002594 | 3 | 156.976 | 3.6621 | 149 | 164 | 125 | 496
0 | 14 | 9 | 270 | 15.375396600000386 | 4 | 158.128 | 3.7265 | 148 | 166 | 125 | 496
1 | 11 | 17 | 0 | 16.931712600002356 | 5 | 159.344 | 3.9022 | 149 | 168 | 125 | 496
1 | 11 | 17 | 90 | 18.489355500001693 | 6 | 159.112 | 3.6283 | 150 | 168 | 125 | 496
1 | 11 | 17 | 180 | 20.03283460000239 | 7 | 160.072 | 3.9333 | 150 | 168 | 125 | 496
1 | 11 | 17 | 270 | 21.59034800000518 | 8 | 160.32 | 4.1593 | 150 | 169 | 125 | 496
2 | 3 | 20 | 0 | 23.150180100004945 | 9 | 159.672 | 3.5282 | 151 | 167 | 125 | 496
2 | 3 | 20 | 90 | 24.714596800004074 | 10 | 161.2799 | 4.0193 | 151 | 170 | 125 | 496
2 | 3 | 20 | 180 | 26.271546500000113 | 11 | 161.616 | 3.5736 | 154 | 171 | 125 | 496
2 | 3 | 20 | 270 | 27.832031800004188 | 12 | 159.688 | 3.9725 | 150 | 168 | 125 | 496
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
