GuoJiashu/mech5720-2026-single_pixel_imaging/3d_cali/results/hadamard_capture/plots/04_plot_spi_capture_8x8/time_series.png

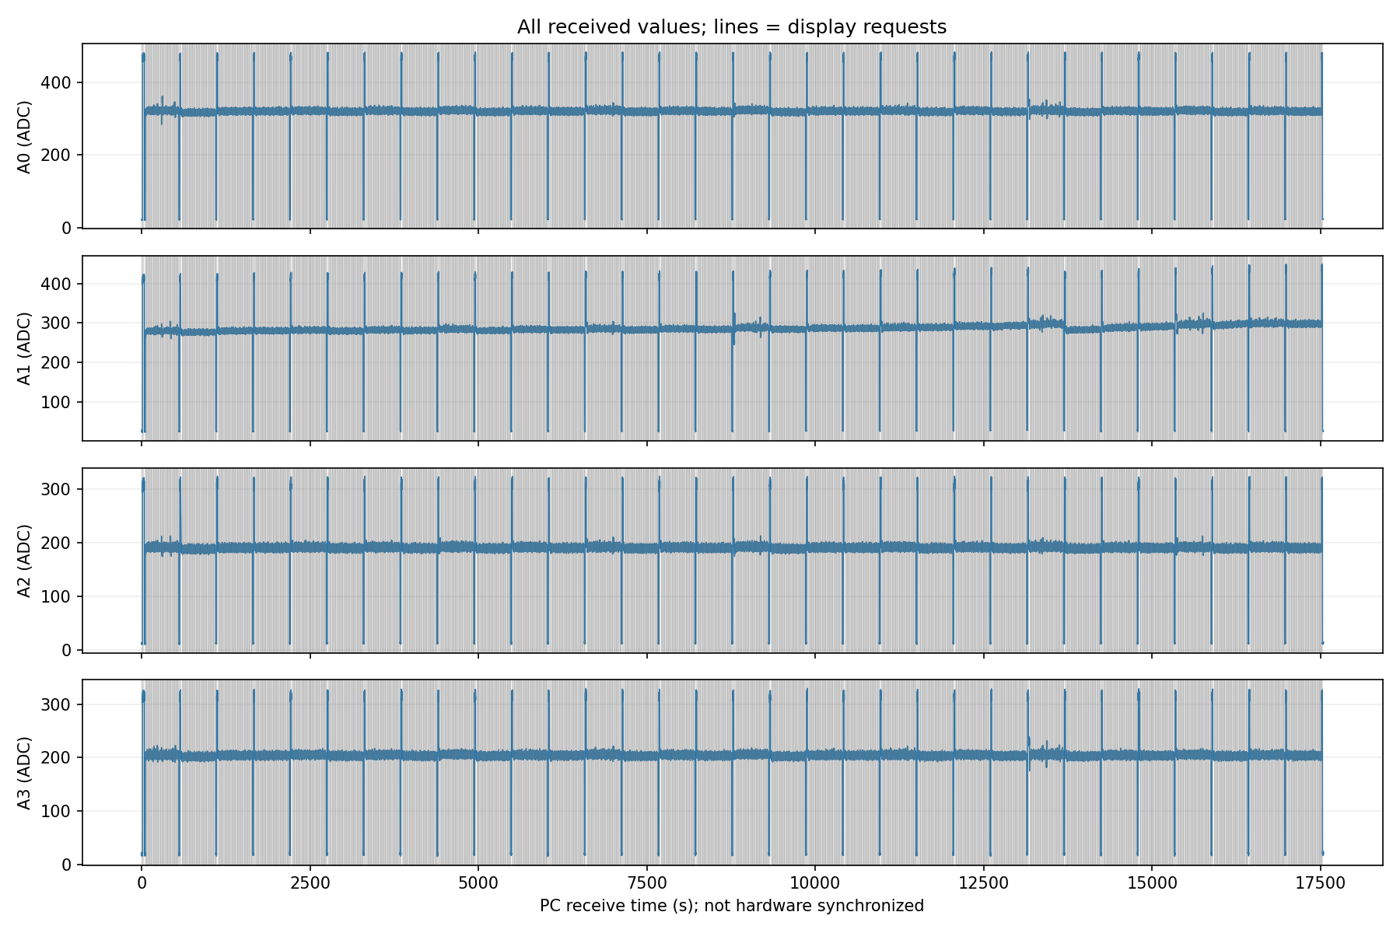
3d_cali/results/hadamard_capture/plots/04_plot_spi_capture_8x8/time_series.png
