GuoJiashu/mech5720-2026-single_pixel_imaging/3d_cali/results/hadamard_capture/plots/08_evaluate_sphere/cross_sections.png

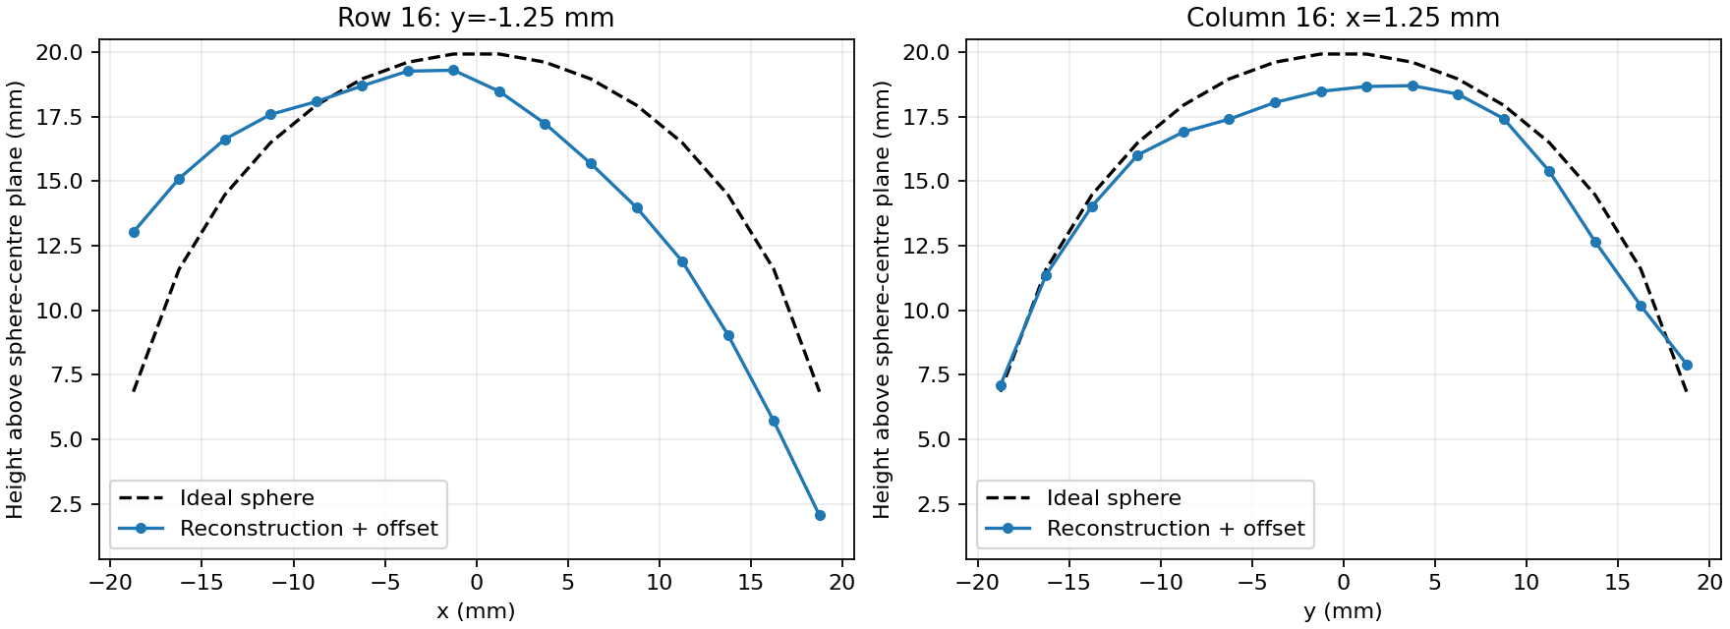
3d_cali/results/hadamard_capture/plots/08_evaluate_sphere/cross_sections.png
