GuoJiashu/mech5720-2026-single_pixel_imaging/3d_cali/results/hadamard_capture/plots/08_evaluate_sphere/evaluation_maps.png

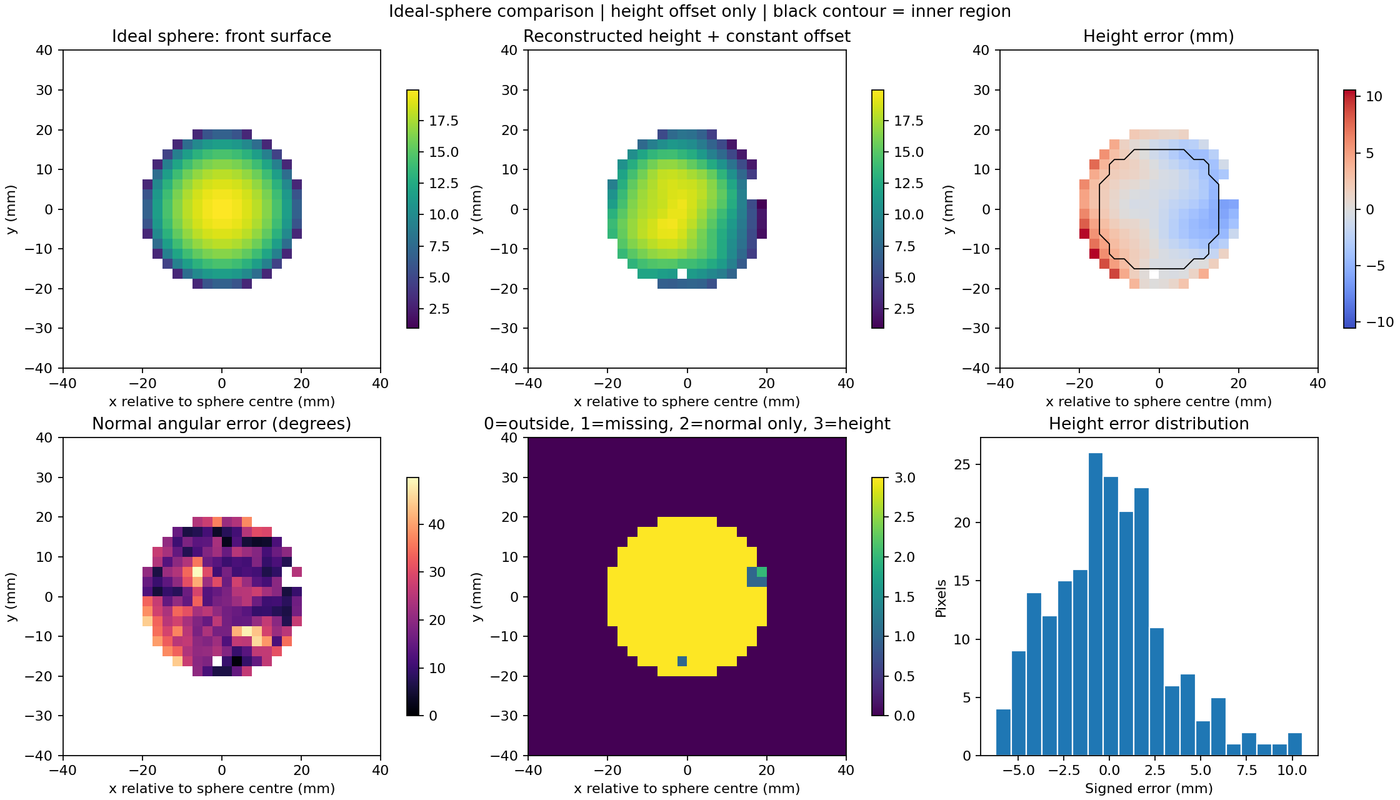
3d_cali/results/hadamard_capture/plots/08_evaluate_sphere/evaluation_maps.png
