GuoJiashu/mech5720-2026-single_pixel_imaging/analyze/background_analysis_results_NLOS/background_drift_comparison_log.png

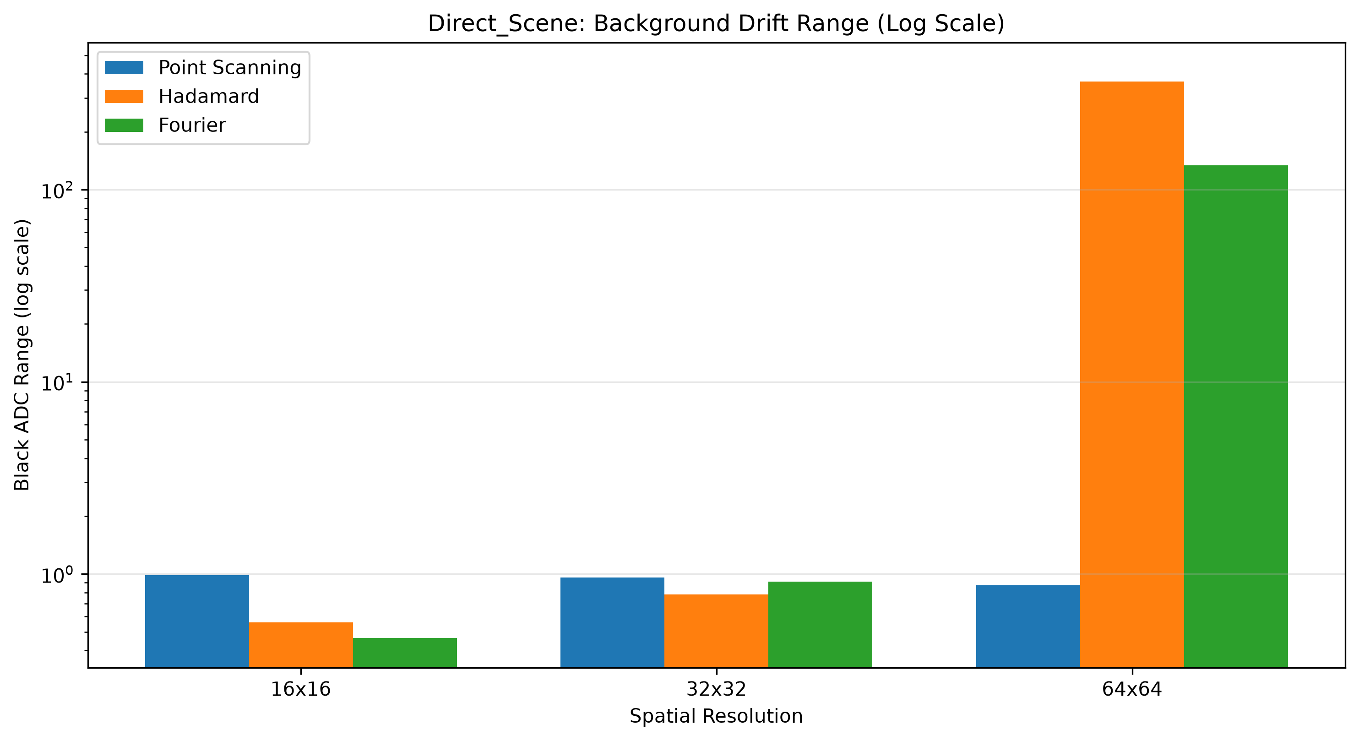
analyze/background_analysis_results_NLOS/background_drift_comparison_log.png
