GuoJiashu/mech5720-2026-single_pixel_imaging/analyze/background_analysis_results_NLOS/background_noise_3x3.png

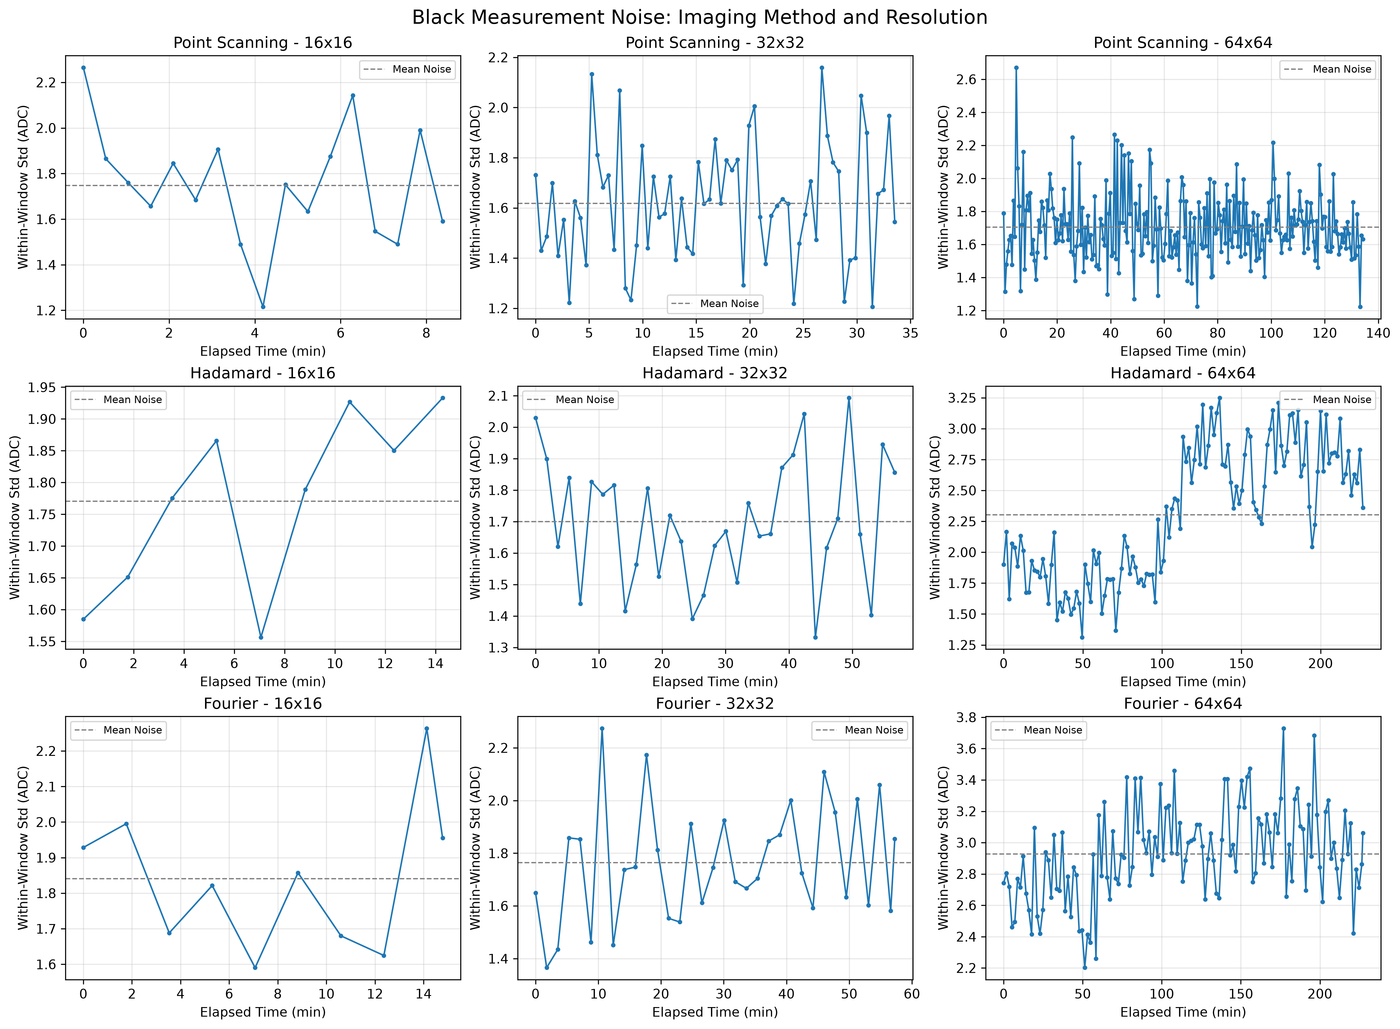
analyze/background_analysis_results_NLOS/background_noise_3x3.png
