GuoJiashu/mech5720-2026-single_pixel_imaging/analyze/compressive_sensing_results/Direct_Scene/Fourier/16x16/quality_vs_sampling_rate.png

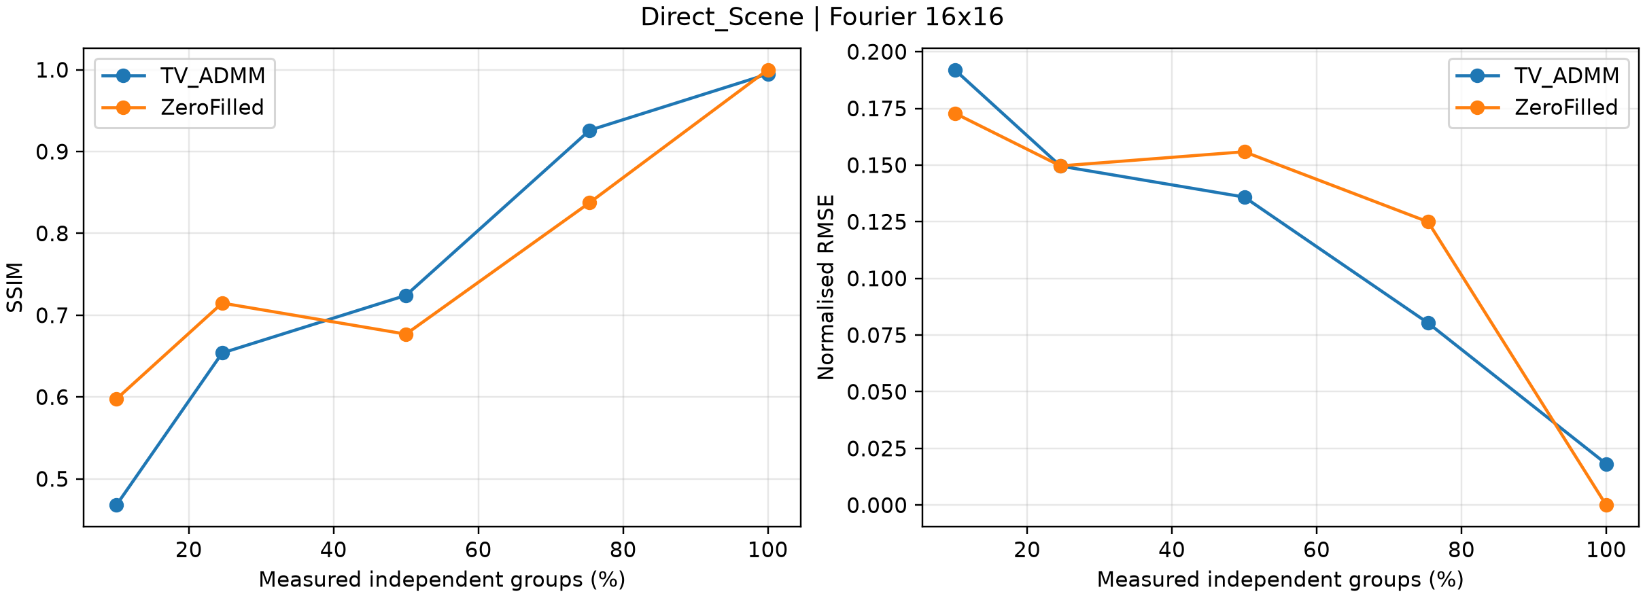
analyze/compressive_sensing_results/Direct_Scene/Fourier/16x16/quality_vs_sampling_rate.png
