GuoJiashu/mech5720-2026-single_pixel_imaging/analyze/compressive_sensing_results/Direct_Scene/Fourier/32x32/sampling_comparison.png

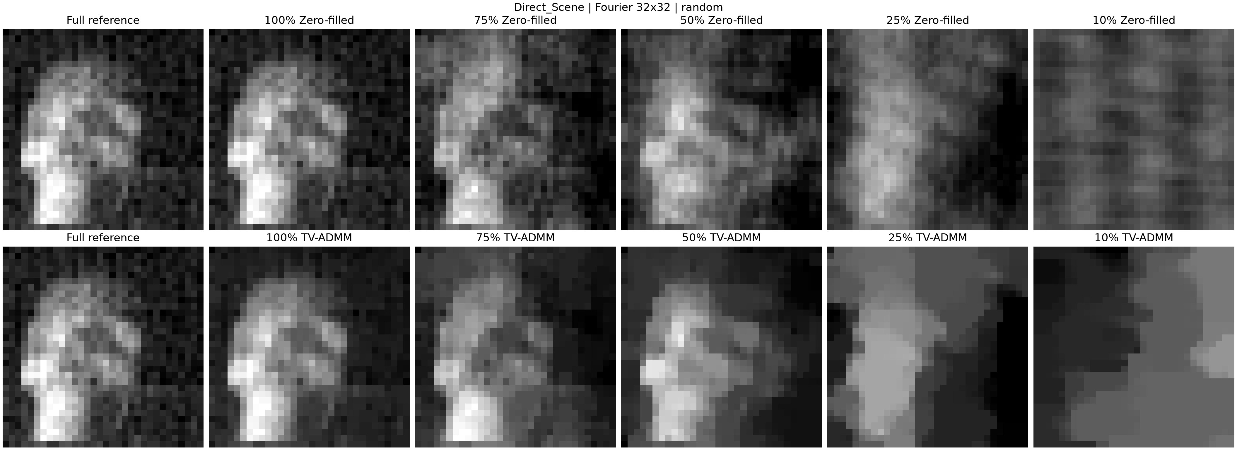
analyze/compressive_sensing_results/Direct_Scene/Fourier/32x32/sampling_comparison.png
