GuoJiashu/mech5720-2026-single_pixel_imaging/analyze/compressive_sensing_results/NLOS/Fourier/16x16/sampling_comparison.png

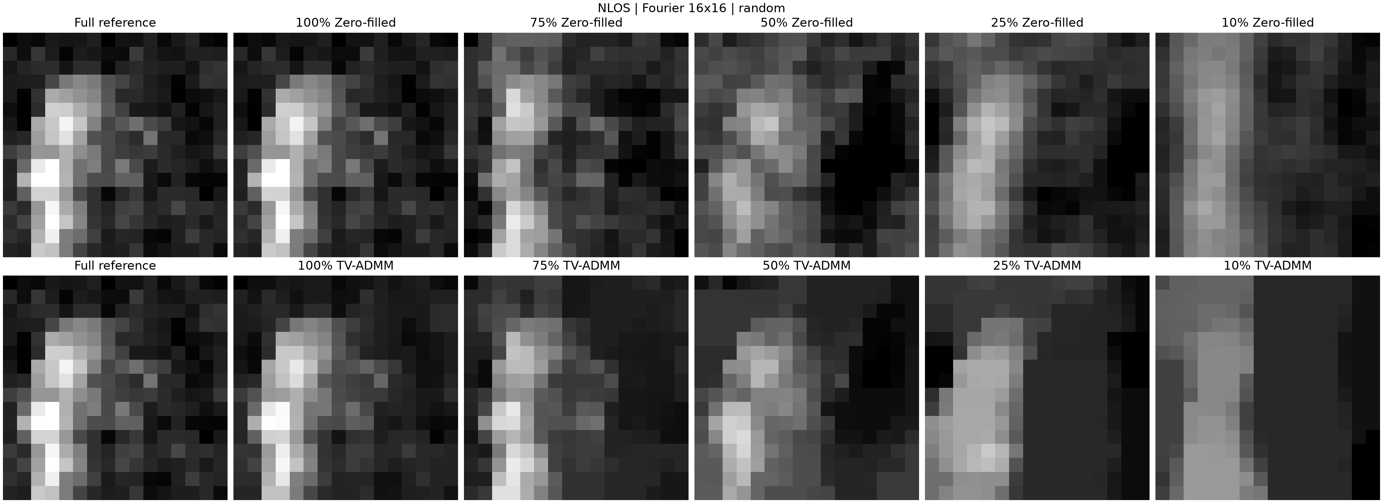
analyze/compressive_sensing_results/NLOS/Fourier/16x16/sampling_comparison.png
