GuoJiashu/mech5720-2026-single_pixel_imaging/analyze/fourier_snr_results/Direct_Scene_fourier_coefficients_snr.png

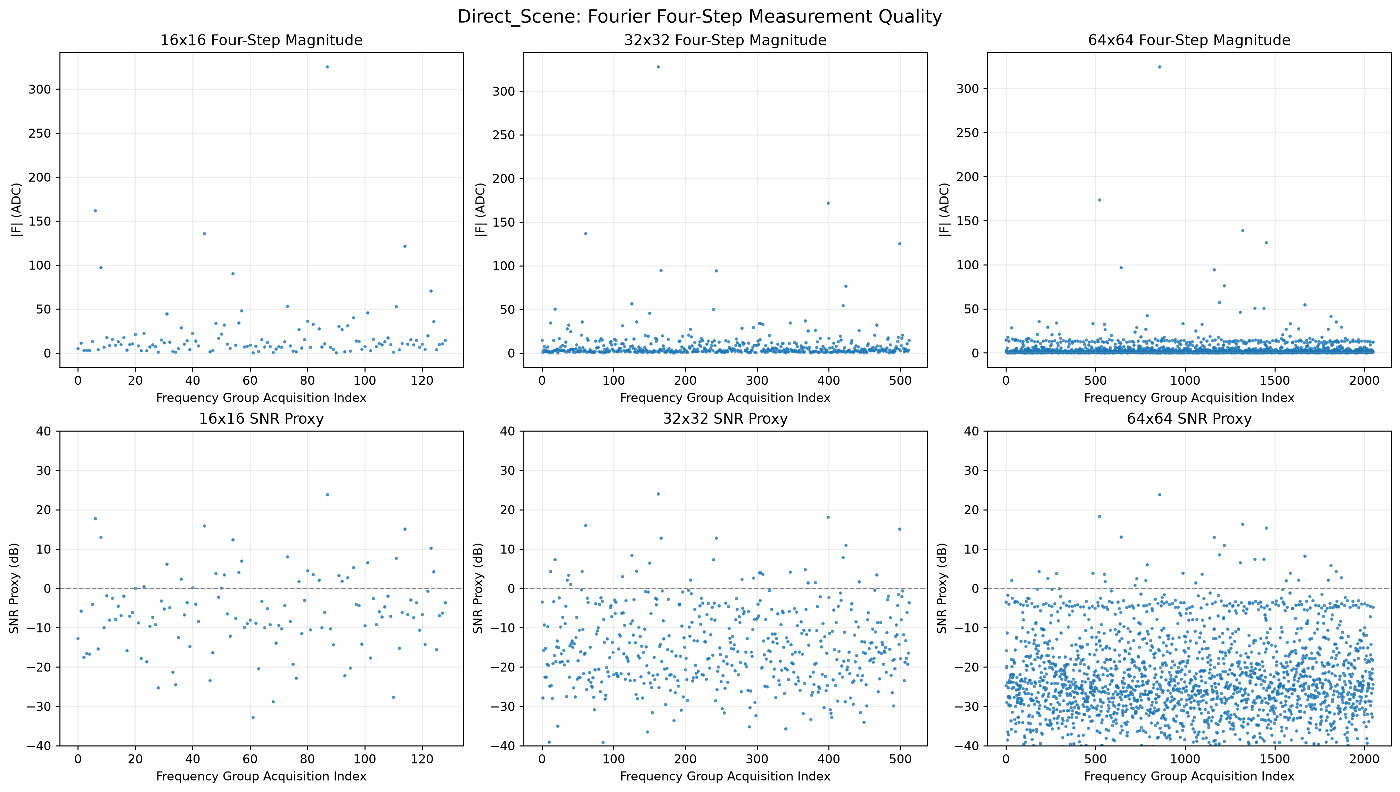
analyze/fourier_snr_results/Direct_Scene_fourier_coefficients_snr.png
