GuoJiashu/mech5720-2026-single_pixel_imaging/analyze/fourier_snr_results/fourier_snr_proxy_resolution_comparison.png

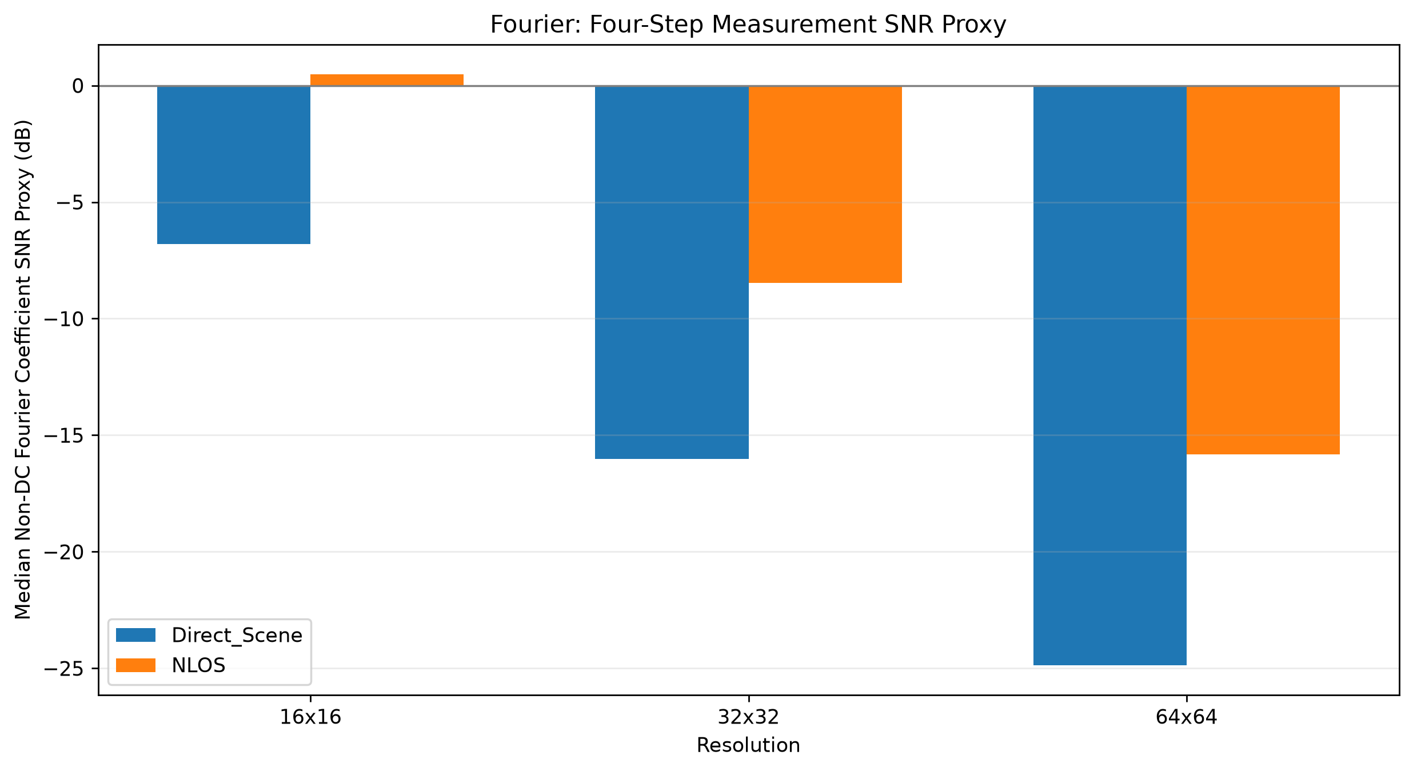
analyze/fourier_snr_results/fourier_snr_proxy_resolution_comparison.png
