GuoJiashu/mech5720-2026-single_pixel_imaging/analyze/fourier_snr_results/NLOS_fourier_acquisition_background.png

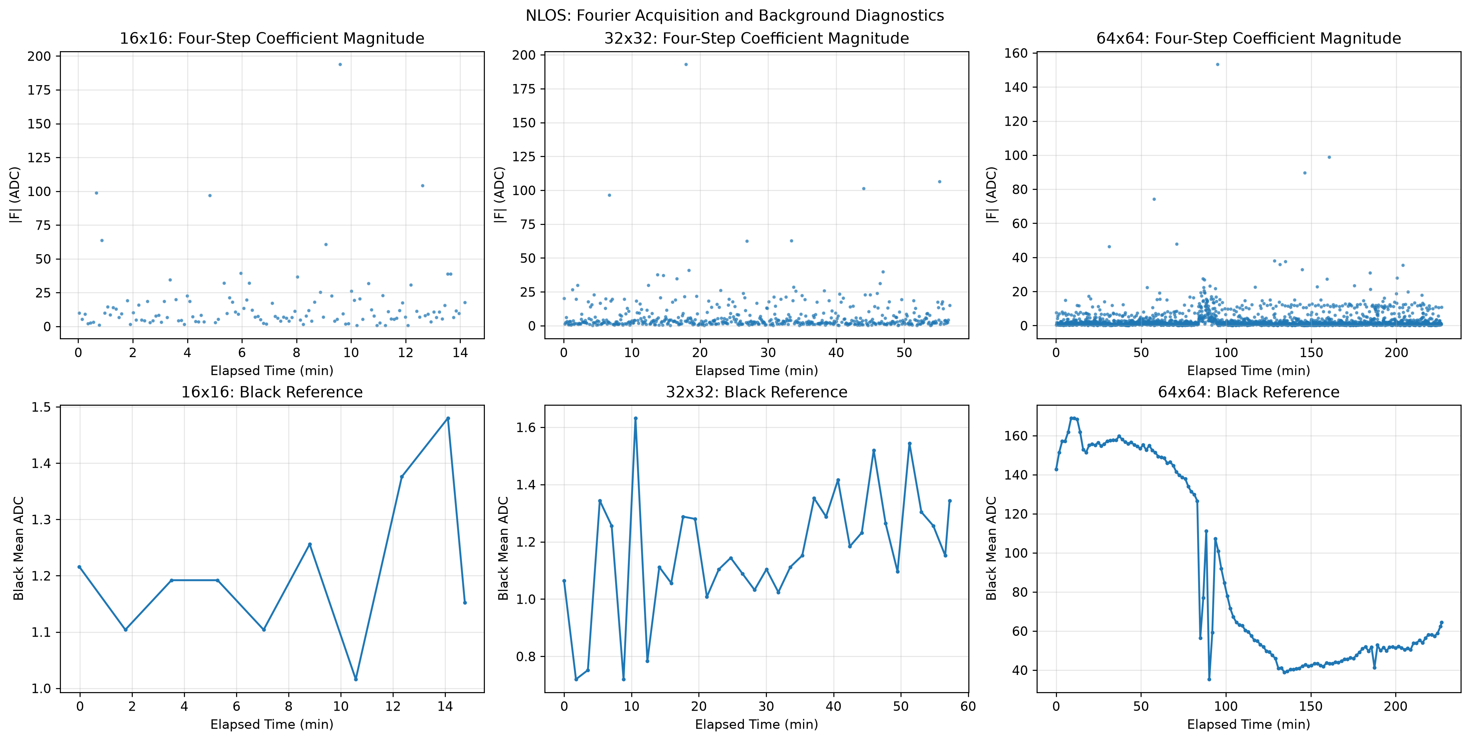
analyze/fourier_snr_results/NLOS_fourier_acquisition_background.png
