GuoJiashu/mech5720-2026-single_pixel_imaging/analyze/fourier_snr_results/NLOS_fourier_radial_snr.png

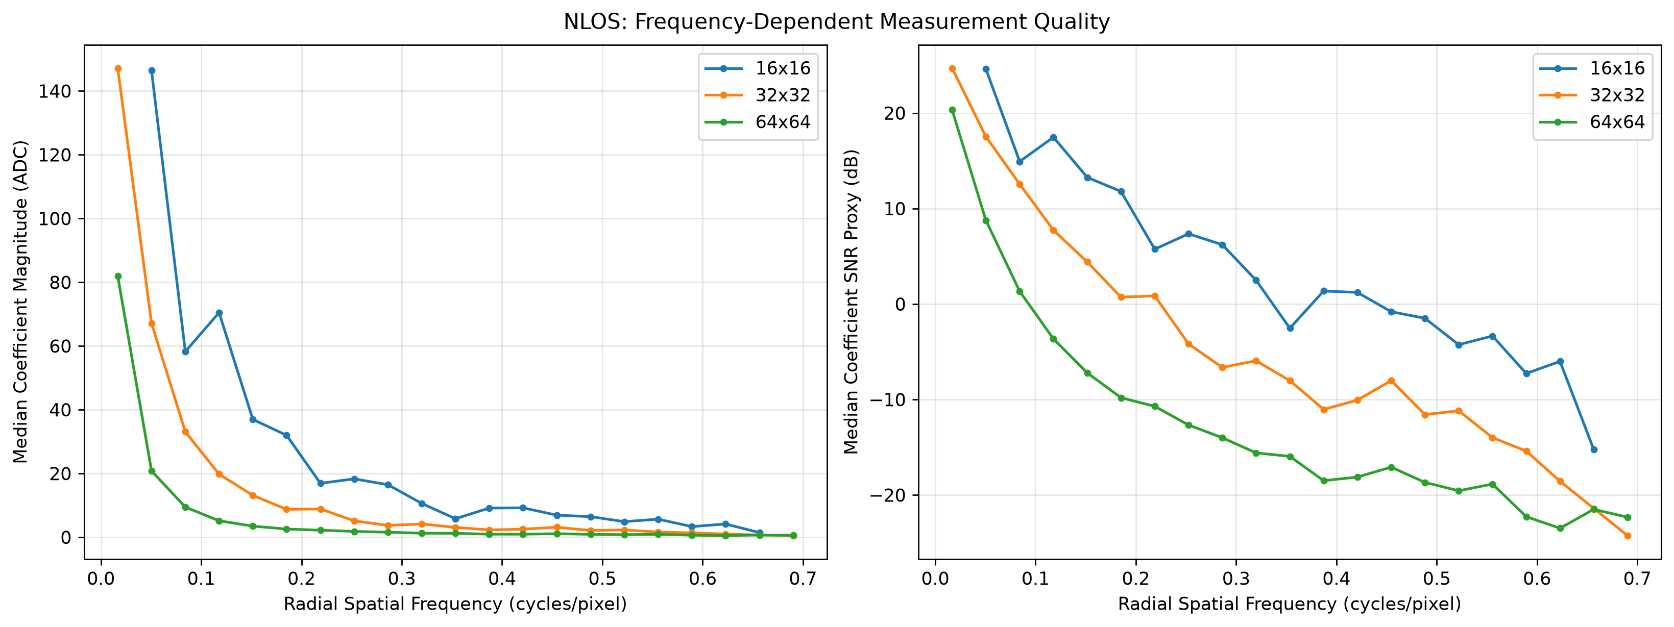
analyze/fourier_snr_results/NLOS_fourier_radial_snr.png
