GuoJiashu/mech5720-2026-single_pixel_imaging/analyze/fourier_snr_results/NLOS_fourier_snr_distribution.png

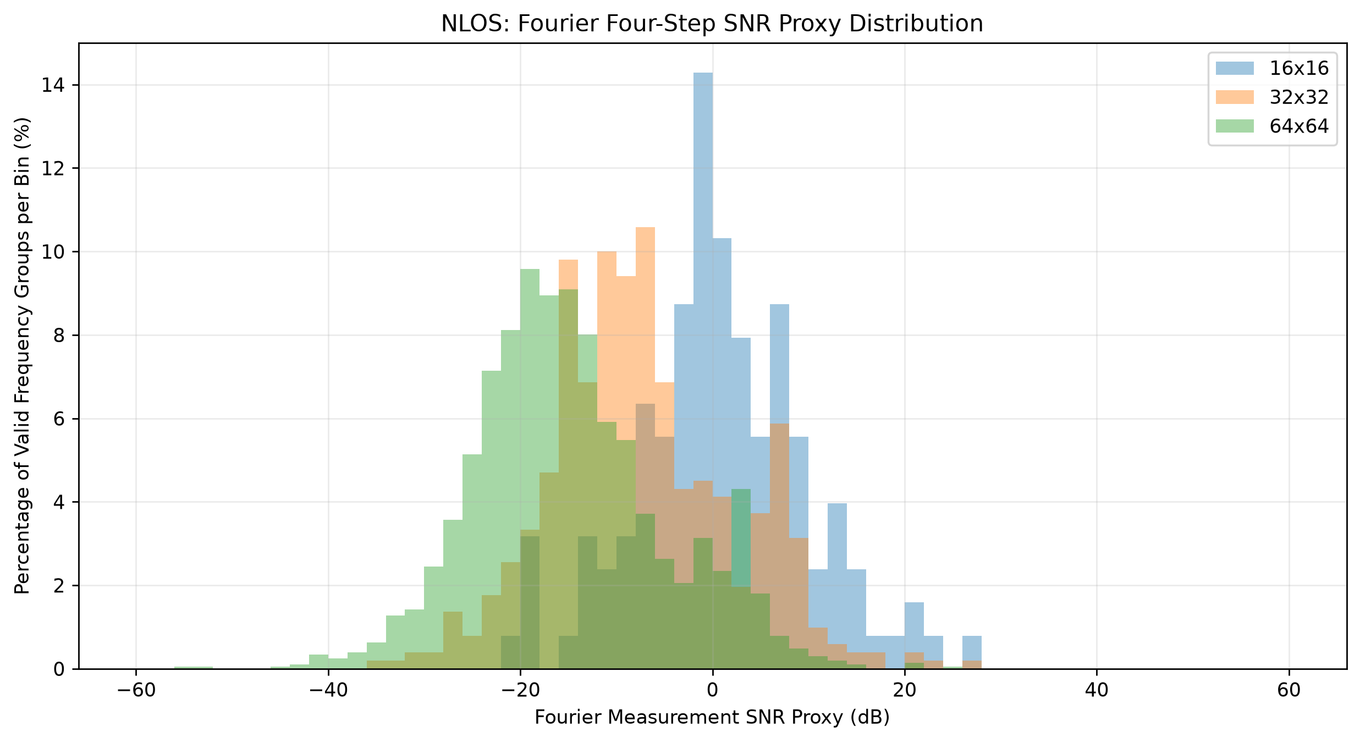
analyze/fourier_snr_results/NLOS_fourier_snr_distribution.png
