GuoJiashu/mech5720-2026-single_pixel_imaging/analyze/hadamard_snr_results/Direct_Scene_hadamard_coefficients_snr.png

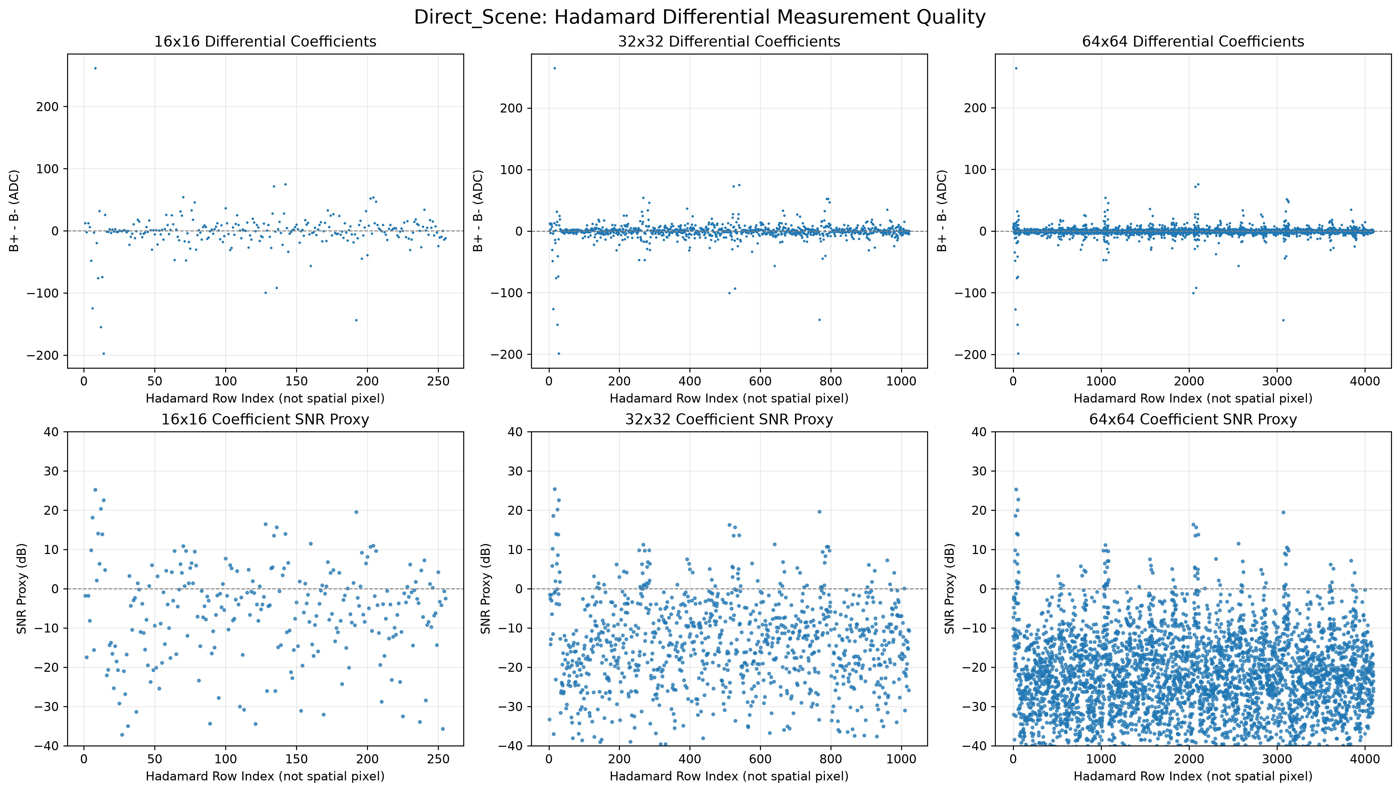
analyze/hadamard_snr_results/Direct_Scene_hadamard_coefficients_snr.png
