GuoJiashu/mech5720-2026-single_pixel_imaging/analyze/hadamard_snr_results/hadamard_snr_proxy_resolution_comparison.png

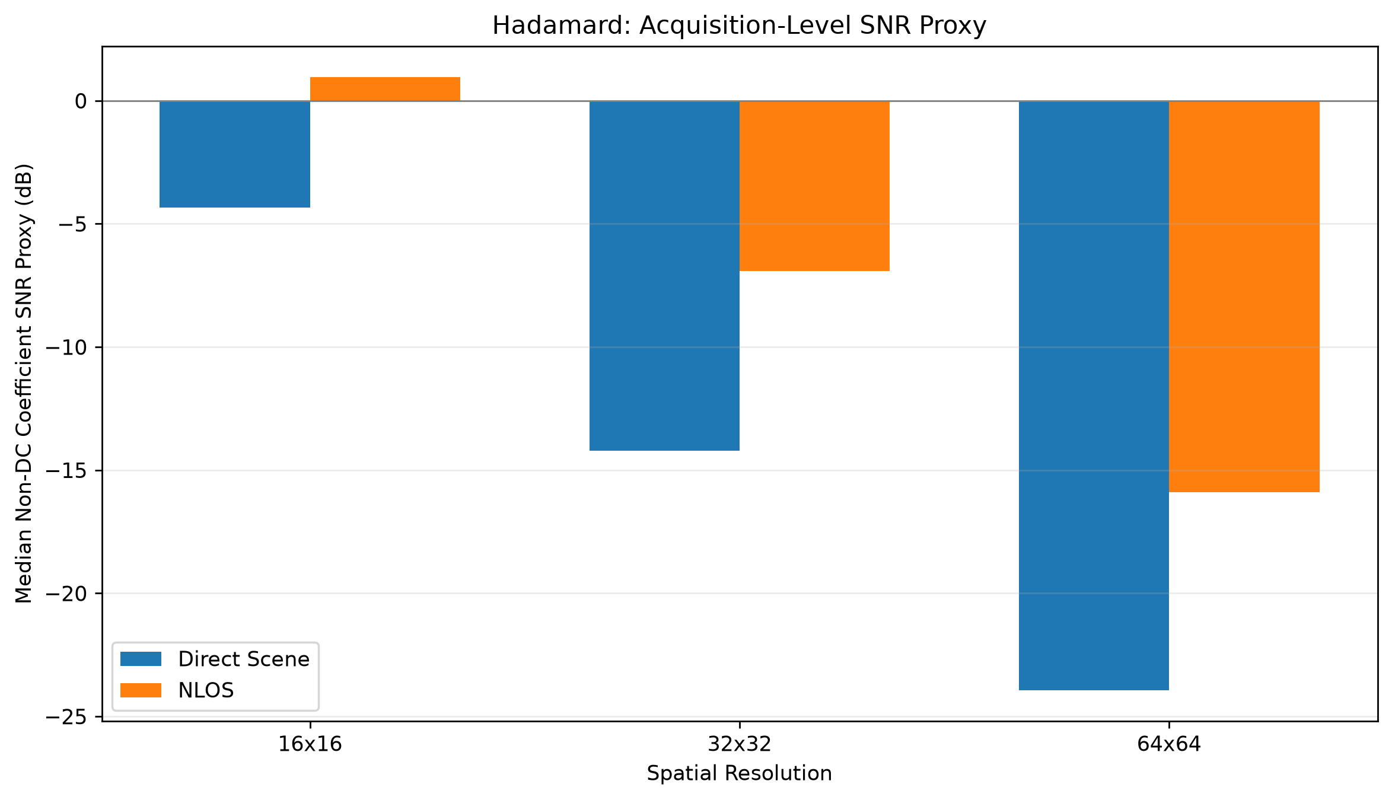
analyze/hadamard_snr_results/hadamard_snr_proxy_resolution_comparison.png
