GuoJiashu/mech5720-2026-single_pixel_imaging/analyze/hadamard_snr_results/NLOS_hadamard_snr_distribution.png

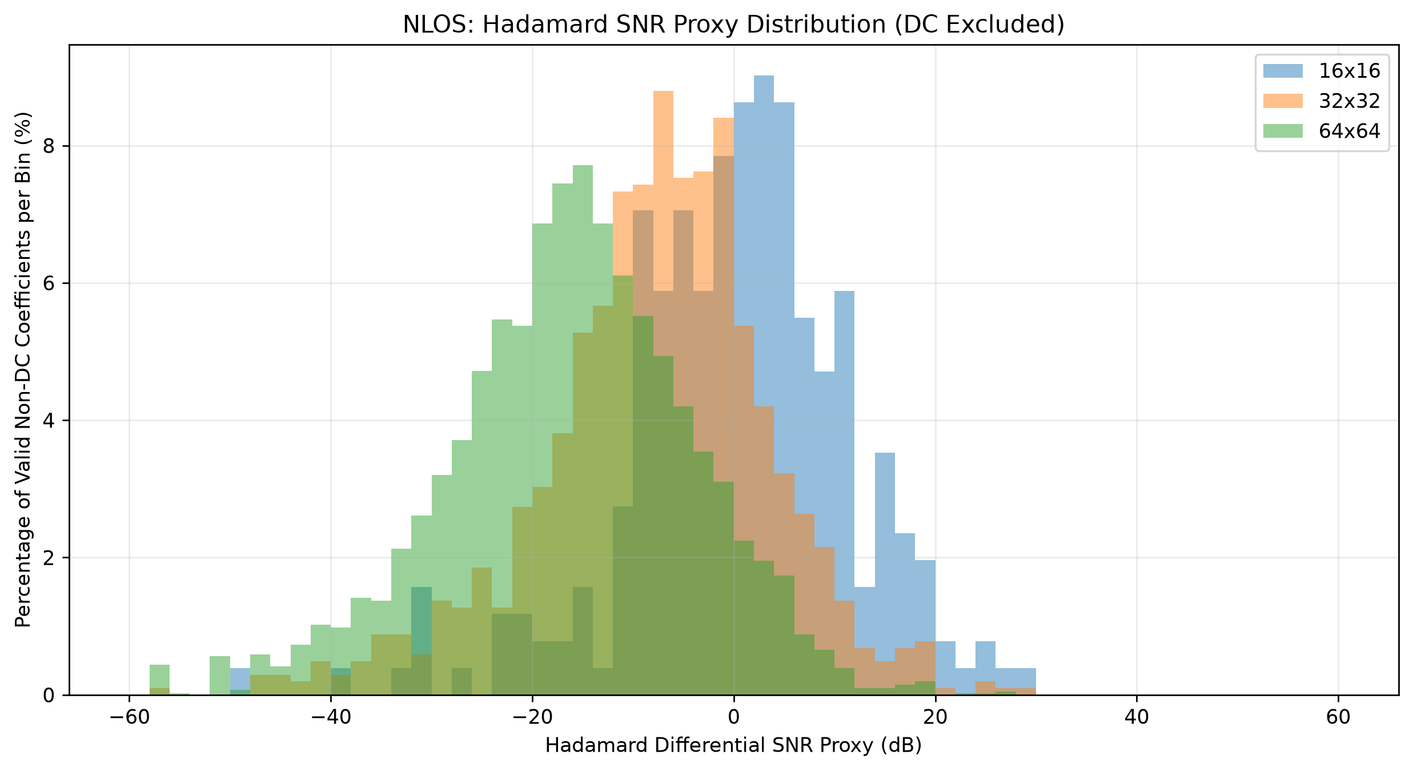
analyze/hadamard_snr_results/NLOS_hadamard_snr_distribution.png
