GuoJiashu/mech5720-2026-single_pixel_imaging/analyze/image_cnr_results/NLOS_image_cnr_comparison.png

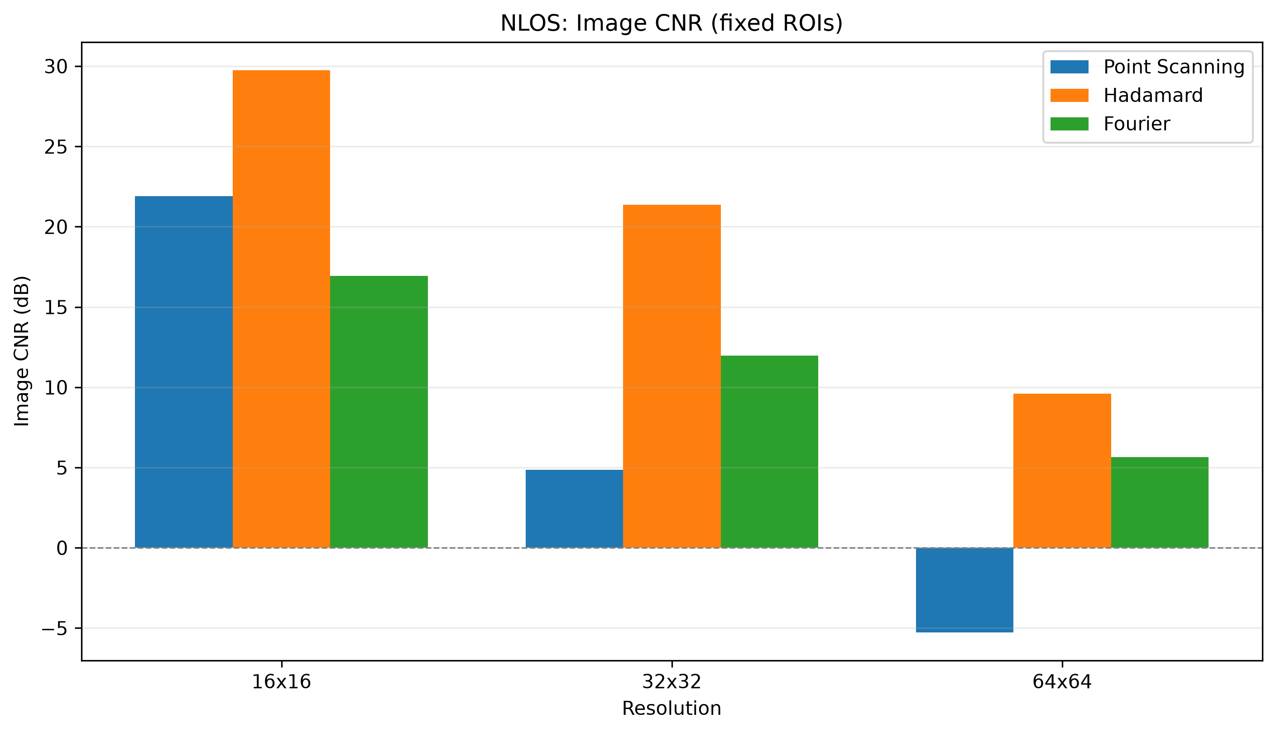
analyze/image_cnr_results/NLOS_image_cnr_comparison.png
