GuoJiashu/mech5720-2026-single_pixel_imaging/analyze/image_cnr_results/NLOS_roi_overlays.png

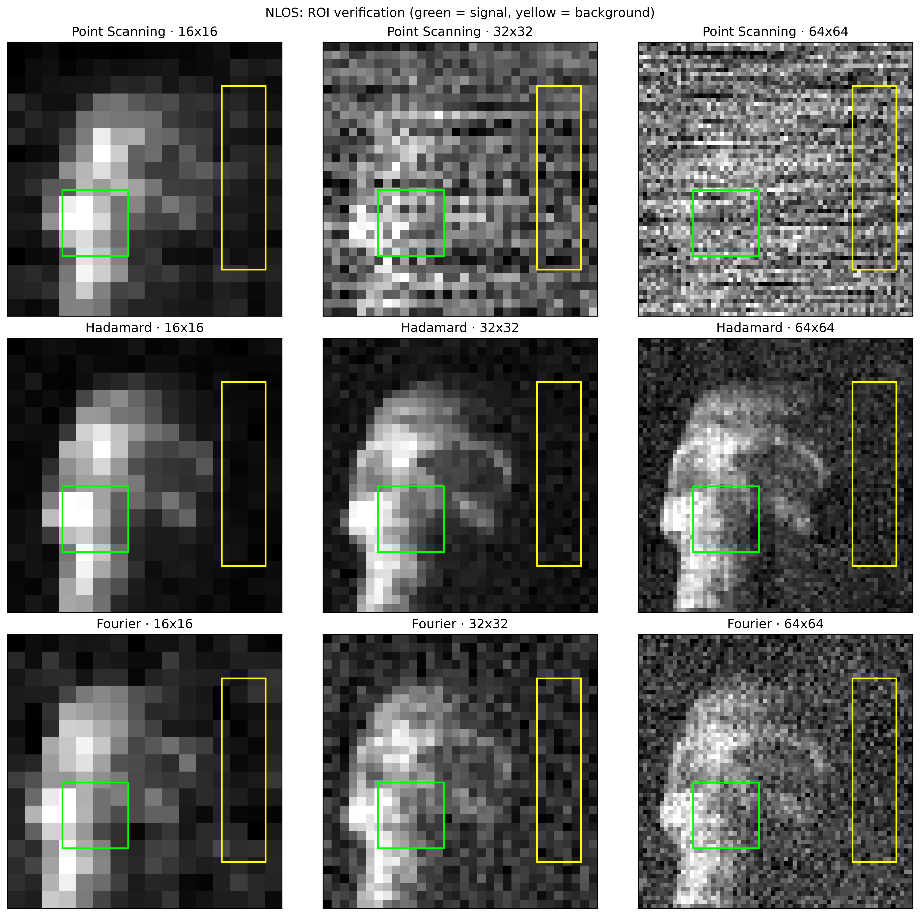
analyze/image_cnr_results/NLOS_roi_overlays.png
