GuoJiashu/mech5720-2026-single_pixel_imaging/analyze/point_scanning_snr_results/Direct_Scene_signal_snr_maps.png

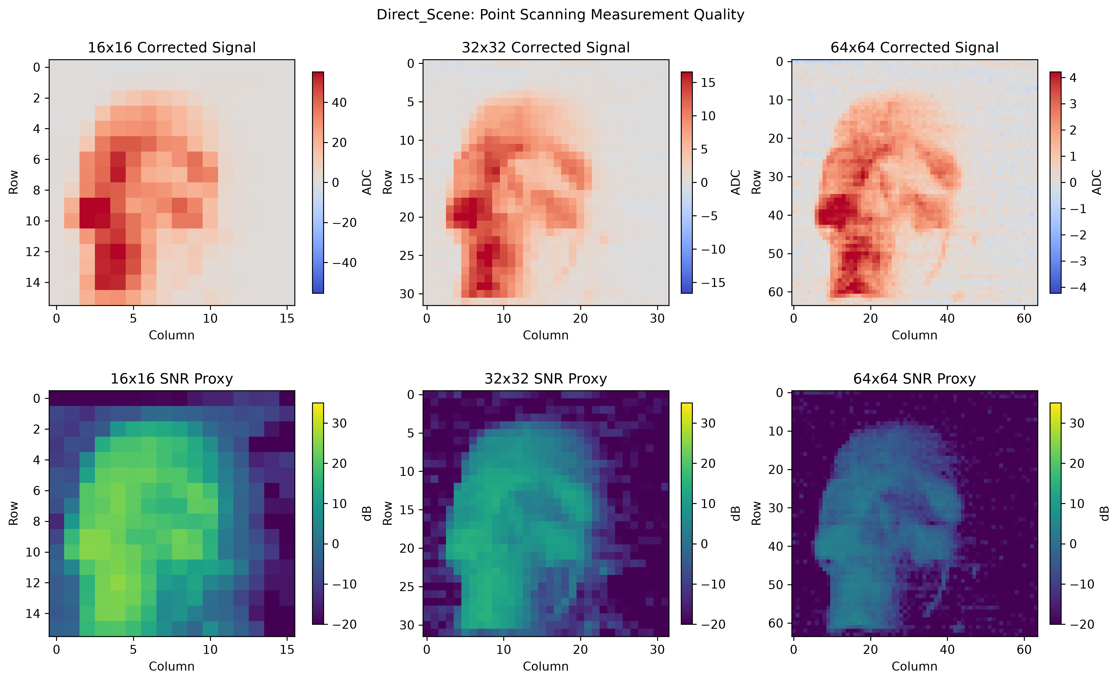
analyze/point_scanning_snr_results/Direct_Scene_signal_snr_maps.png
