GuoJiashu/mech5720-2026-single_pixel_imaging/analyze/point_scanning_snr_results/NLOS_snr_distribution.png

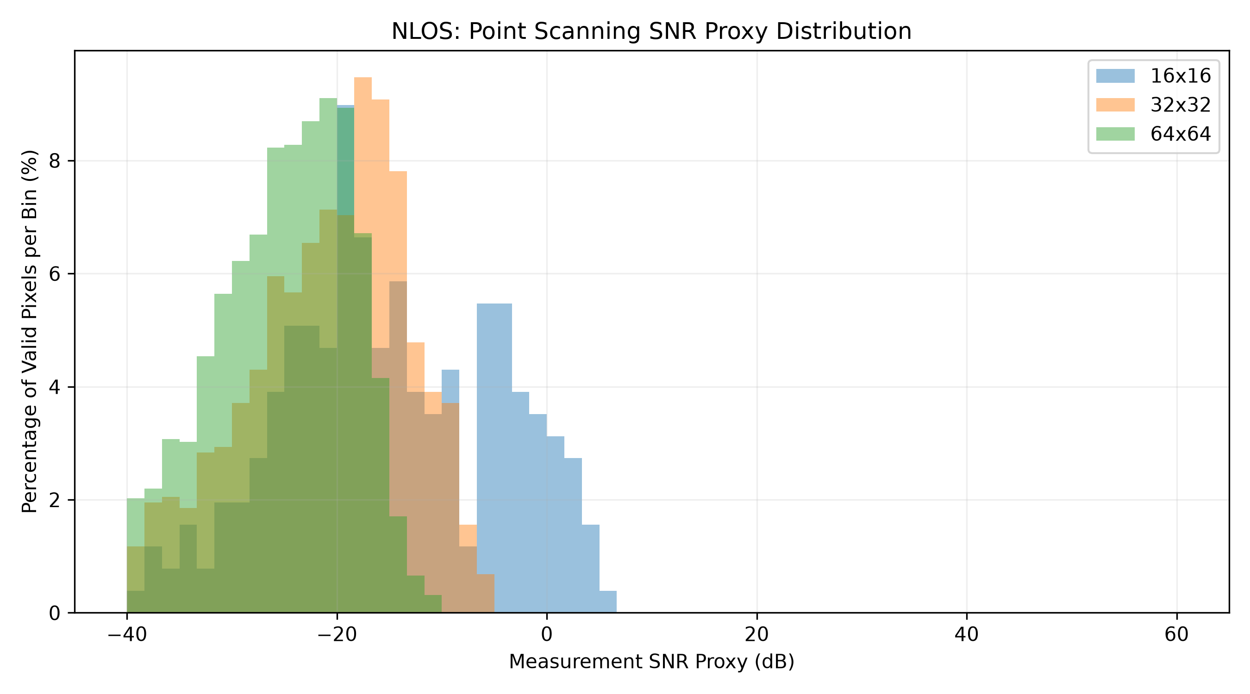
analyze/point_scanning_snr_results/NLOS_snr_distribution.png
