GuoJiashu/mech5720-2026-single_pixel_imaging/analyze/point_scanning_snr_results/snr_proxy_resolution_comparison.png

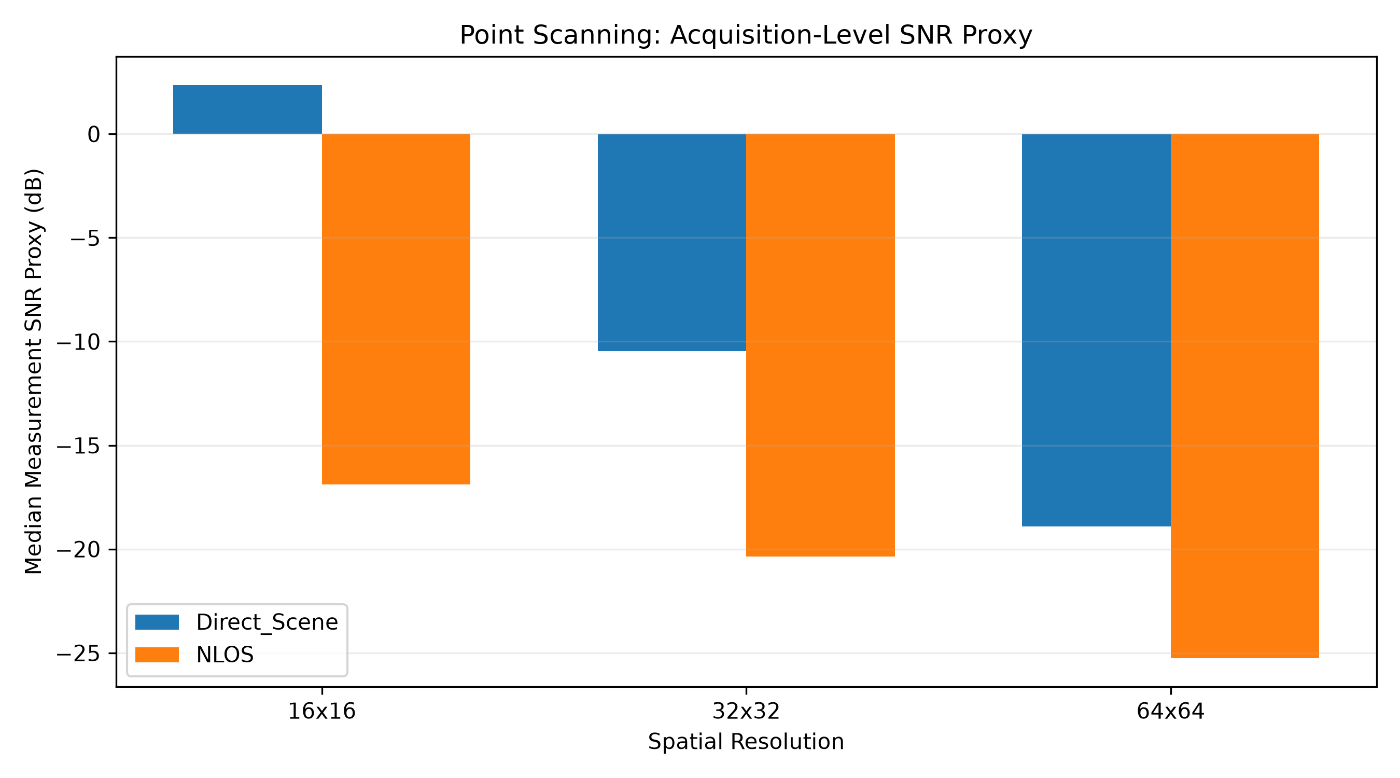
analyze/point_scanning_snr_results/snr_proxy_resolution_comparison.png
