GuoJiashu/mech5720-2026-single_pixel_imaging/analyze/report_results/compressive_sensing/direct_hadamard_comparison.png

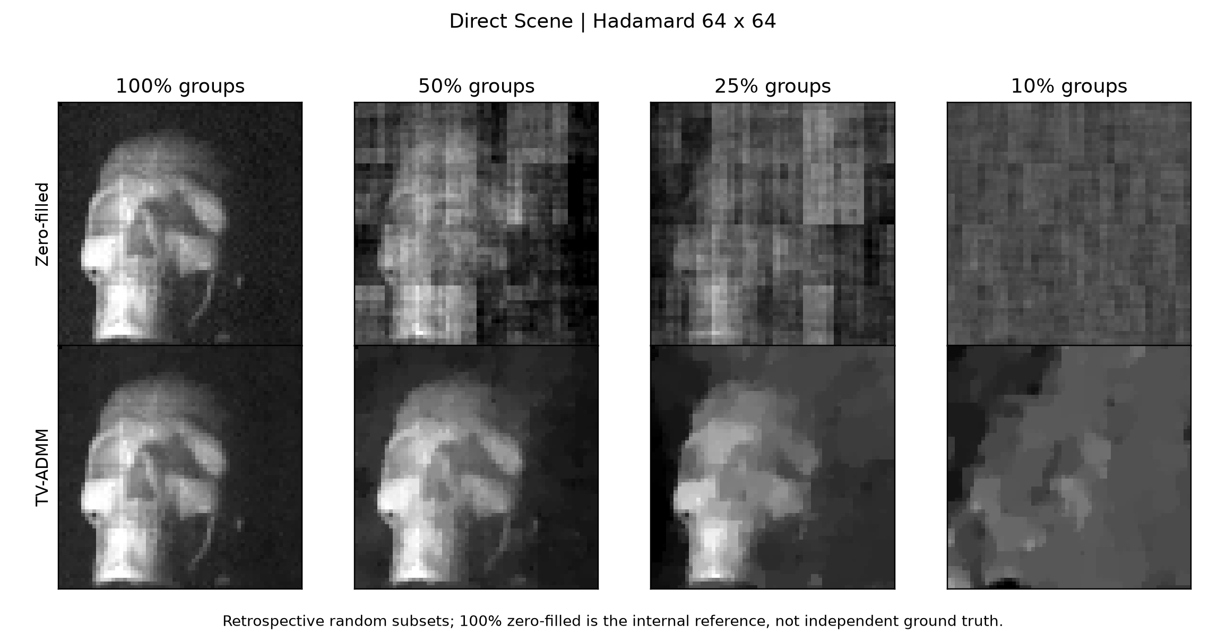
analyze/report_results/compressive_sensing/direct_hadamard_comparison.png
