GuoJiashu/mech5720-2026-single_pixel_imaging/analyze/report_results/supporting/background_drift_examples.png

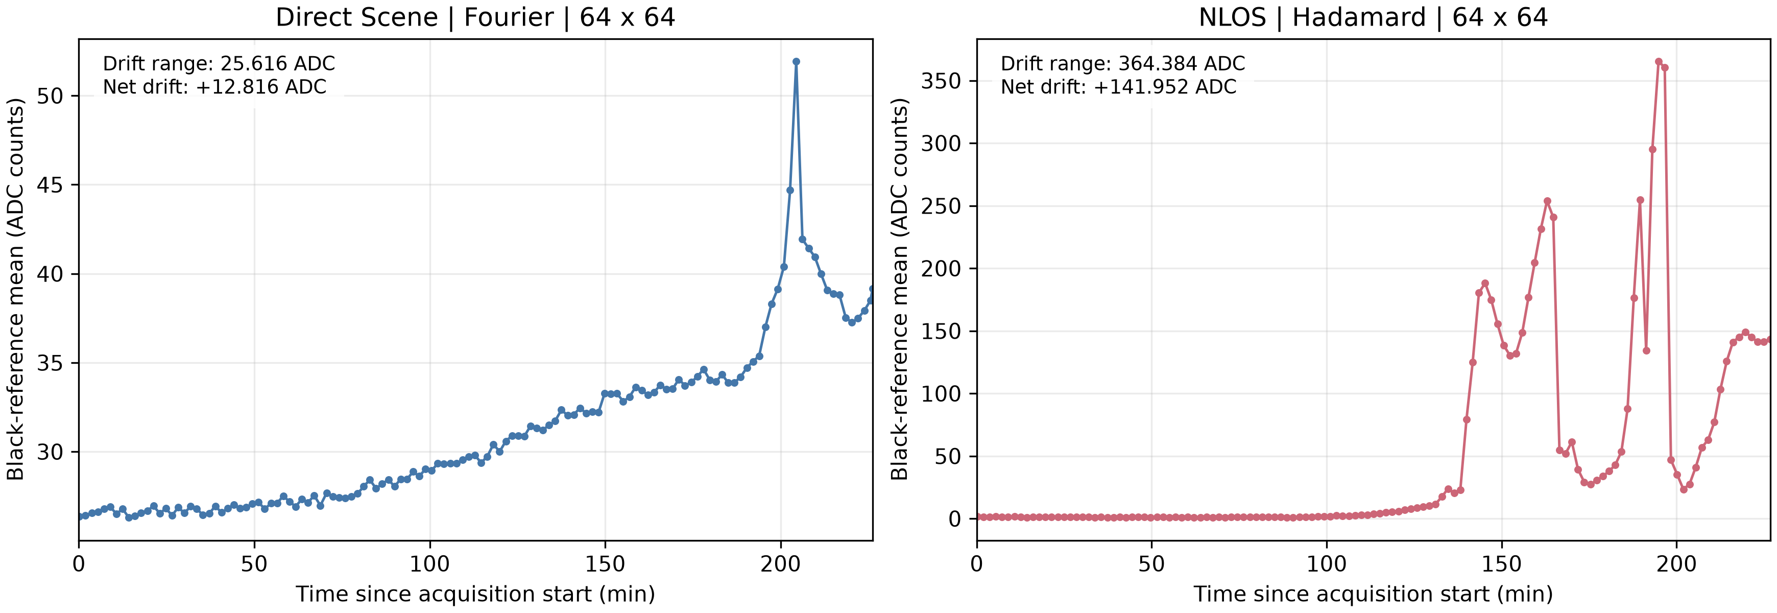
analyze/report_results/supporting/background_drift_examples.png
