GuoJiashu/mech5720-2026-single_pixel_imaging/analyze/report_results/supporting/roi_verification.png

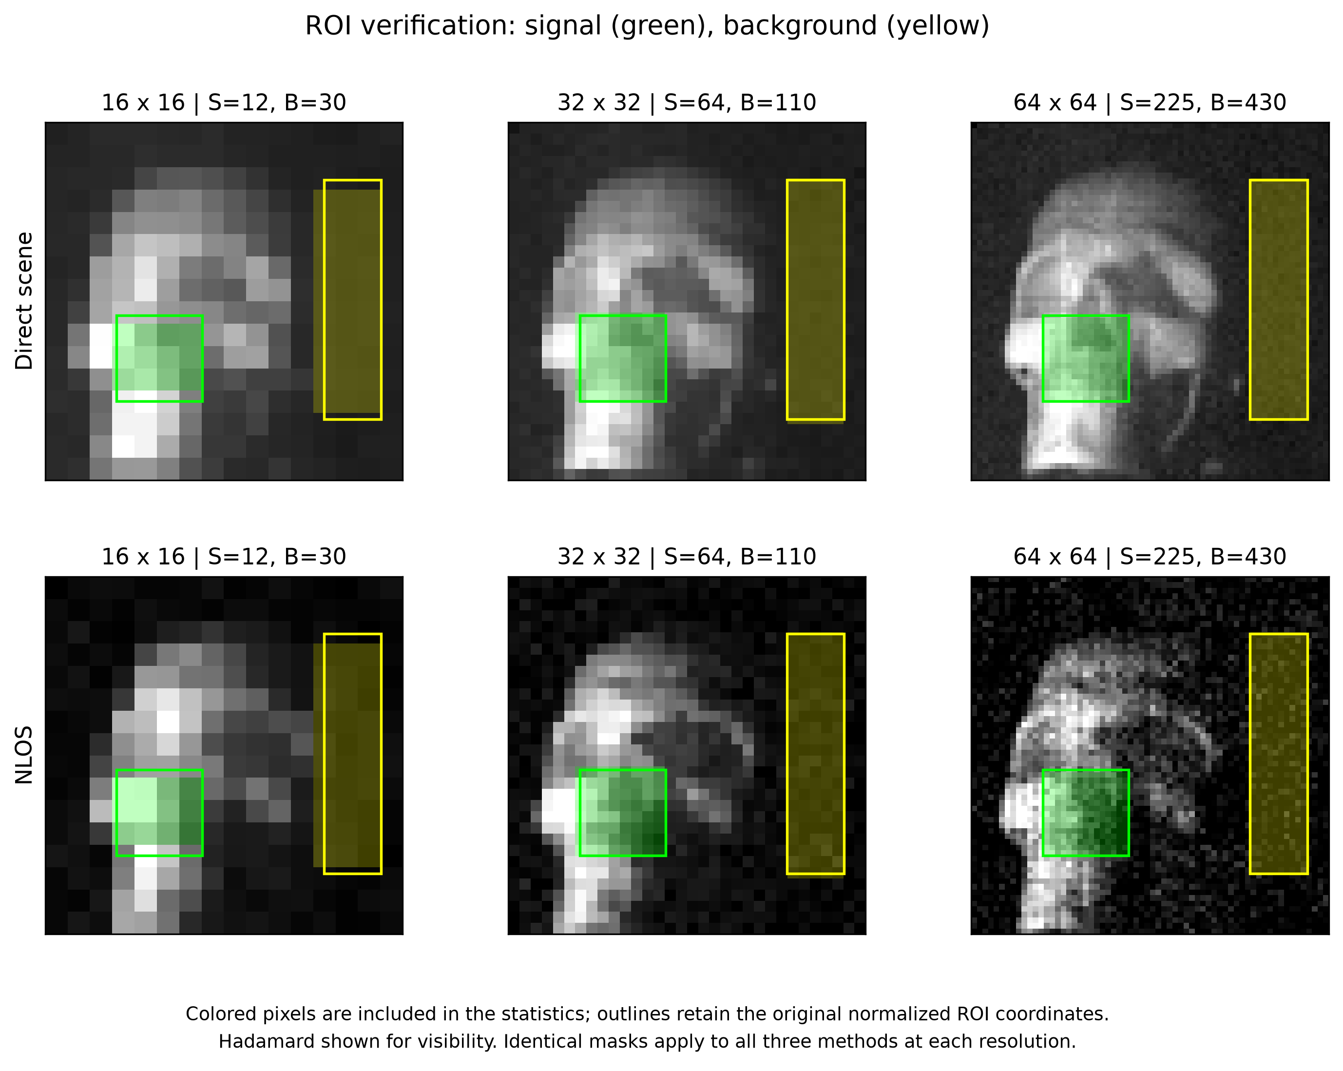
analyze/report_results/supporting/roi_verification.png
