GuoJiashu/mech5720-2026-single_pixel_imaging/cali/results/auto_ldr/20261028_223808_497898/grayscale_response.png

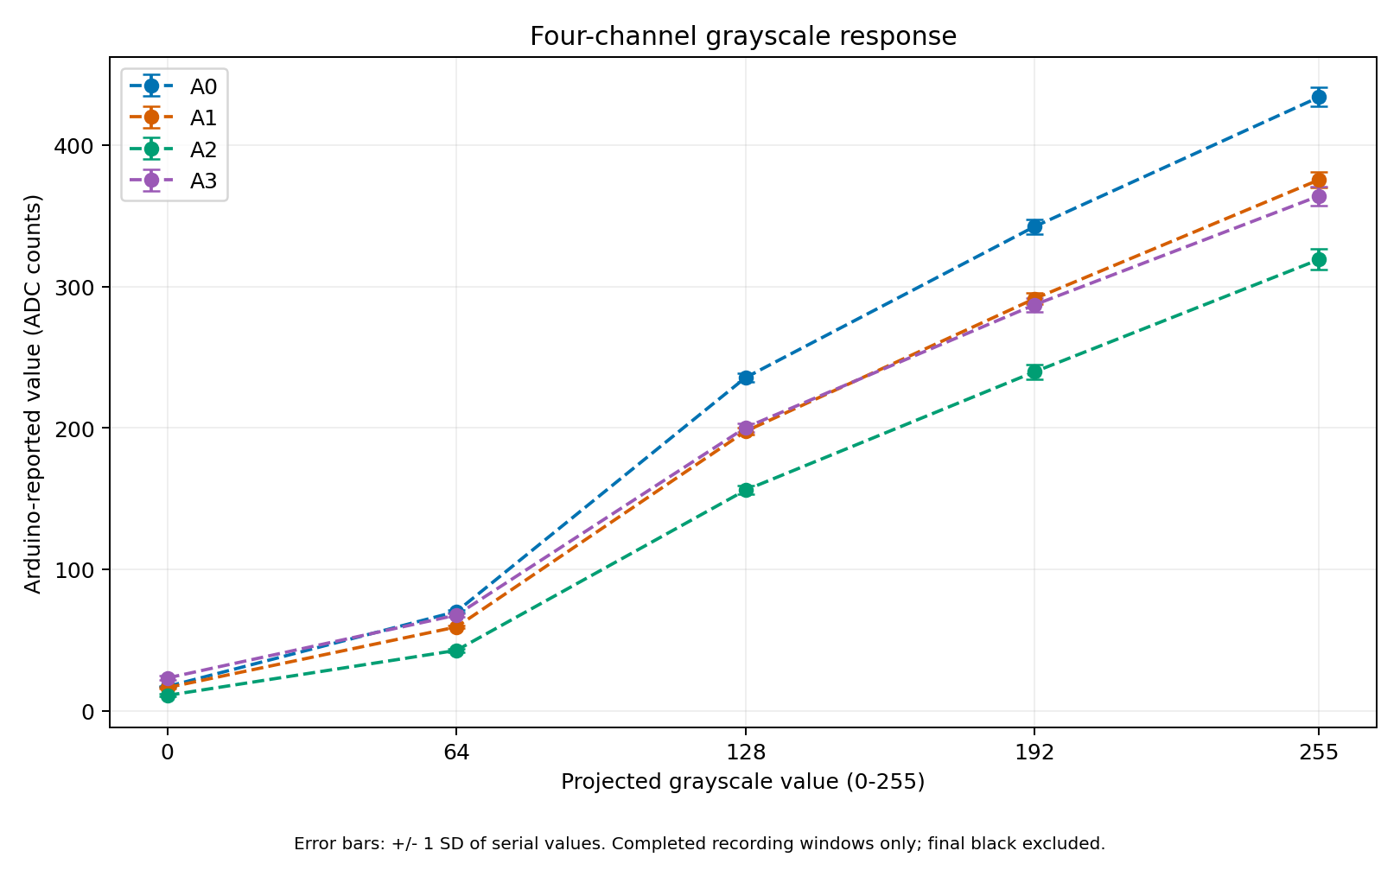
cali/results/auto_ldr/20261028_223808_497898/grayscale_response.png
