GuoJiashu/mech5720-2026-single_pixel_imaging/cali/results/ldr_additivity/20261028_234548_079367/additivity_results.png

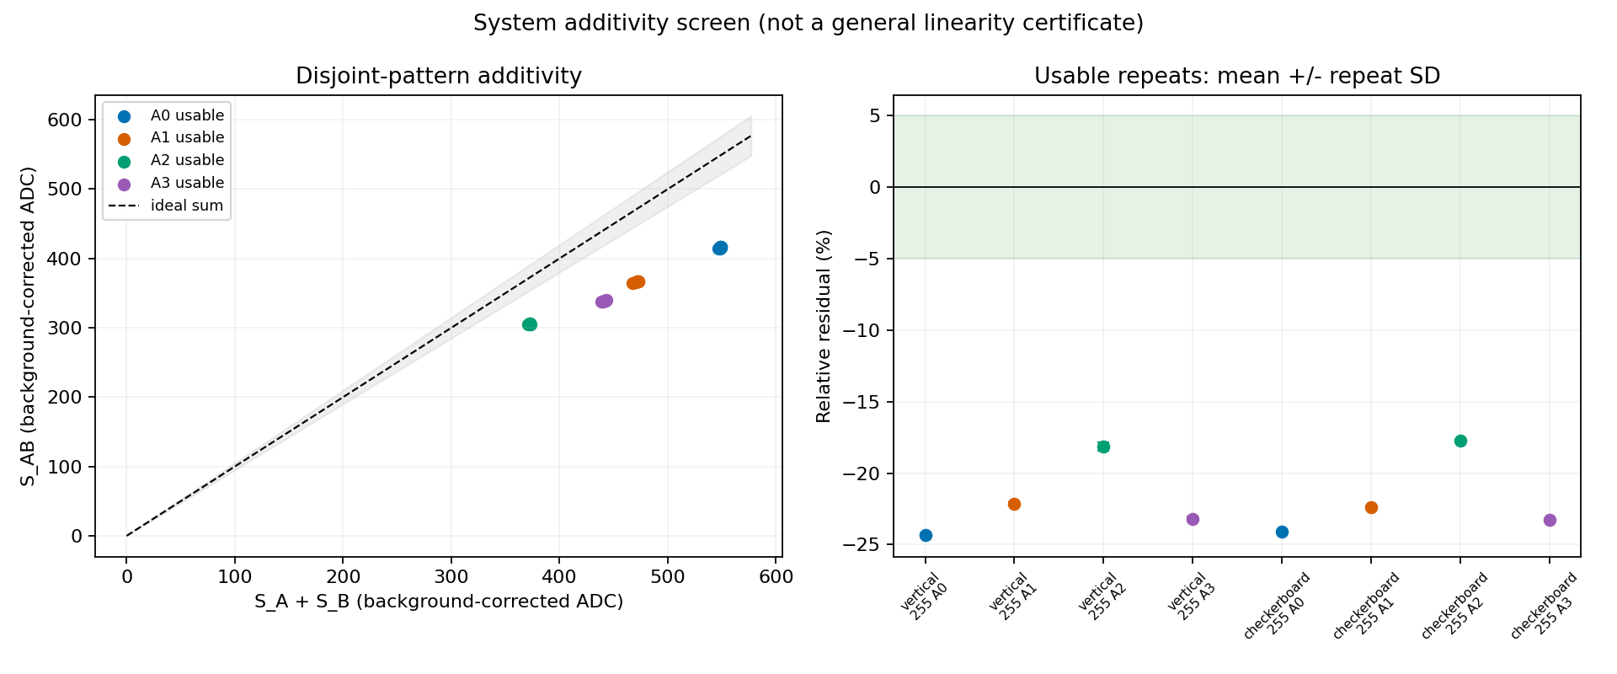
cali/results/ldr_additivity/20261028_234548_079367/additivity_results.png
