GuoJiashu/mech5720-2026-single_pixel_imaging/cali/results/ldr_additivity/20261029_005406_078480/pattern_masks.png

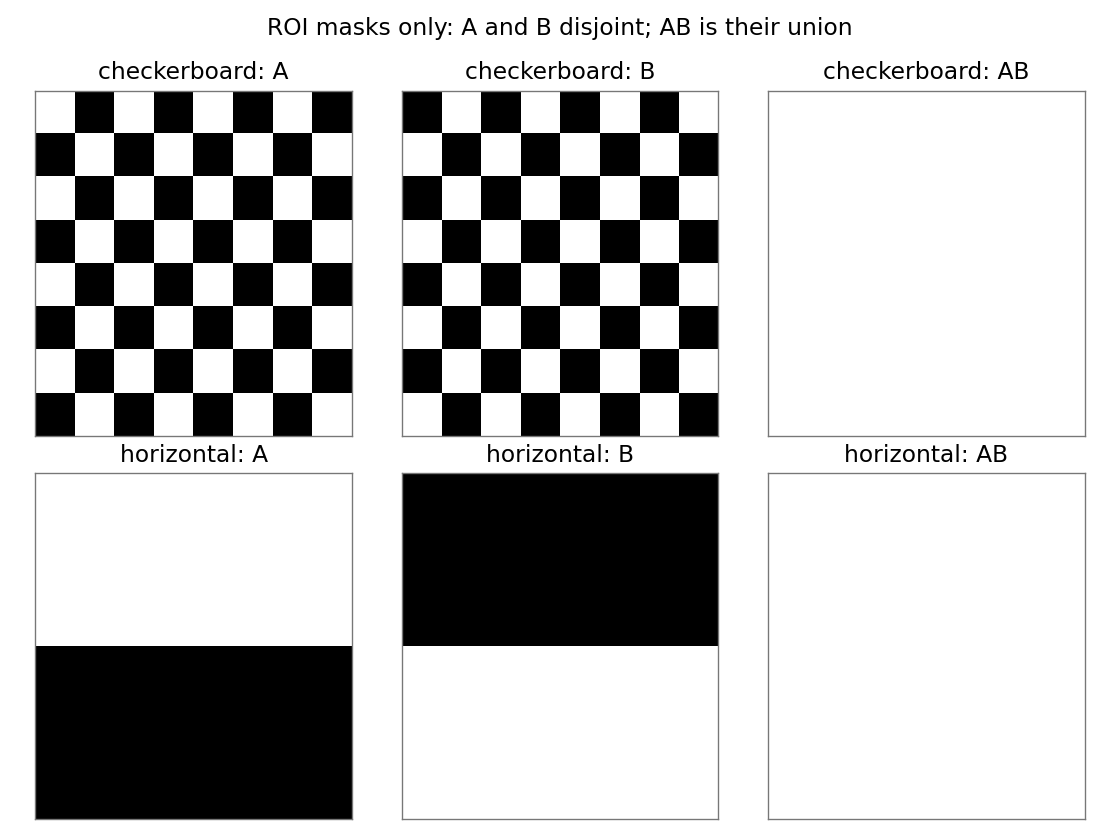
cali/results/ldr_additivity/20261029_005406_078480/pattern_masks.png
