GuoJiashu/mech5720-2026-single_pixel_imaging/cali/results/ldr_timing/20261028_231529_496515/time_series.png

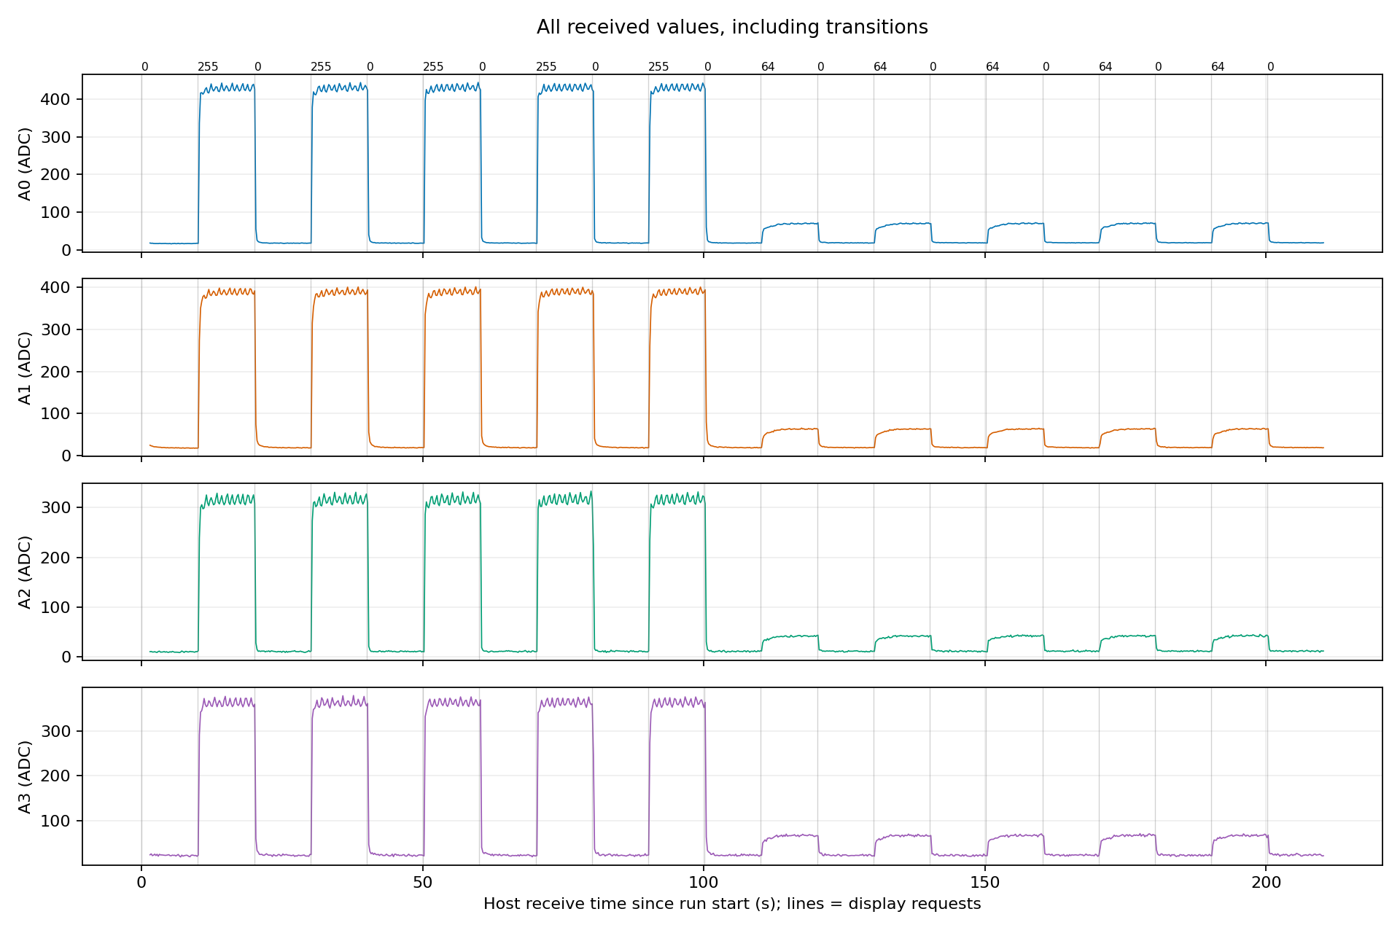
cali/results/ldr_timing/20261028_231529_496515/time_series.png
