GuoJiashu/mech5720-2026-single_pixel_imaging/cali/results/spatial_response/20261023_173256_037635/spatial_response.png

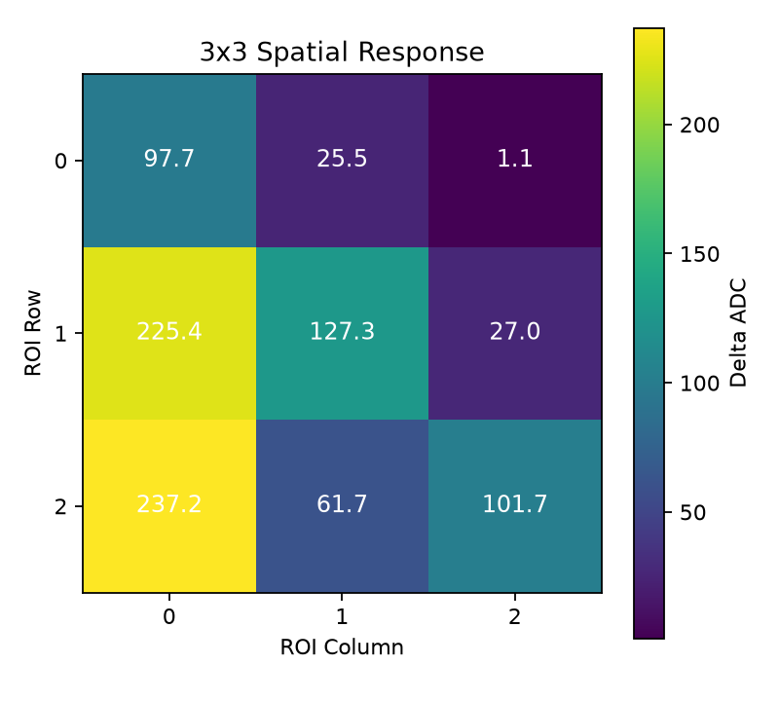
cali/results/spatial_response/20261023_173256_037635/spatial_response.png
