GuoJiashu/mech5720-2026-single_pixel_imaging/fourier_results/20261025_002849_105656/reconstruction_corrected/fourier_admm_results/admm_convergence.png

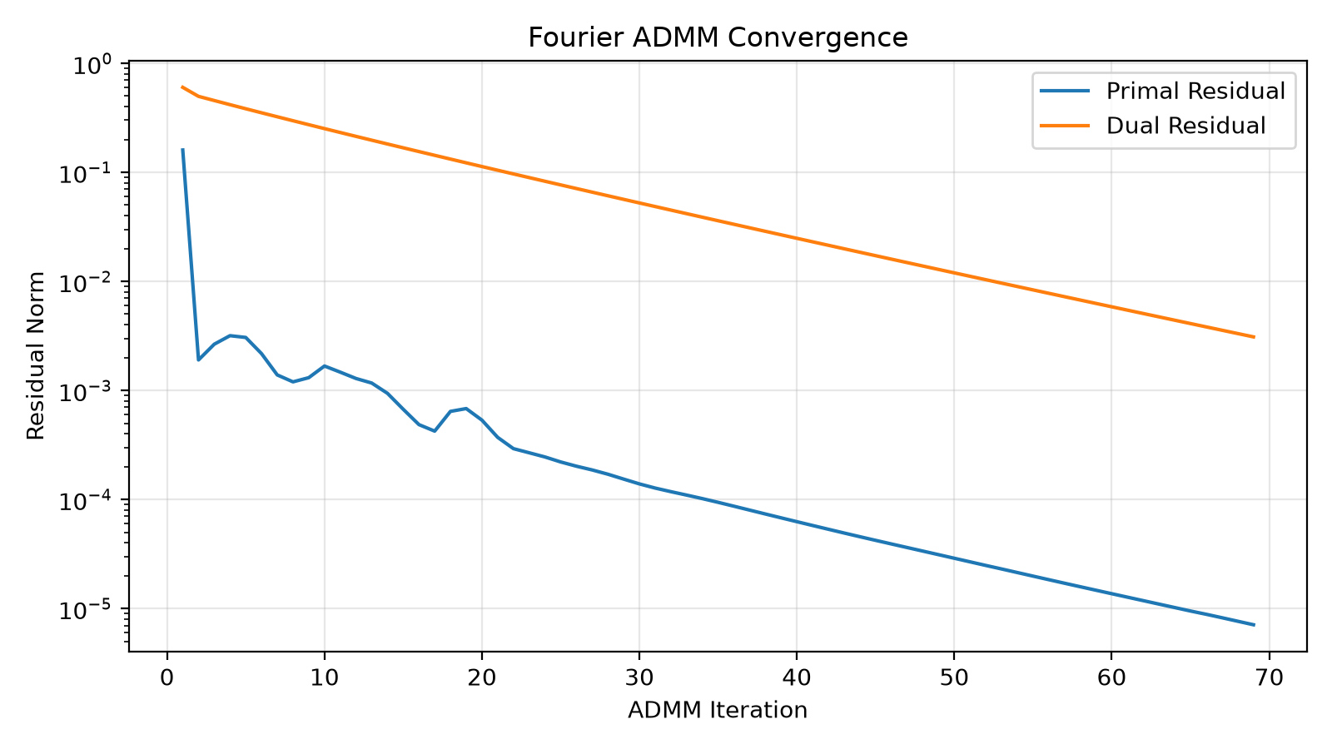
fourier_results/20261025_002849_105656/reconstruction_corrected/fourier_admm_results/admm_convergence.png
