GuoJiashu/mech5720-2026-single_pixel_imaging/hadamard_results/20261023_191716_313850/admm_results_256_256_sequency/admm_difference.png

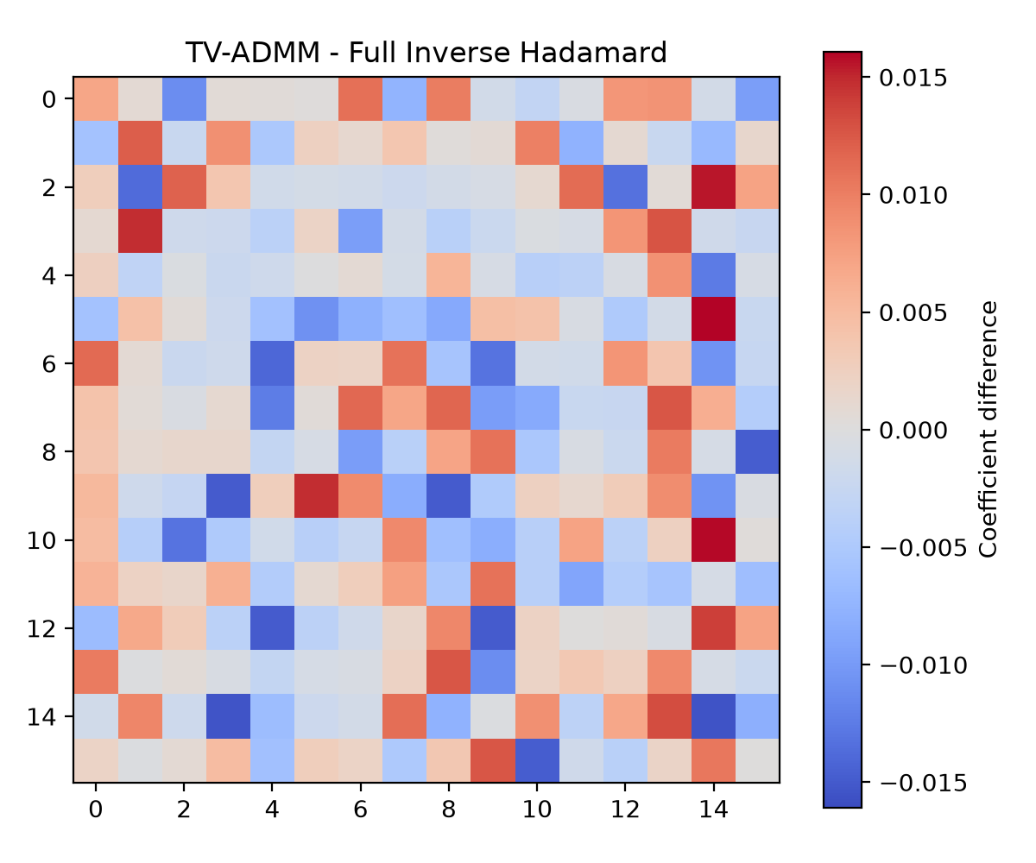
hadamard_results/20261023_191716_313850/admm_results_256_256_sequency/admm_difference.png
