GuoJiashu/mech5720-2026-single_pixel_imaging/hadamard_results/20261023_200537_930670/diagnostic_inverse_hadamard.png

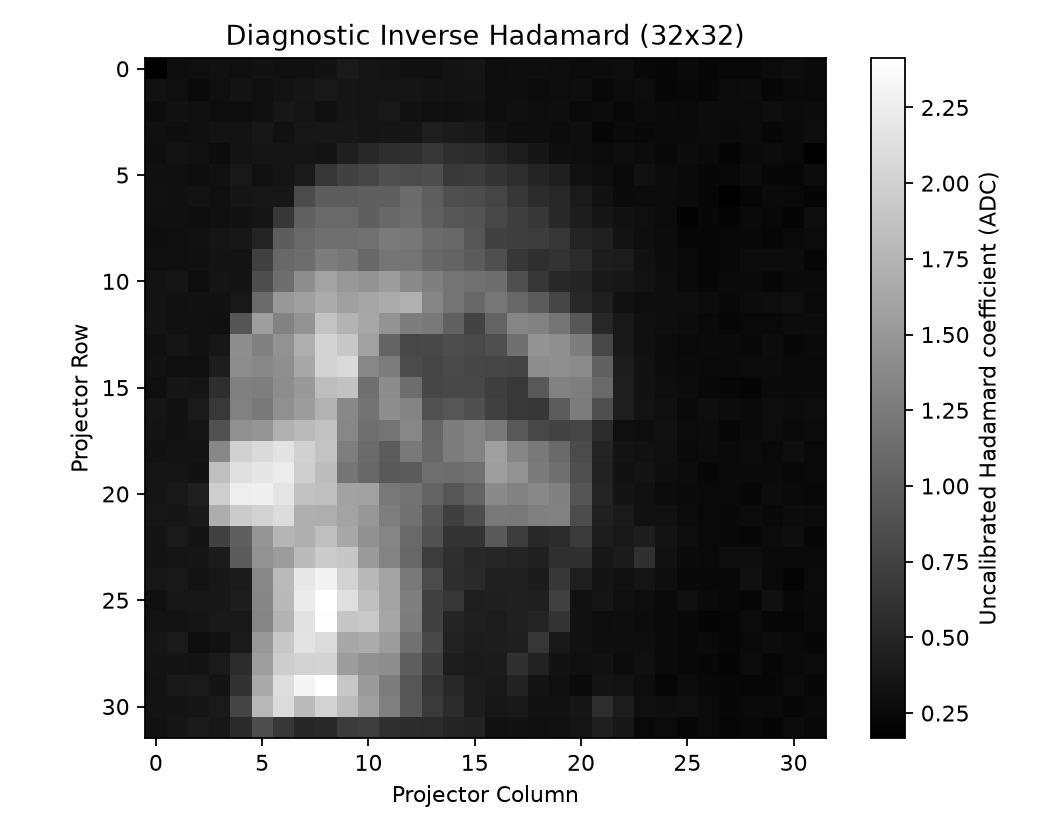
hadamard_results/20261023_200537_930670/diagnostic_inverse_hadamard.png
