GuoJiashu/mech5720-2026-single_pixel_imaging/hadamard_results/20261024_013607_094384/admm_results_4096_4096_sequency/admm_difference.png

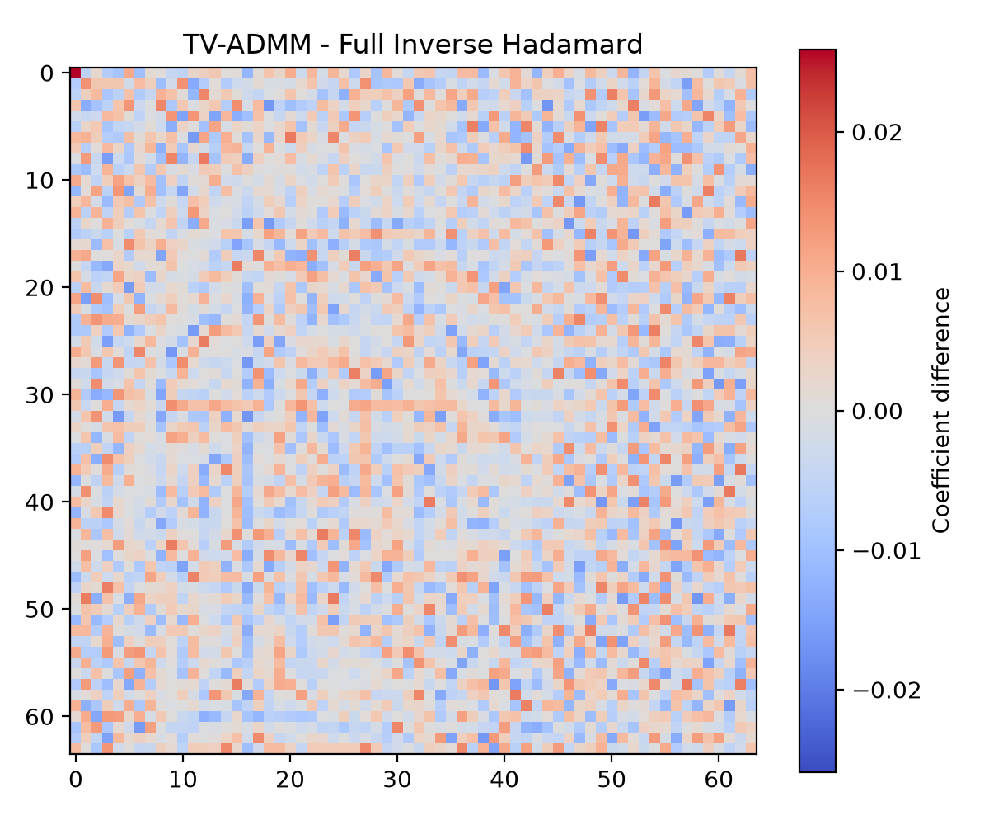
hadamard_results/20261024_013607_094384/admm_results_4096_4096_sequency/admm_difference.png
