GuoJiashu/mech5720-2026-single_pixel_imaging/hadamard_results/20261024_232029_873143/admm_results_256_1024_sequency/admm_comparison.png

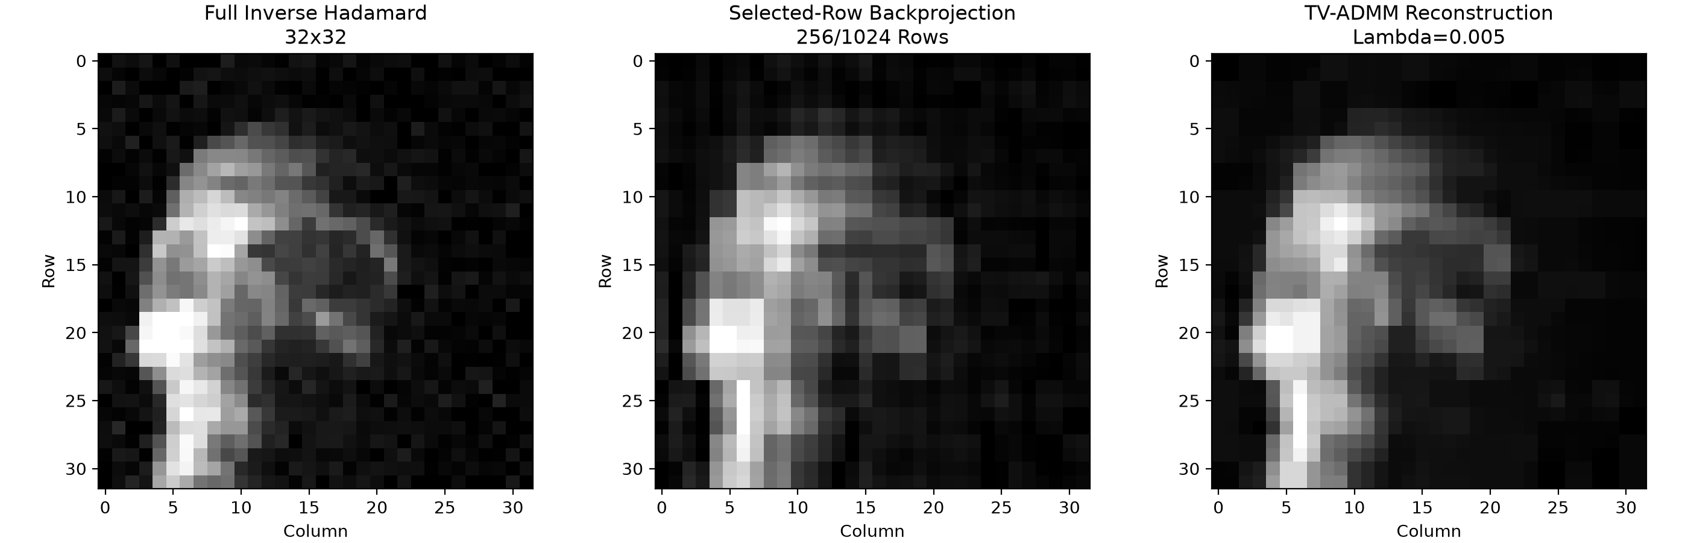
hadamard_results/20261024_232029_873143/admm_results_256_1024_sequency/admm_comparison.png
