GuoJiashu/mech5720-2026-single_pixel_imaging/hadamard_results/20261024_232029_873143/admm_results_1024_1024_sequency/admm_convergence.png

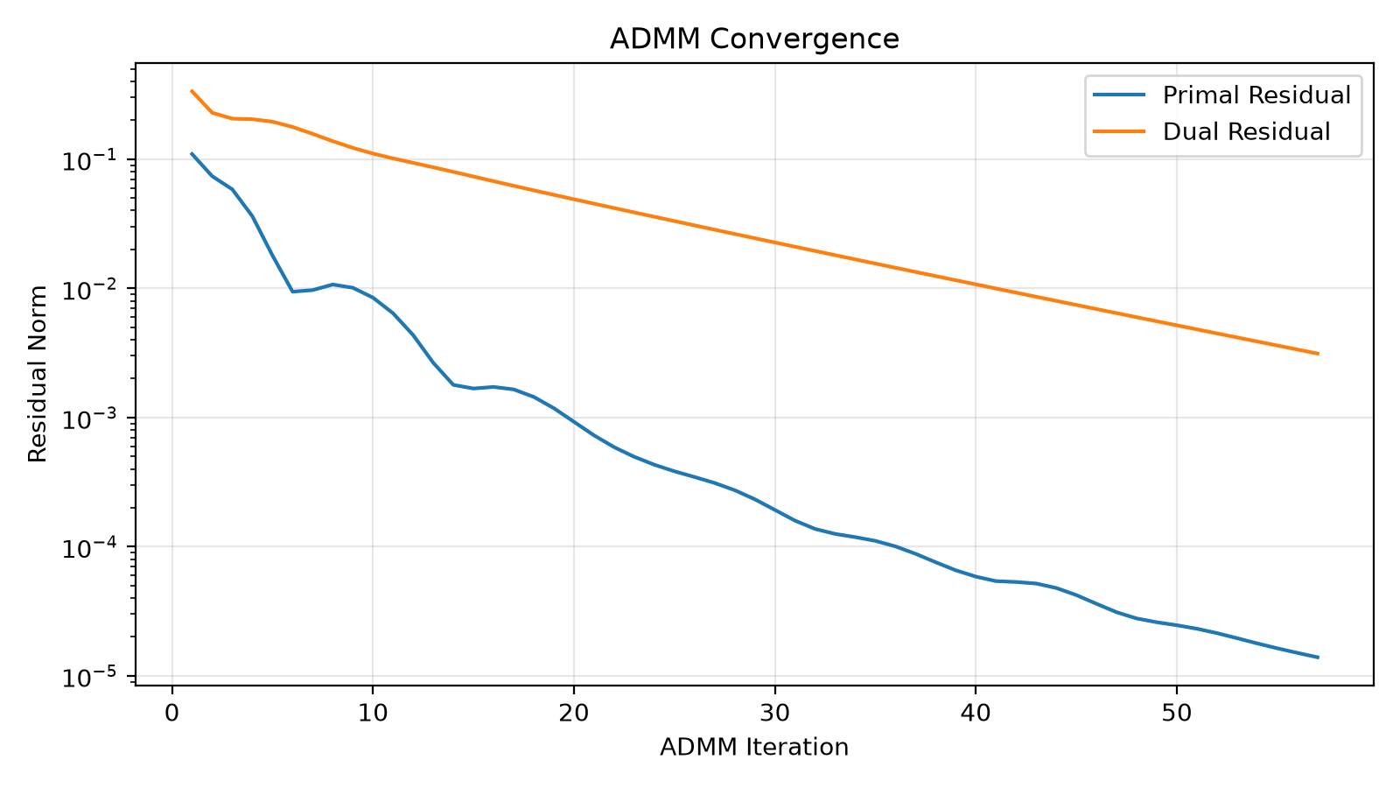
hadamard_results/20261024_232029_873143/admm_results_1024_1024_sequency/admm_convergence.png
