GuoJiashu/mech5720-2026-single_pixel_imaging/hadamard_results/20261025_041555_865482/admm_results_2048_4096_sequency/admm_difference.png

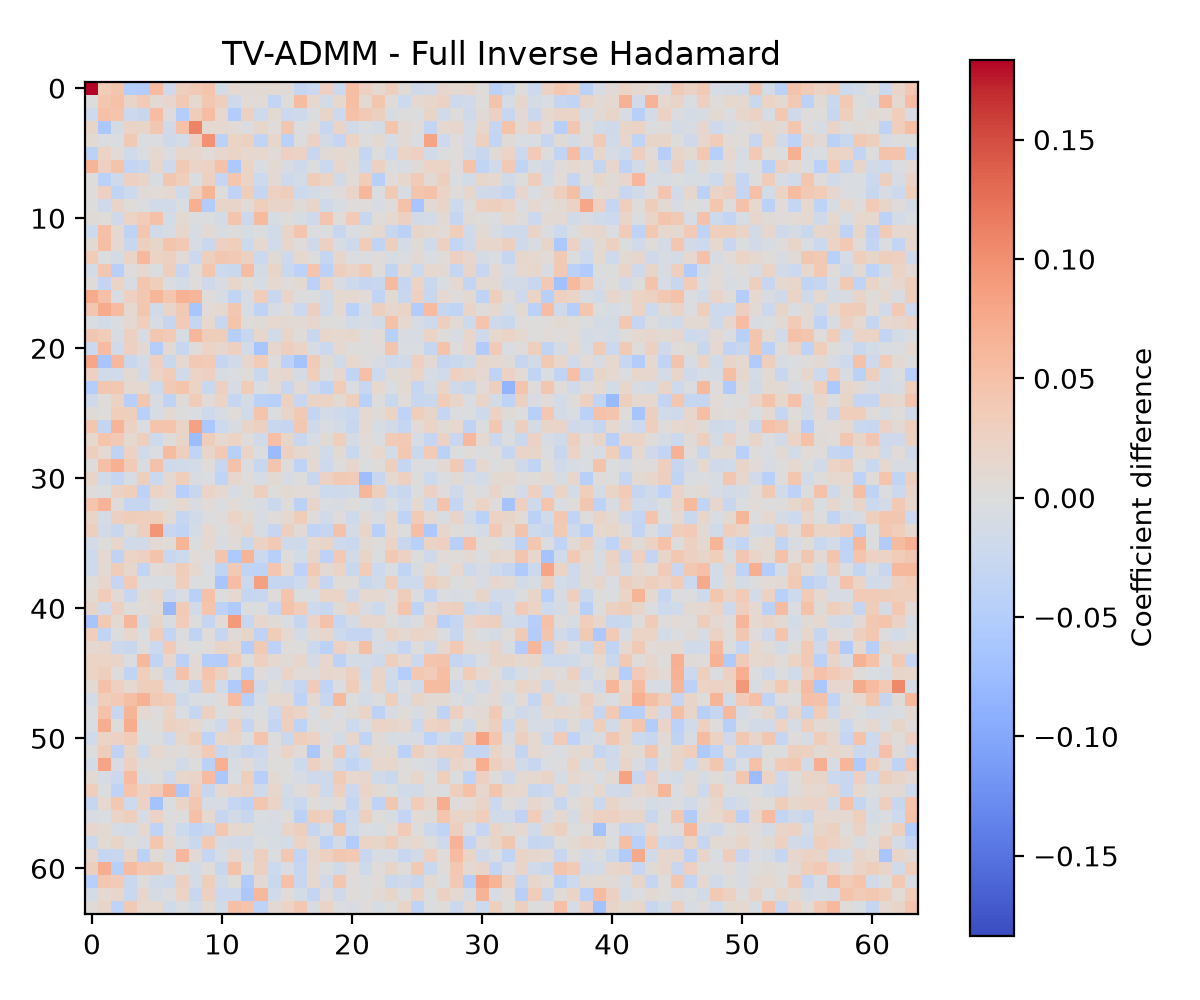
hadamard_results/20261025_041555_865482/admm_results_2048_4096_sequency/admm_difference.png
