GuoJiashu/mech5720-2026-single_pixel_imaging/imaging_2d/results/calibration/auto_ldr/20261028_223808_497898/time_series.png

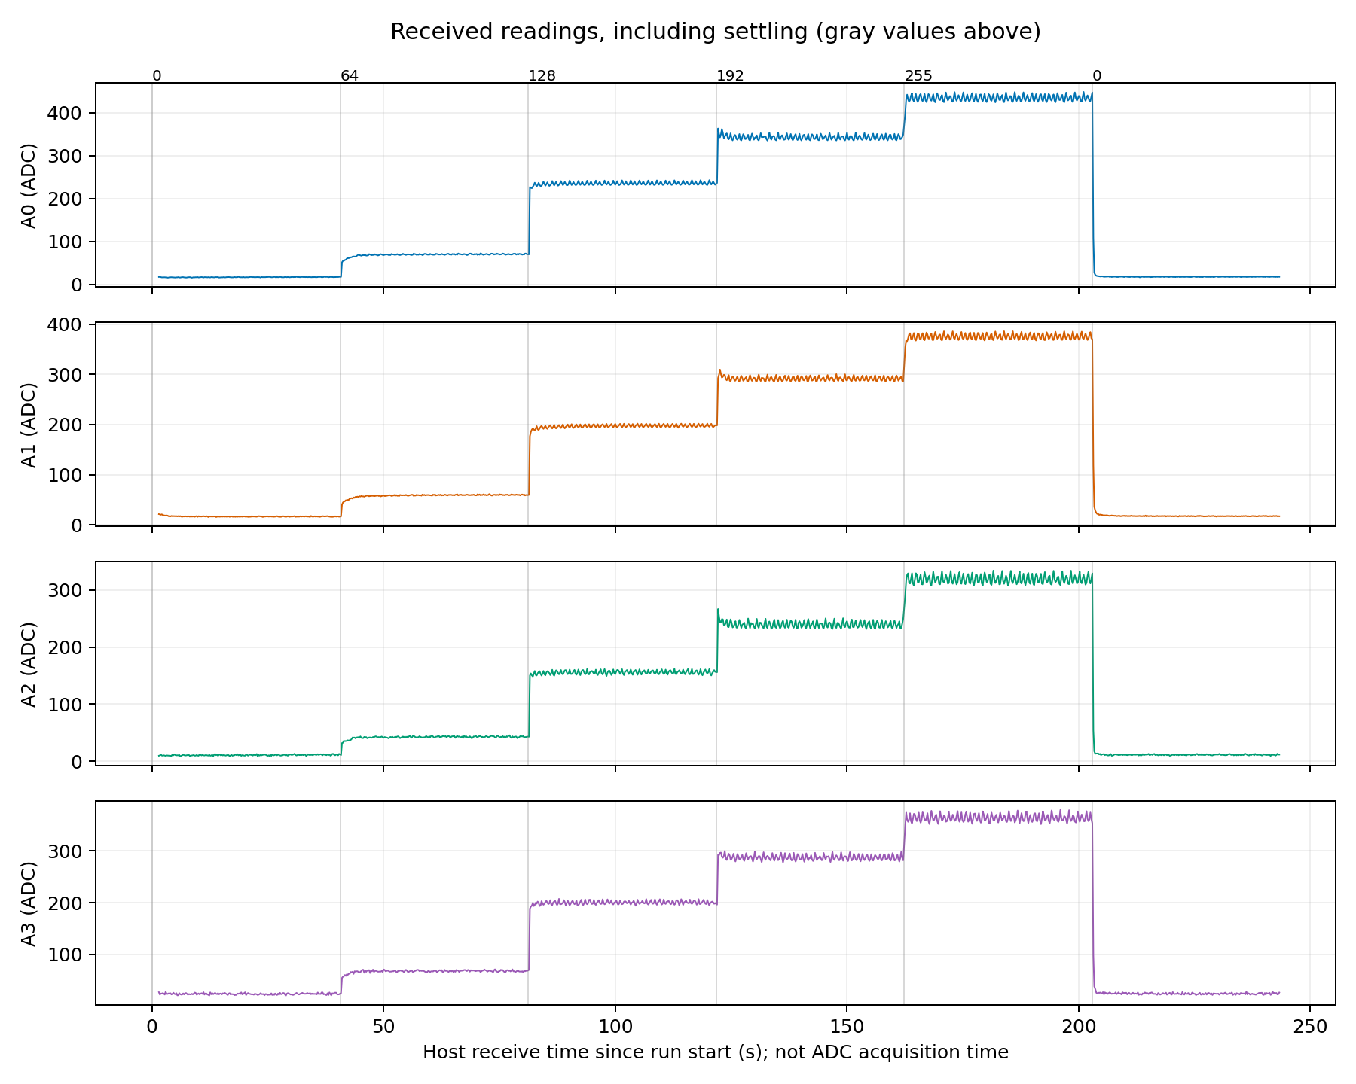
imaging_2d/results/calibration/auto_ldr/20261028_223808_497898/time_series.png
