GuoJiashu/mech5720-2026-single_pixel_imaging/imaging_2d/results/calibration/electrical/20261023_171741_487755/electrical_response.png

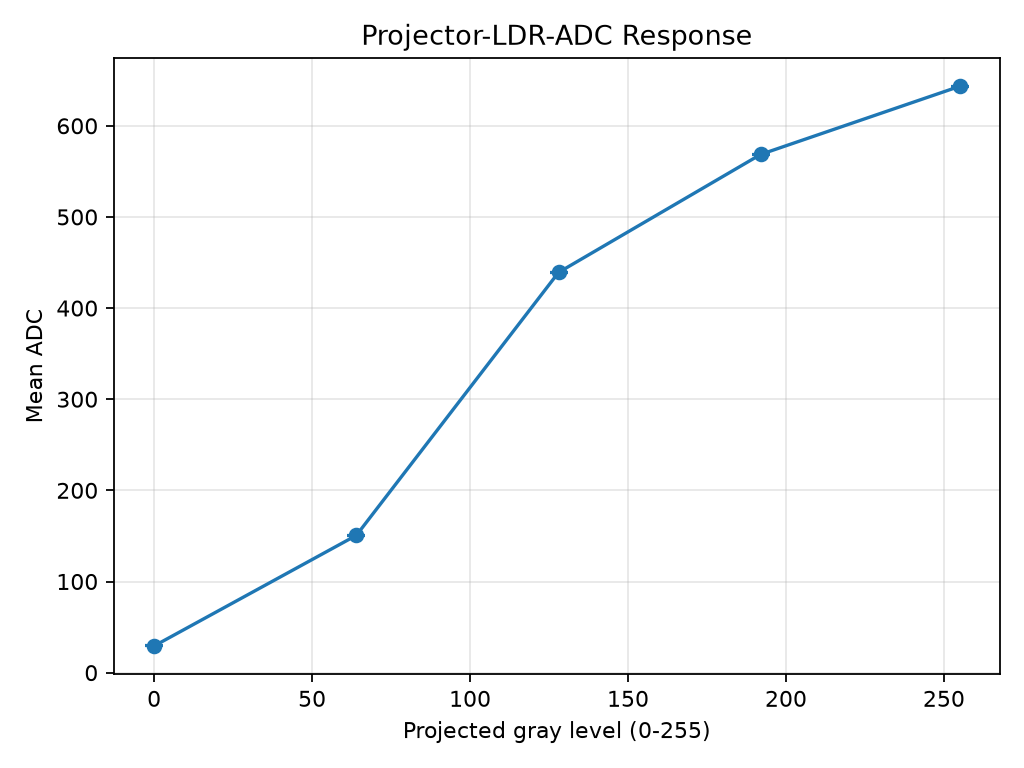
imaging_2d/results/calibration/electrical/20261023_171741_487755/electrical_response.png
