GuoJiashu/mech5720-2026-single_pixel_imaging/imaging_2d/results/calibration/spi_capture/20261029_105106_575314/time_series.png

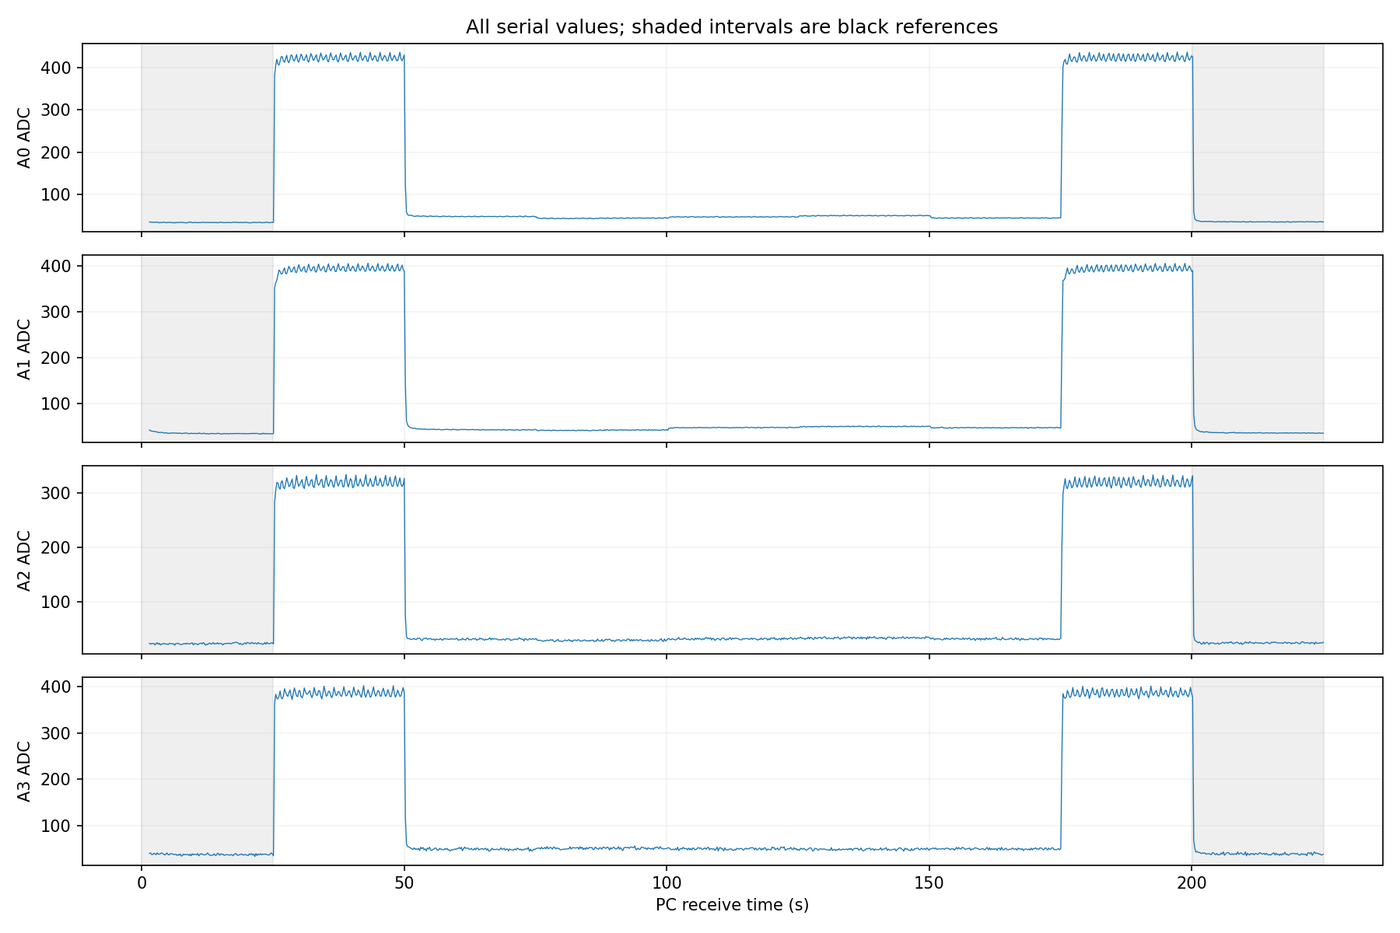
imaging_2d/results/calibration/spi_capture/20261029_105106_575314/time_series.png
