GuoJiashu/mech5720-2026-single_pixel_imaging/imaging_2d/results/calibration/temporal/ldr_temporal.png

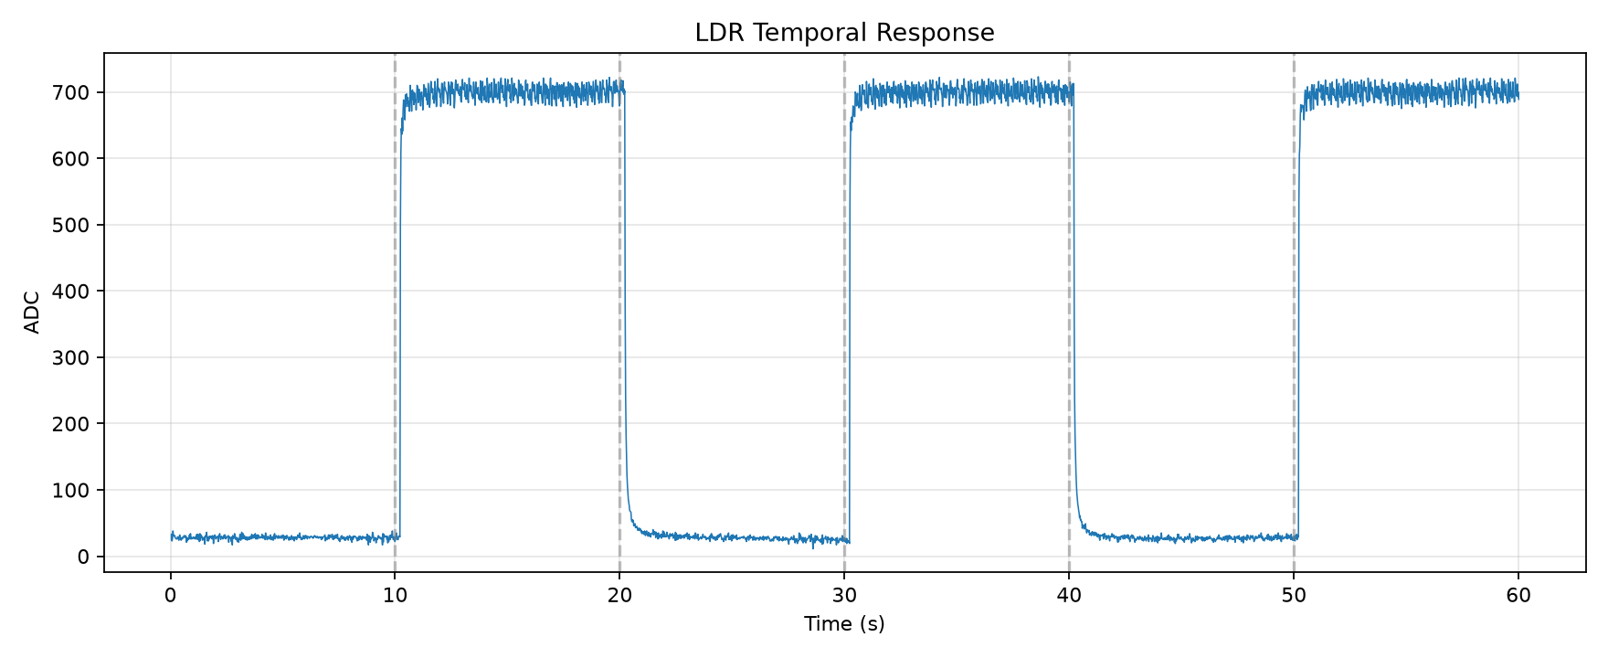
imaging_2d/results/calibration/temporal/ldr_temporal.png
