GuoJiashu/mech5720-2026-single_pixel_imaging/imaging_2d/results/fourier/20261023_213635_003130/reconstruction_corrected/fourier_admm_results/admm_comparison.png

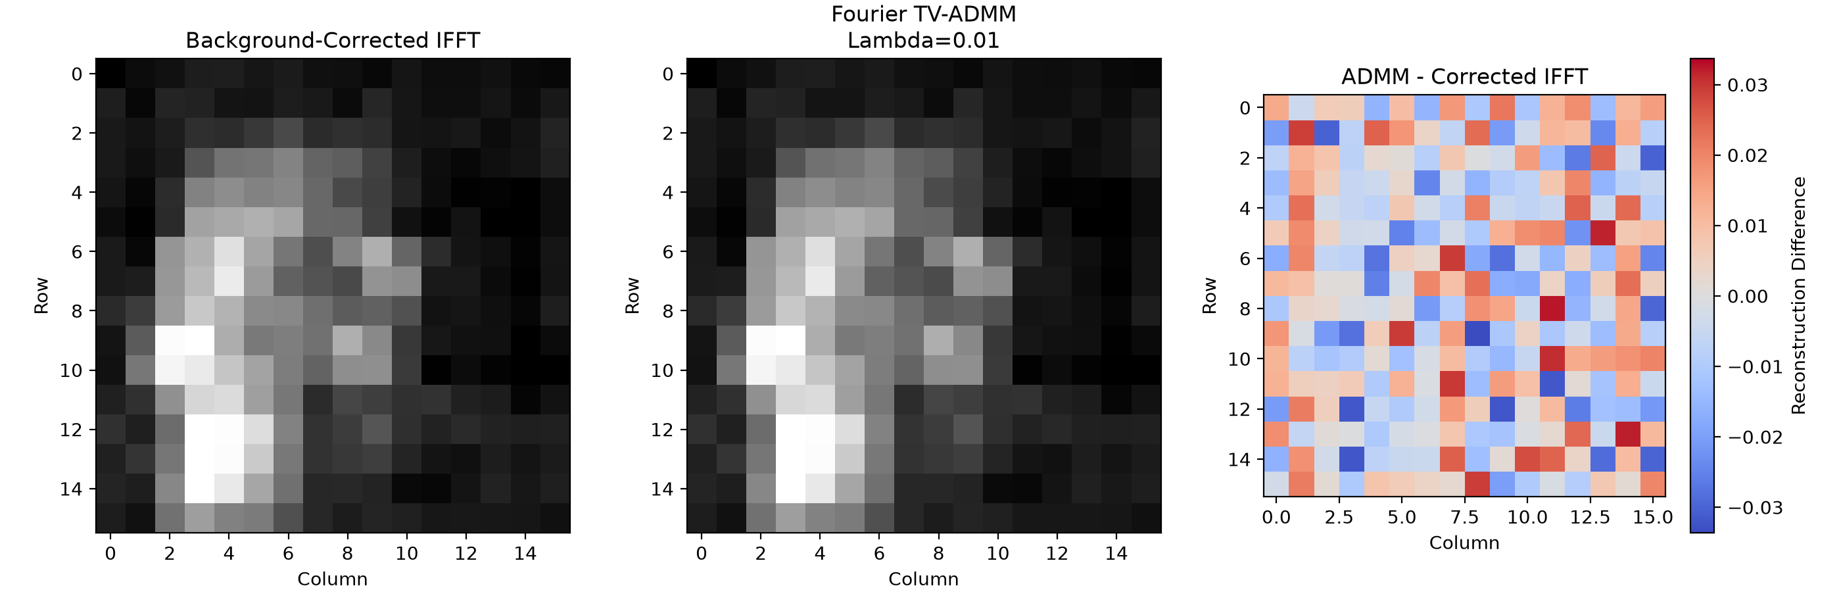
imaging_2d/results/fourier/20261023_213635_003130/reconstruction_corrected/fourier_admm_results/admm_comparison.png
