GuoJiashu/mech5720-2026-single_pixel_imaging/imaging_2d/results/fourier/20261024_052155_912611/reconstruction_corrected/fourier_admm_results/admm_convergence.png

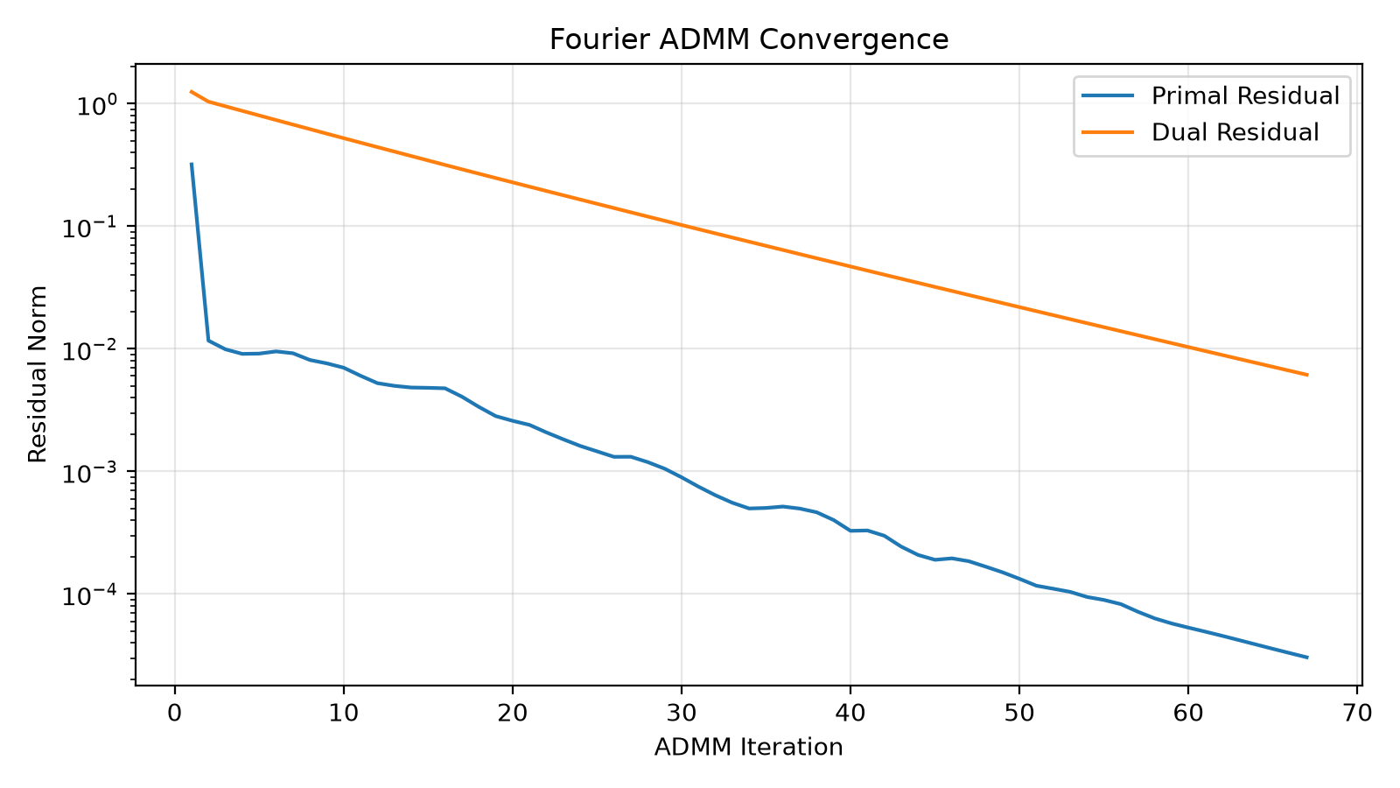
imaging_2d/results/fourier/20261024_052155_912611/reconstruction_corrected/fourier_admm_results/admm_convergence.png
