GuoJiashu/mech5720-2026-single_pixel_imaging/imaging_2d/results/fourier/20261025_002849_105656/fourier_preview.png

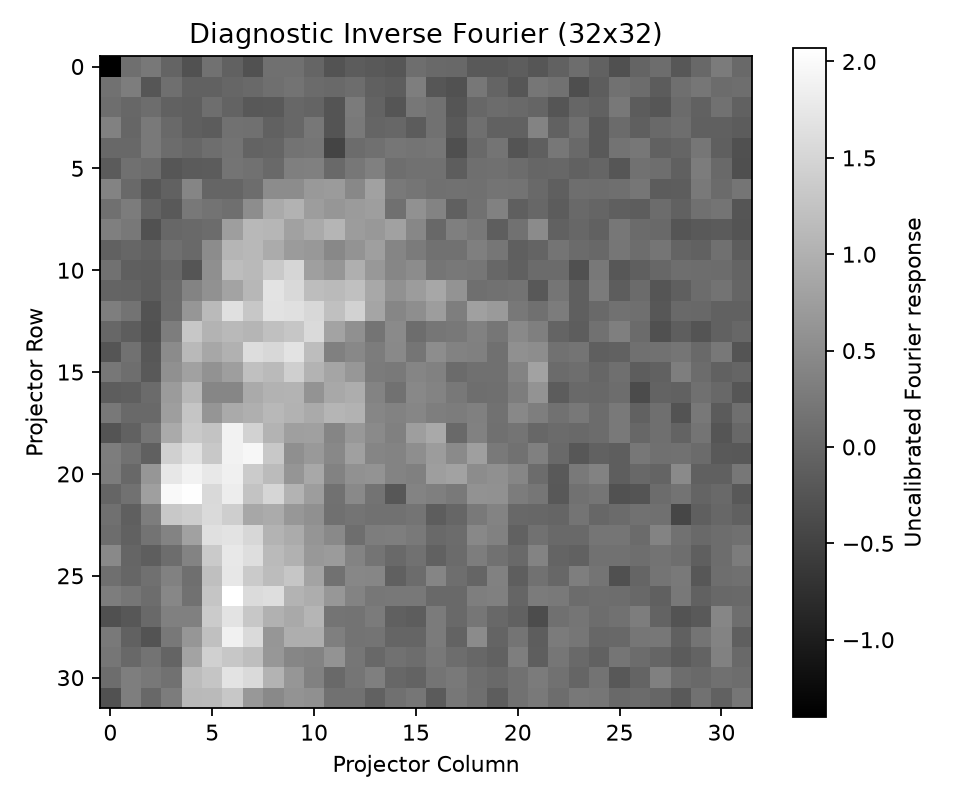
imaging_2d/results/fourier/20261025_002849_105656/fourier_preview.png
