GuoJiashu/mech5720-2026-single_pixel_imaging/imaging_2d/results/hadamard/20261023_191716_313850/admm_results_256_256_sequency/admm_convergence.png

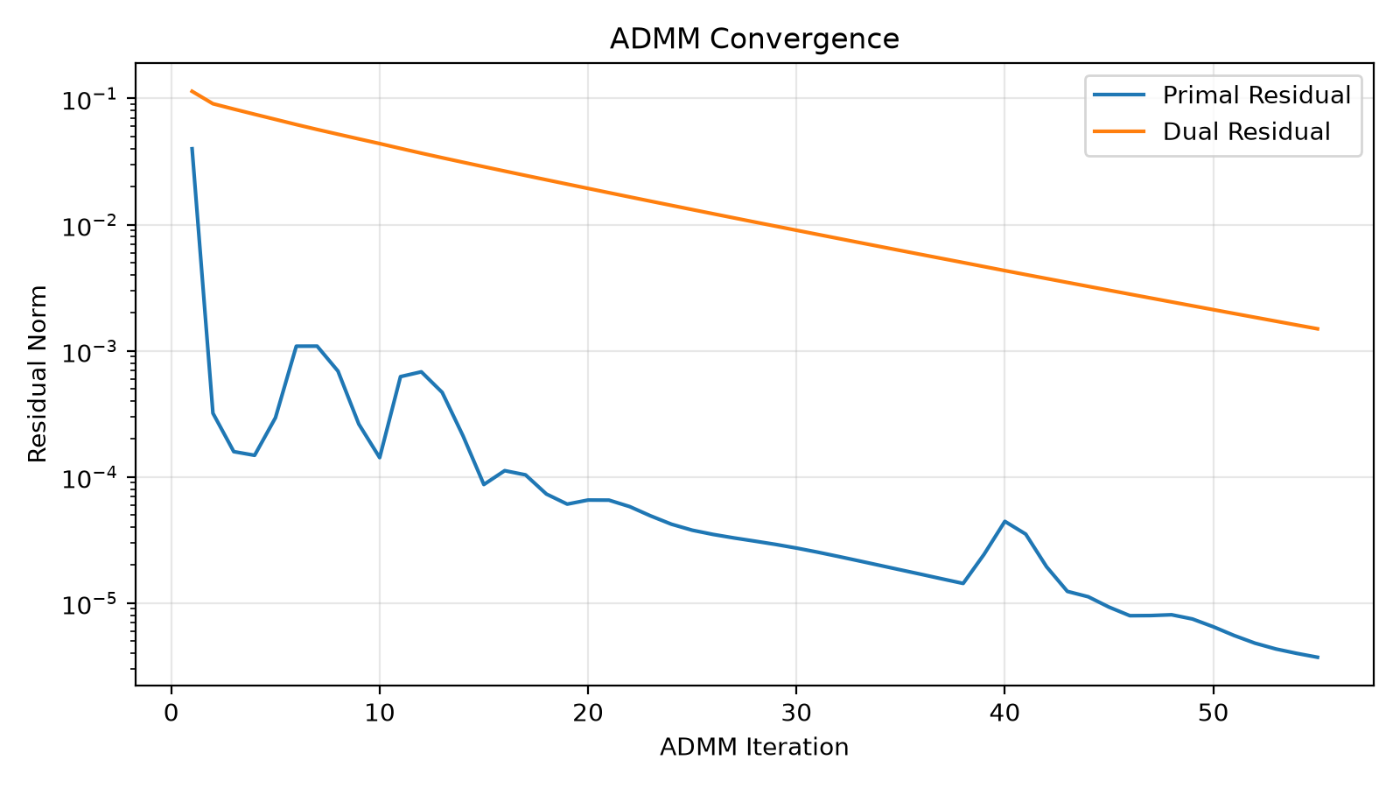
imaging_2d/results/hadamard/20261023_191716_313850/admm_results_256_256_sequency/admm_convergence.png
