GuoJiashu/mech5720-2026-single_pixel_imaging/imaging_2d/results/hadamard/20261023_200537_930670/admm_results_1024_1024_sequency/admm_convergence.png

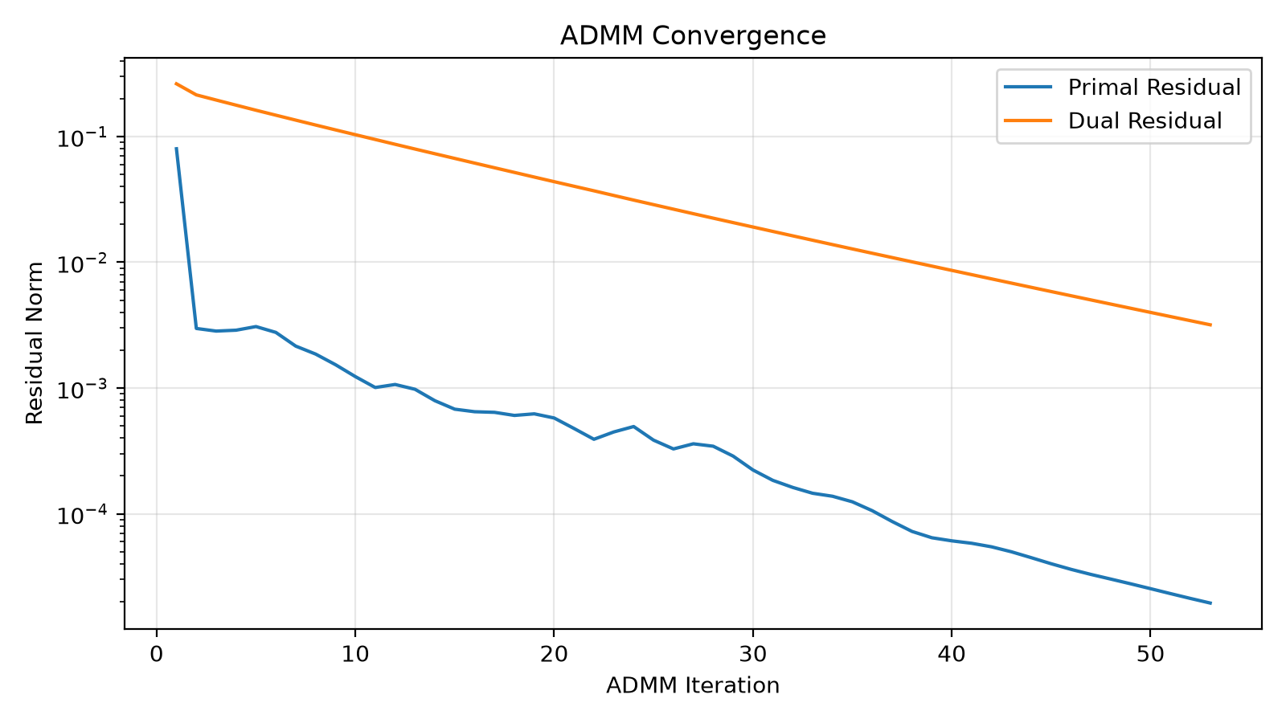
imaging_2d/results/hadamard/20261023_200537_930670/admm_results_1024_1024_sequency/admm_convergence.png
