GuoJiashu/mech5720-2026-single_pixel_imaging/imaging_2d/results/hadamard/20261024_013607_094384/admm_results_3072_4096_sequency/admm_difference.png

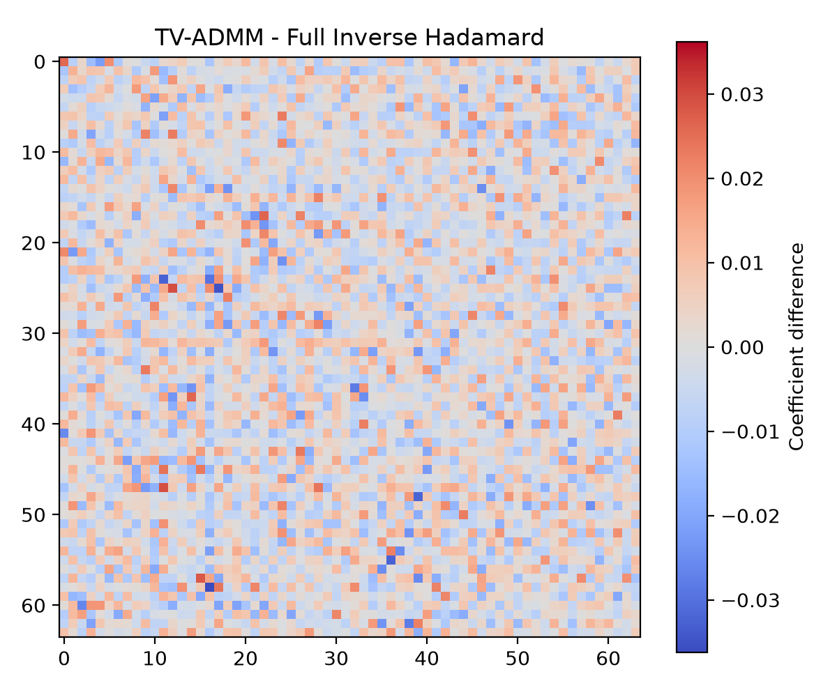
imaging_2d/results/hadamard/20261024_013607_094384/admm_results_3072_4096_sequency/admm_difference.png
