GuoJiashu/mech5720-2026-single_pixel_imaging/imaging_2d/results/hadamard/20261024_013607_094384/admm_results_4096_4096_sequency/admm_convergence.png

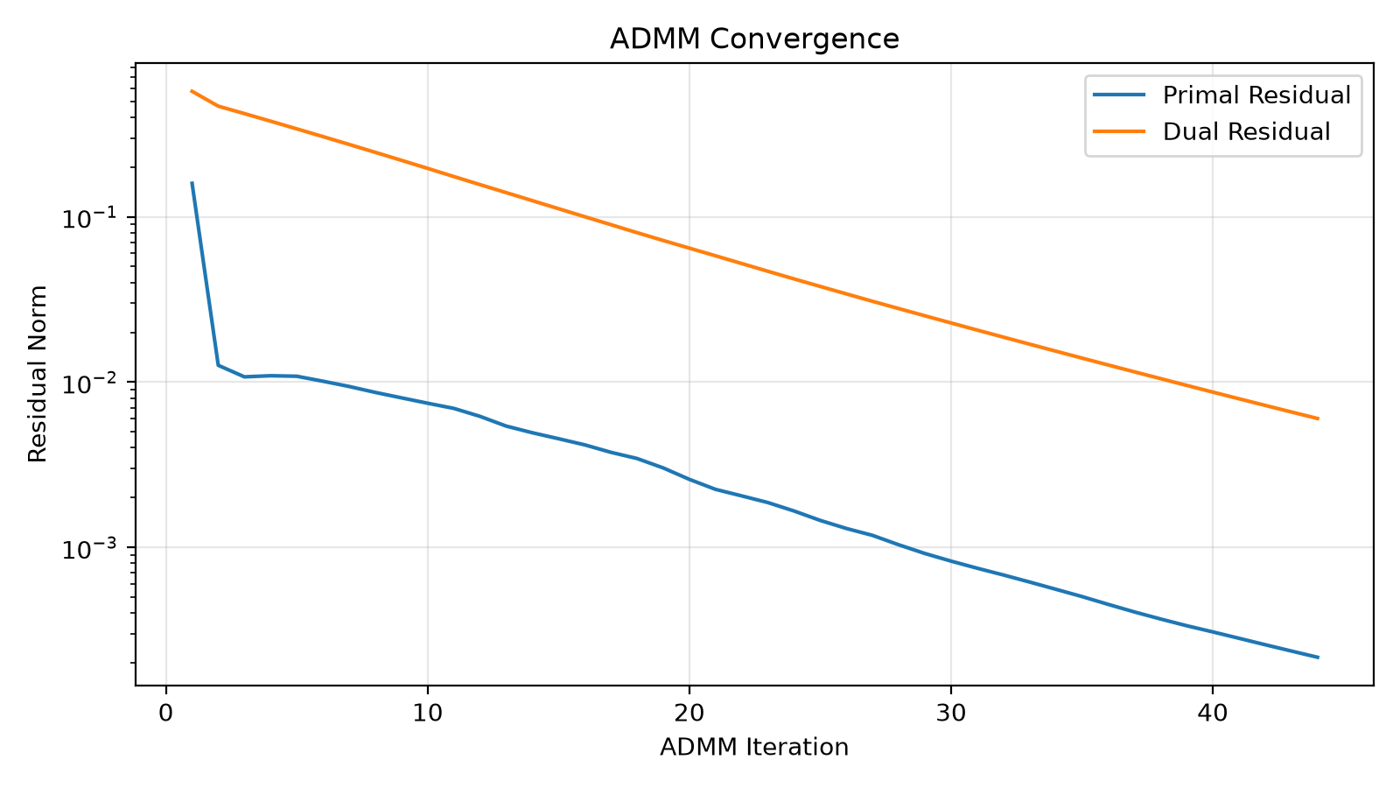
imaging_2d/results/hadamard/20261024_013607_094384/admm_results_4096_4096_sequency/admm_convergence.png
