GuoJiashu/mech5720-2026-single_pixel_imaging/imaging_2d/results/hadamard/20261024_220710_549725/admm_results_256_256_sequency/admm_difference.png

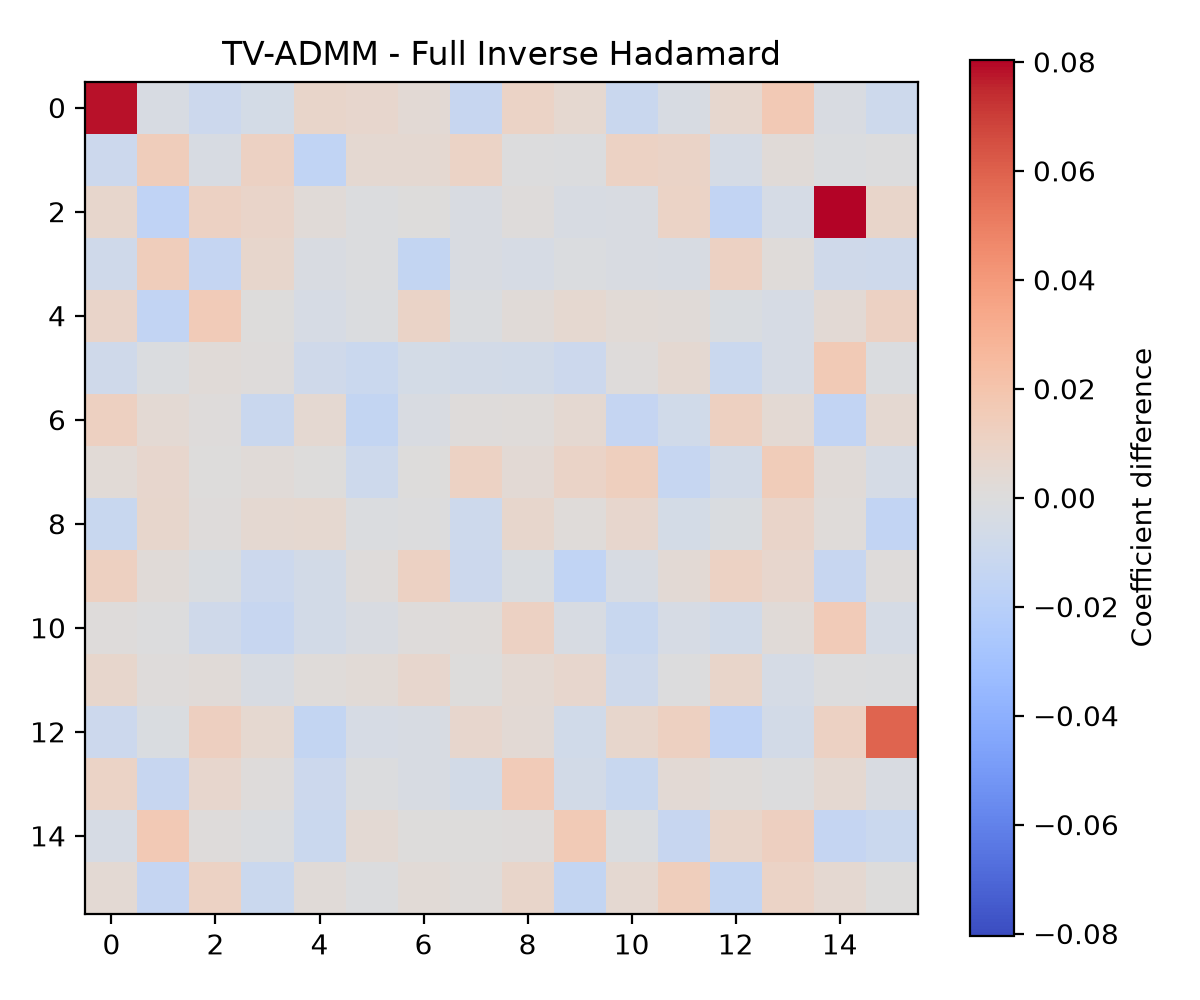
imaging_2d/results/hadamard/20261024_220710_549725/admm_results_256_256_sequency/admm_difference.png
