GuoJiashu/mech5720-2026-single_pixel_imaging/imaging_2d/results/hadamard/20261024_232029_873143/admm_results_256_1024_sequency/admm_convergence.png

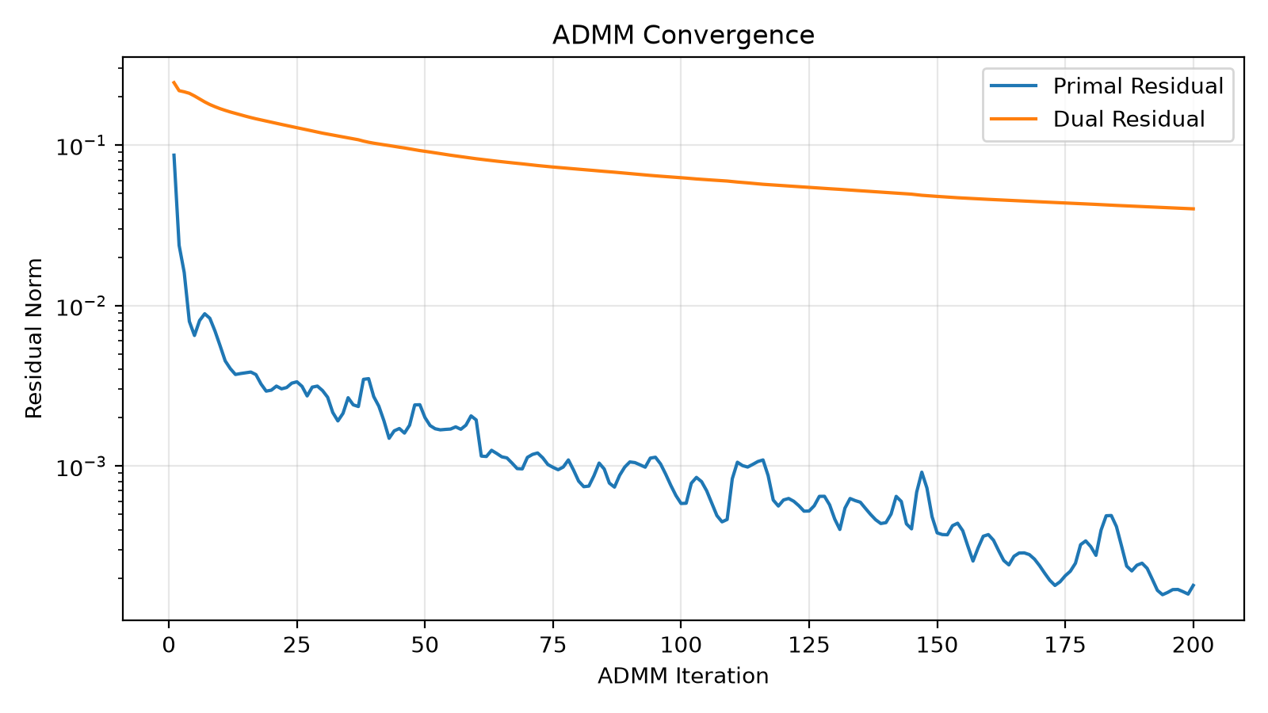
imaging_2d/results/hadamard/20261024_232029_873143/admm_results_256_1024_sequency/admm_convergence.png
