GuoJiashu/mech5720-2026-single_pixel_imaging/imaging_2d/results/hadamard/20261025_041555_865482/admm_results_3072_4096_sequency/admm_convergence.png

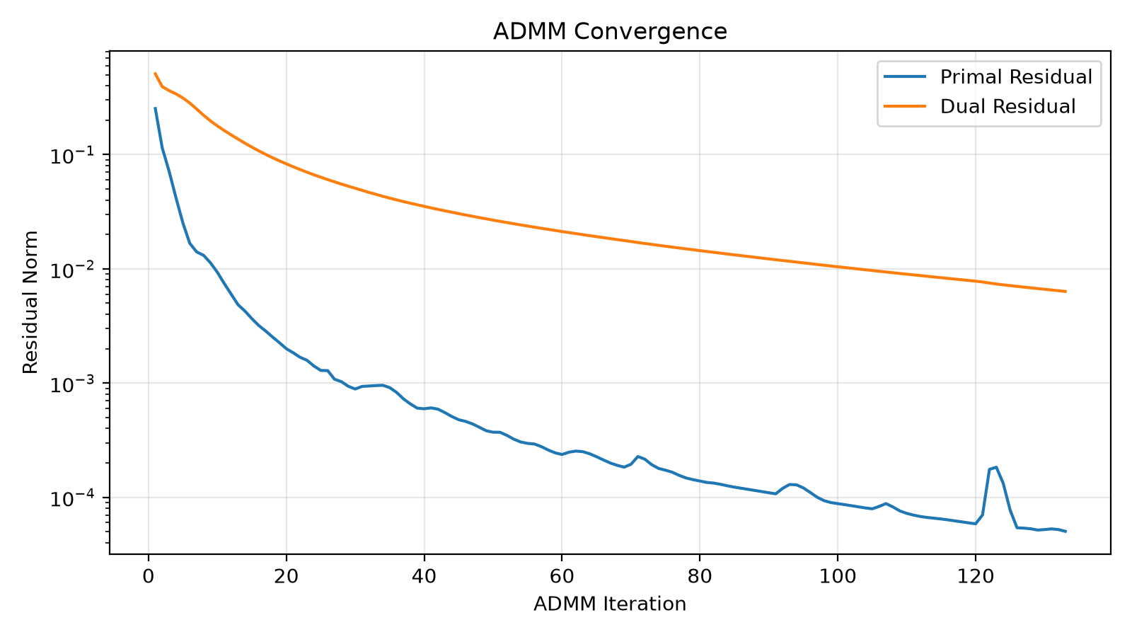
imaging_2d/results/hadamard/20261025_041555_865482/admm_results_3072_4096_sequency/admm_convergence.png
