GuoJiashu/mech5720-2026-single_pixel_imaging/imaging_2d/results/hadamard/20261025_041555_865482/diagnostic_inverse_hadamard.png

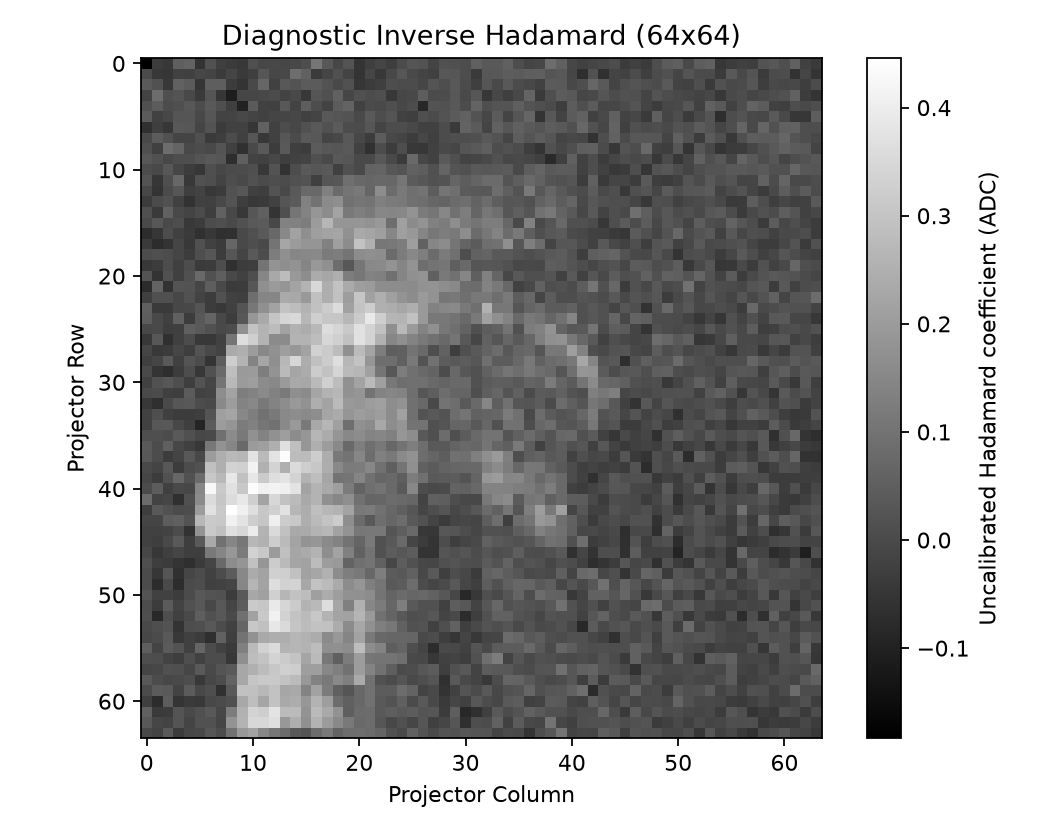
imaging_2d/results/hadamard/20261025_041555_865482/diagnostic_inverse_hadamard.png
