GuoJiashu/mech5720-2026-single_pixel_imaging/imaging_2d/results/point_scan/20261023_232207_754080/point_scan_preview.png

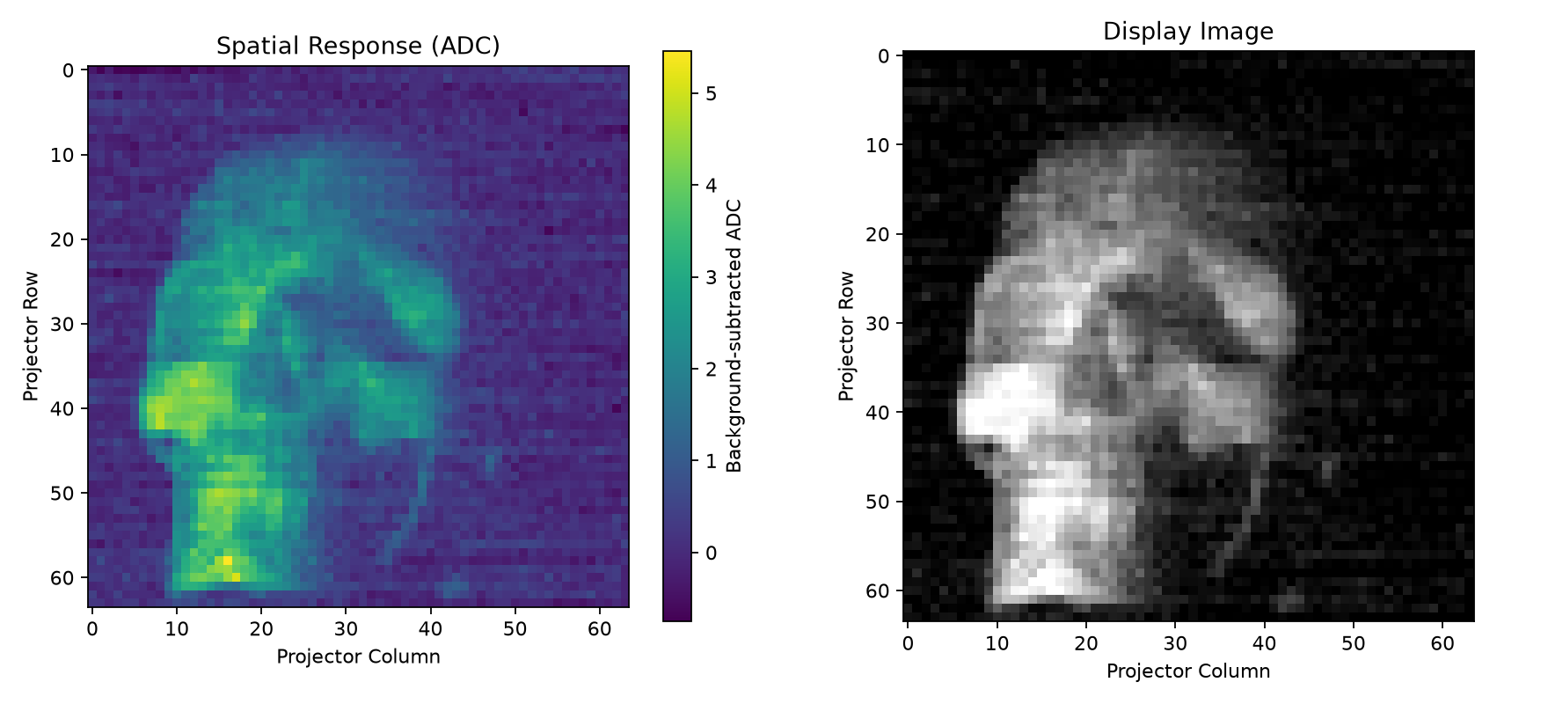
imaging_2d/results/point_scan/20261023_232207_754080/point_scan_preview.png
