GuoJiashu/mech5720-2026-single_pixel_imaging/imaging_2d/results/point_scan/20261024_215743_952485/admm_results/admm_convergence.png

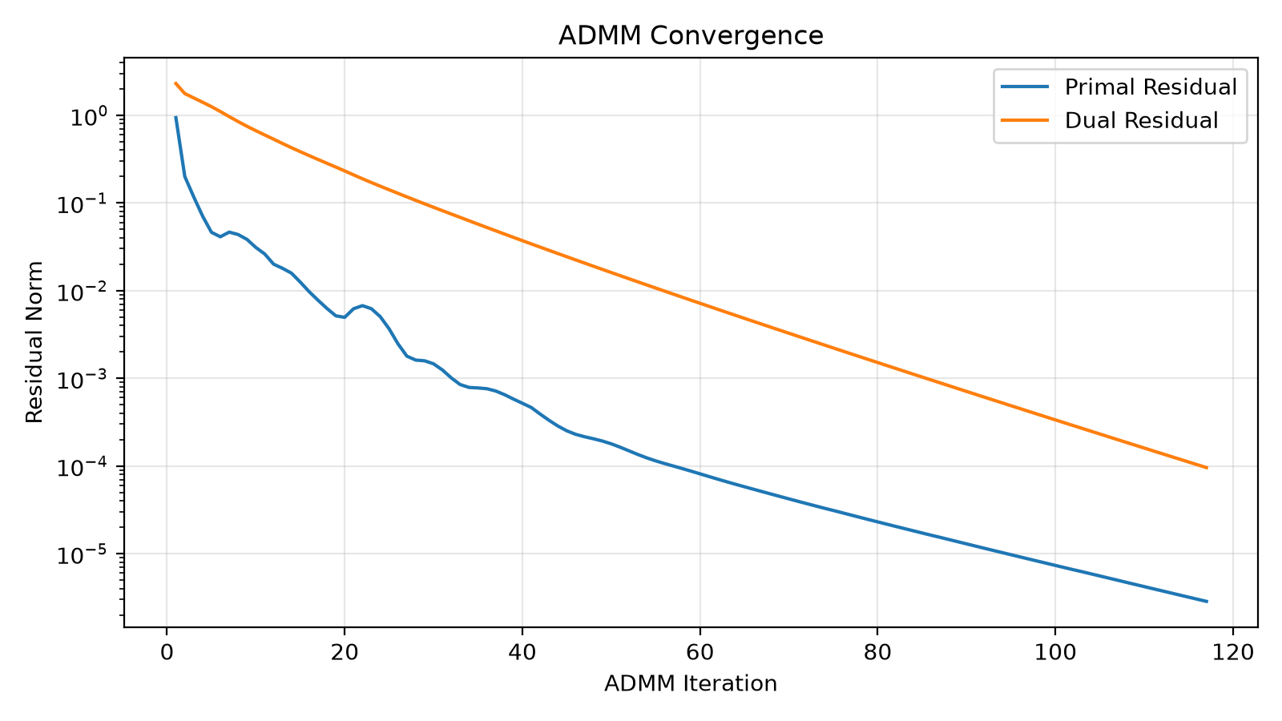
imaging_2d/results/point_scan/20261024_215743_952485/admm_results/admm_convergence.png
