GuoJiashu/mech5720-2026-single_pixel_imaging/imaging_2d/results/point_scan/20261024_223747_962874/admm_results/admm_comparison.png

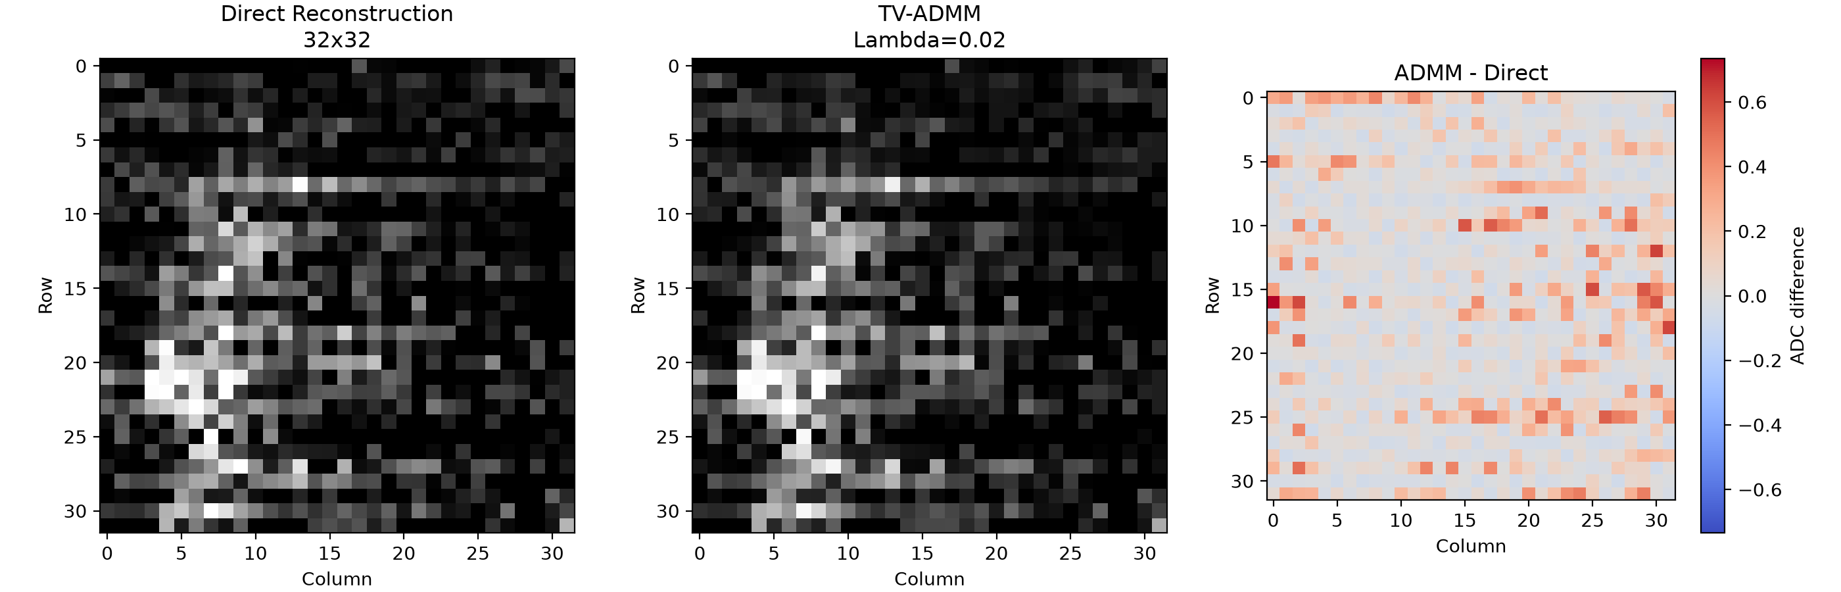
imaging_2d/results/point_scan/20261024_223747_962874/admm_results/admm_comparison.png
