GuoJiashu/mech5720-2026-single_pixel_imaging/imaging_2d/results/report_results/compressive_imaging/nlos_hadamard_comparison.png

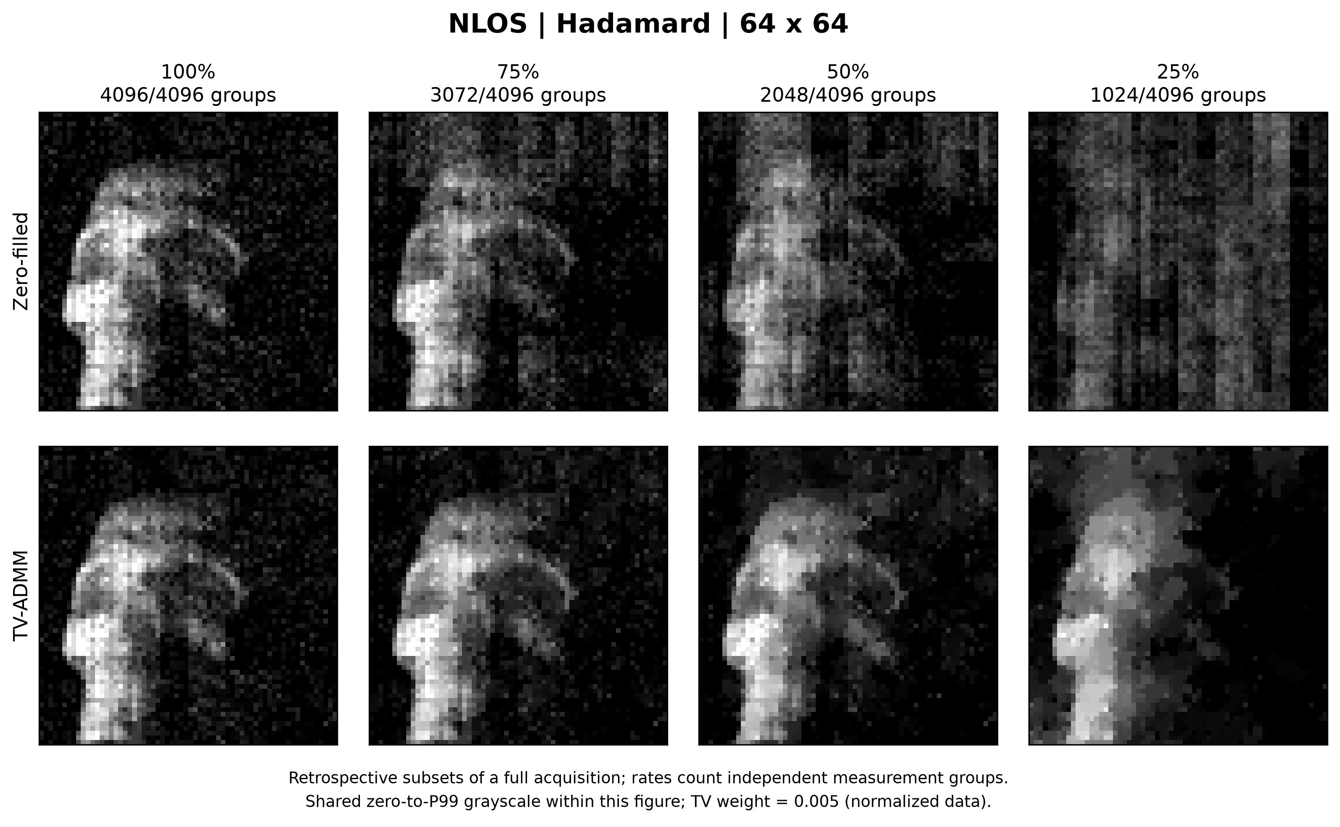
imaging_2d/results/report_results/compressive_imaging/nlos_hadamard_comparison.png
