GuoJiashu/mech5720-2026-single_pixel_imaging/imaging_2d/results/report_results/compressive_sensing_ssim.png

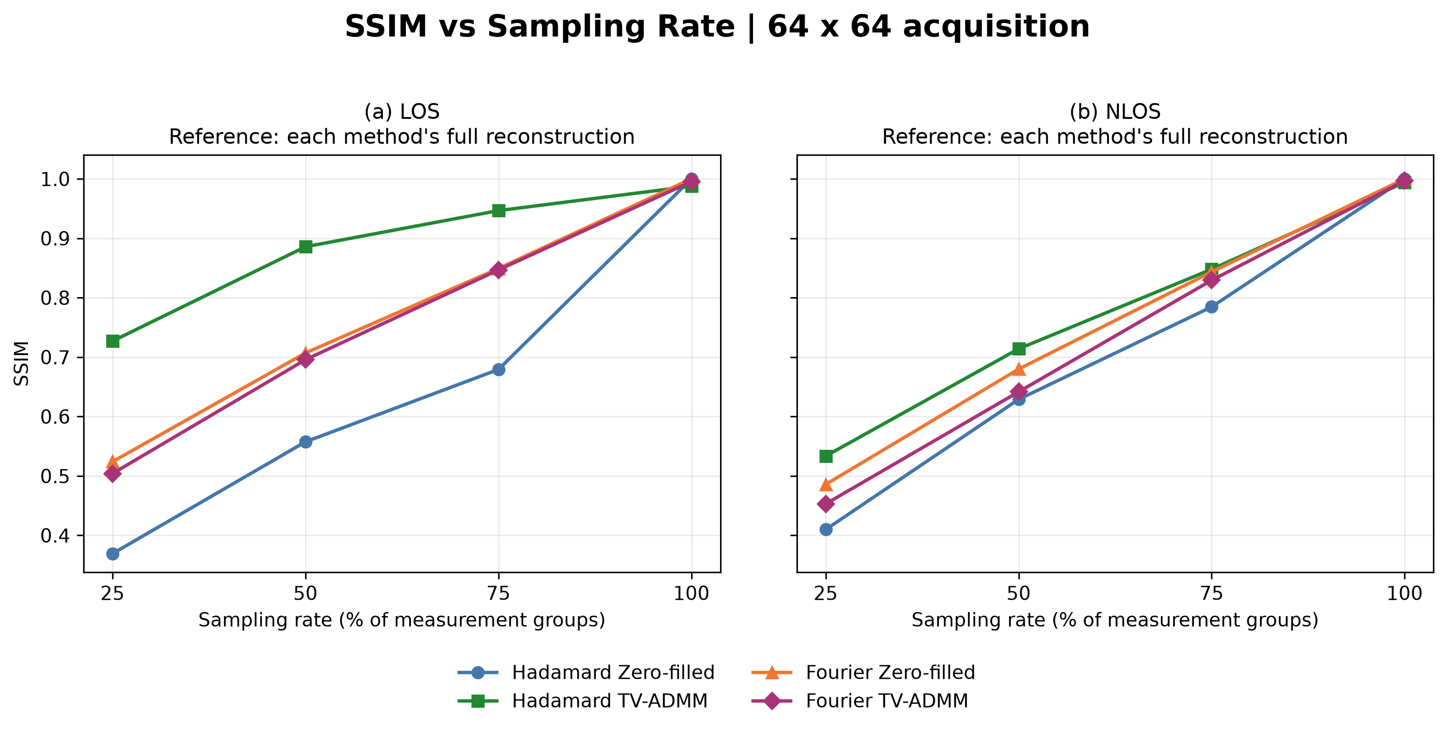
imaging_2d/results/report_results/compressive_sensing_ssim.png
