GuoJiashu/mech5720-2026-single_pixel_imaging/imaging_3d/results/calibration/hadamard_timing/2026-11-07_18-02-21/07_plot_hadamard_timing/hadamard_timing_comparison.png

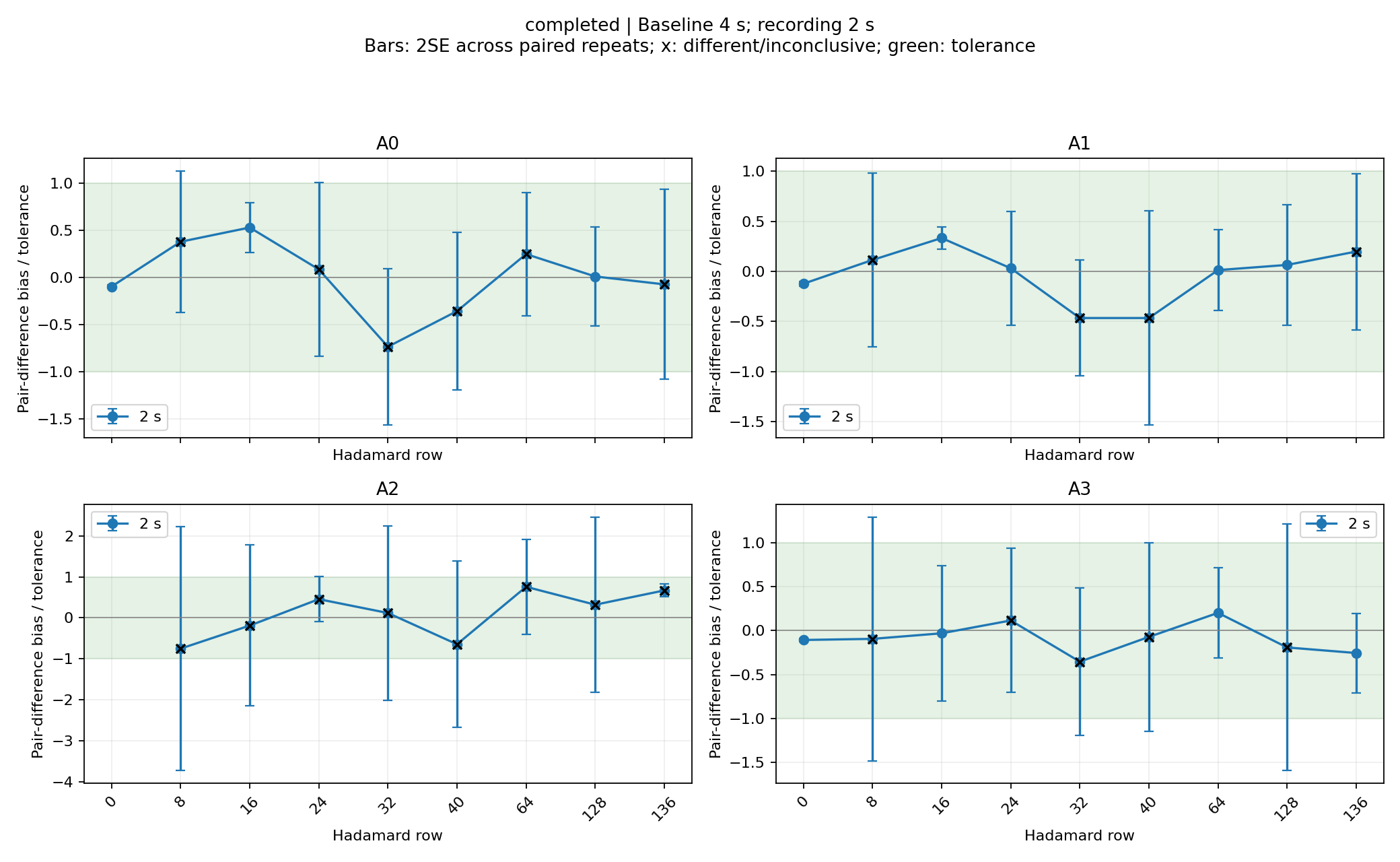
imaging_3d/results/calibration/hadamard_timing/2026-11-07_18-02-21/07_plot_hadamard_timing/hadamard_timing_comparison.png
