GuoJiashu/mech5720-2026-single_pixel_imaging/imaging_3d/results/calibration/nonlinearity/20261029_181116_817272/20261029_183422_204137/time_series.png

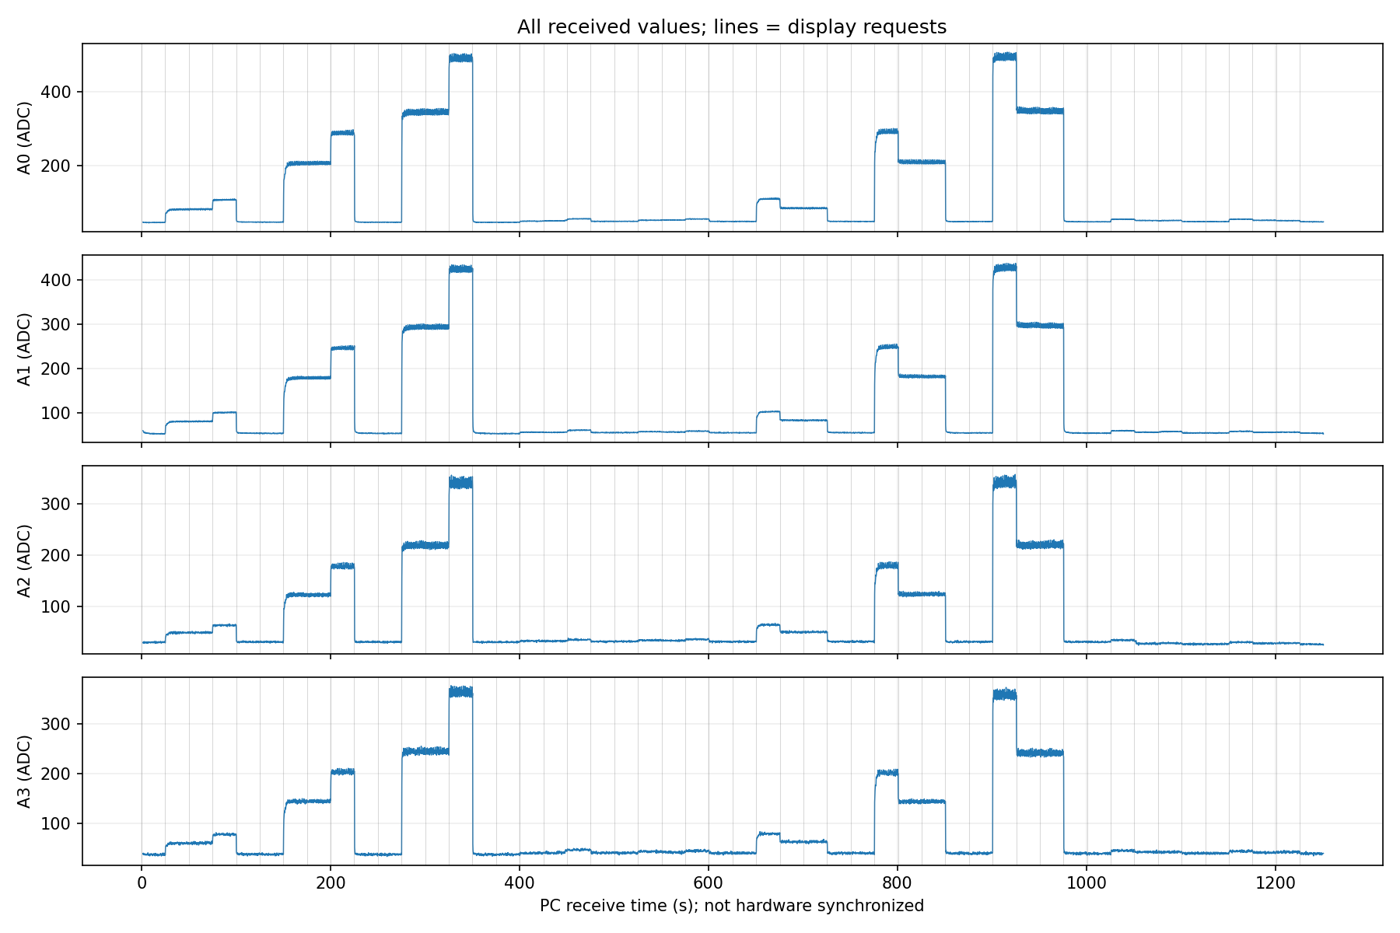
imaging_3d/results/calibration/nonlinearity/20261029_181116_817272/20261029_183422_204137/time_series.png
