GuoJiashu/mech5720-2026-single_pixel_imaging/imaging_3d/results/comparisons/oct30_nov07_nov08_baseline/10_summarize_baseline_runs/full_front_comparison.png

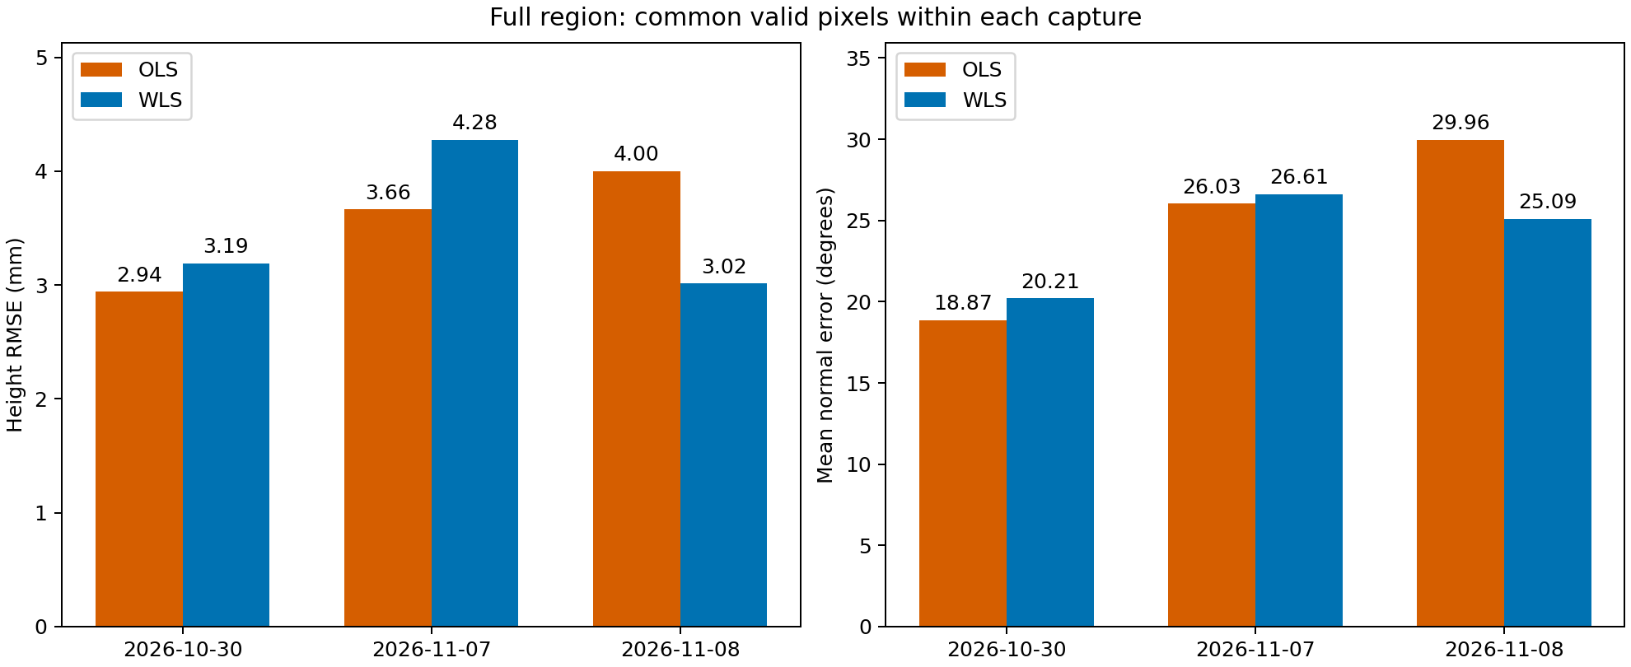
imaging_3d/results/comparisons/oct30_nov07_nov08_baseline/10_summarize_baseline_runs/full_front_comparison.png
