GuoJiashu/mech5720-2026-single_pixel_imaging/imaging_3d/results/hadamard_capture/2026-10-30_01-16-26/08_evaluate_sphere/height_error_distribution.png

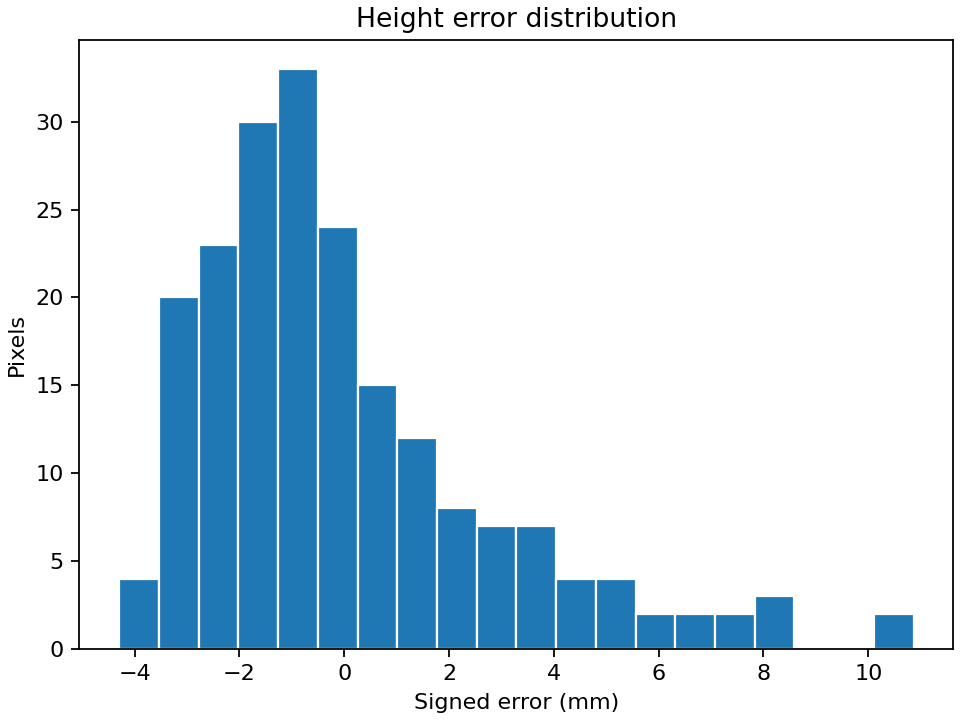
imaging_3d/results/hadamard_capture/2026-10-30_01-16-26/08_evaluate_sphere/height_error_distribution.png
