GuoJiashu/mech5720-2026-single_pixel_imaging/imaging_3d/results/hadamard_capture/2026-11-07_12-58-59/04_plot_spi_capture_8x8/time_series.png

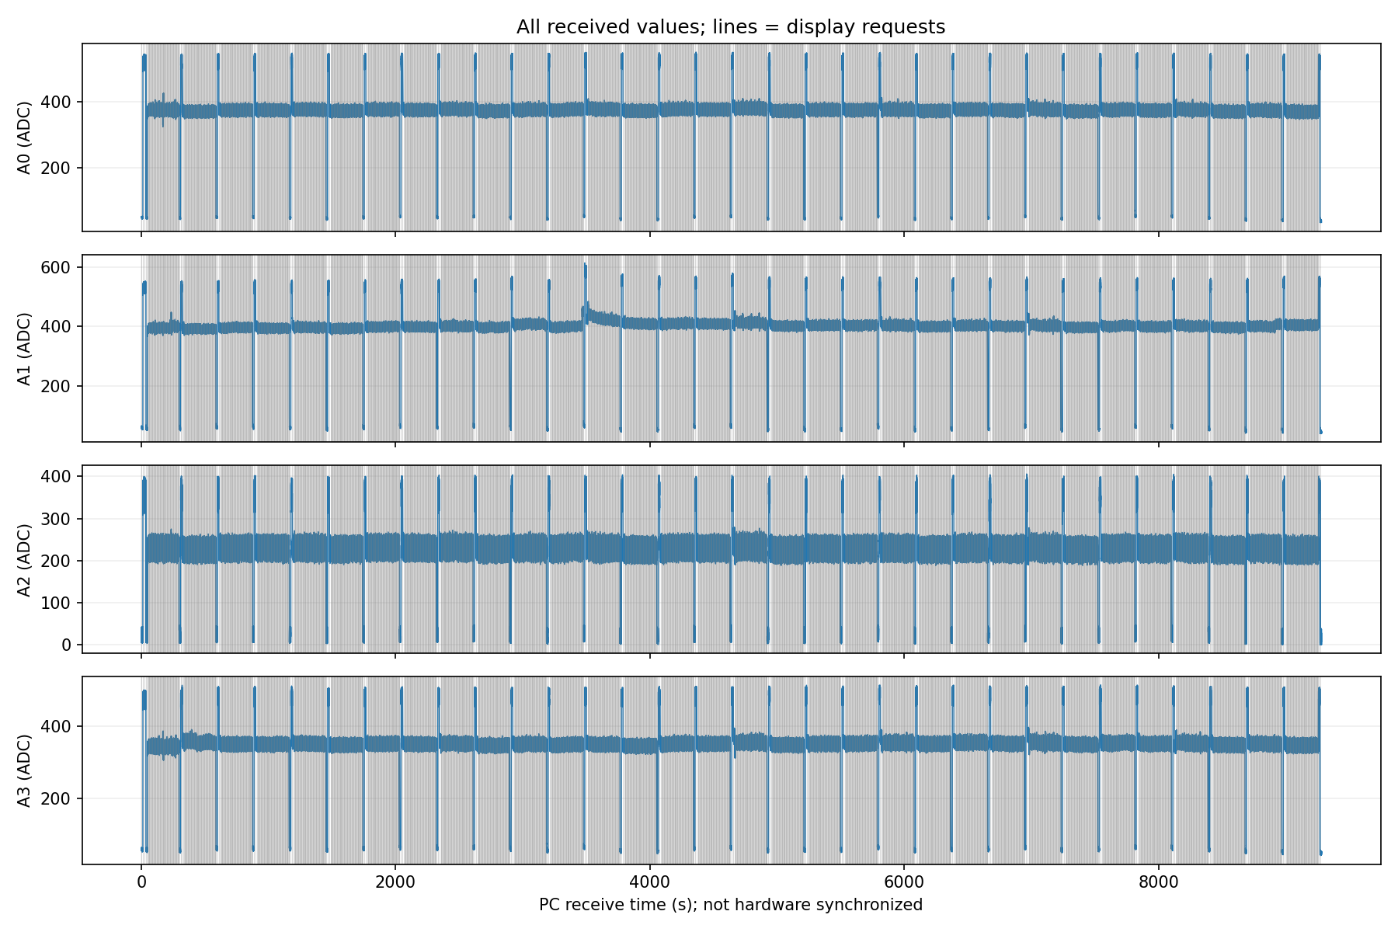
imaging_3d/results/hadamard_capture/2026-11-07_12-58-59/04_plot_spi_capture_8x8/time_series.png
