GuoJiashu/mech5720-2026-single_pixel_imaging/imaging_3d/results/hadamard_capture/2026-11-07_18-59-34/09_compare_3d_baseline/four_channel_warning_qc/height_error_comparison.png

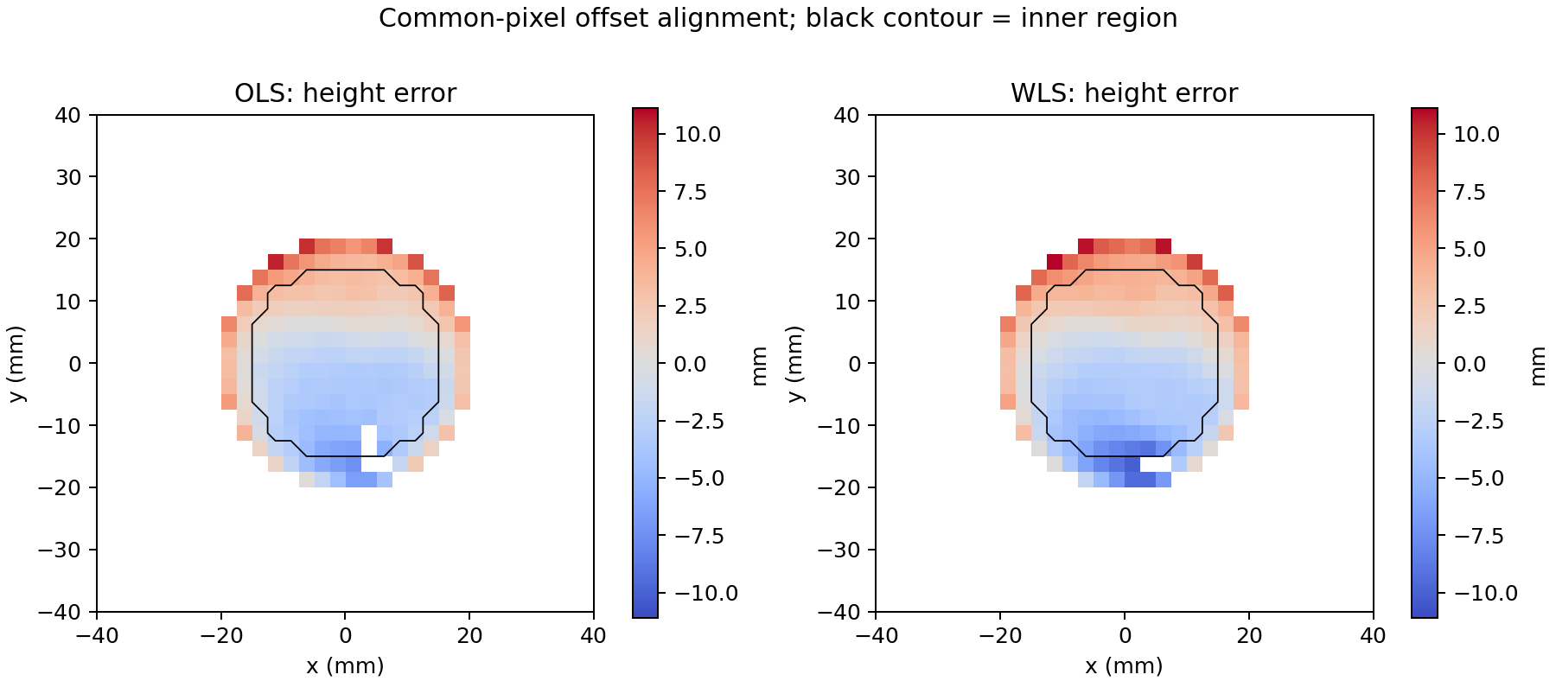
imaging_3d/results/hadamard_capture/2026-11-07_18-59-34/09_compare_3d_baseline/four_channel_warning_qc/height_error_comparison.png
