GuoJiashu/mech5720-2026-single_pixel_imaging/imaging_3d/results/hadamard_capture/2026-11-08_03-16-56/08_evaluate_sphere/cross_sections.png

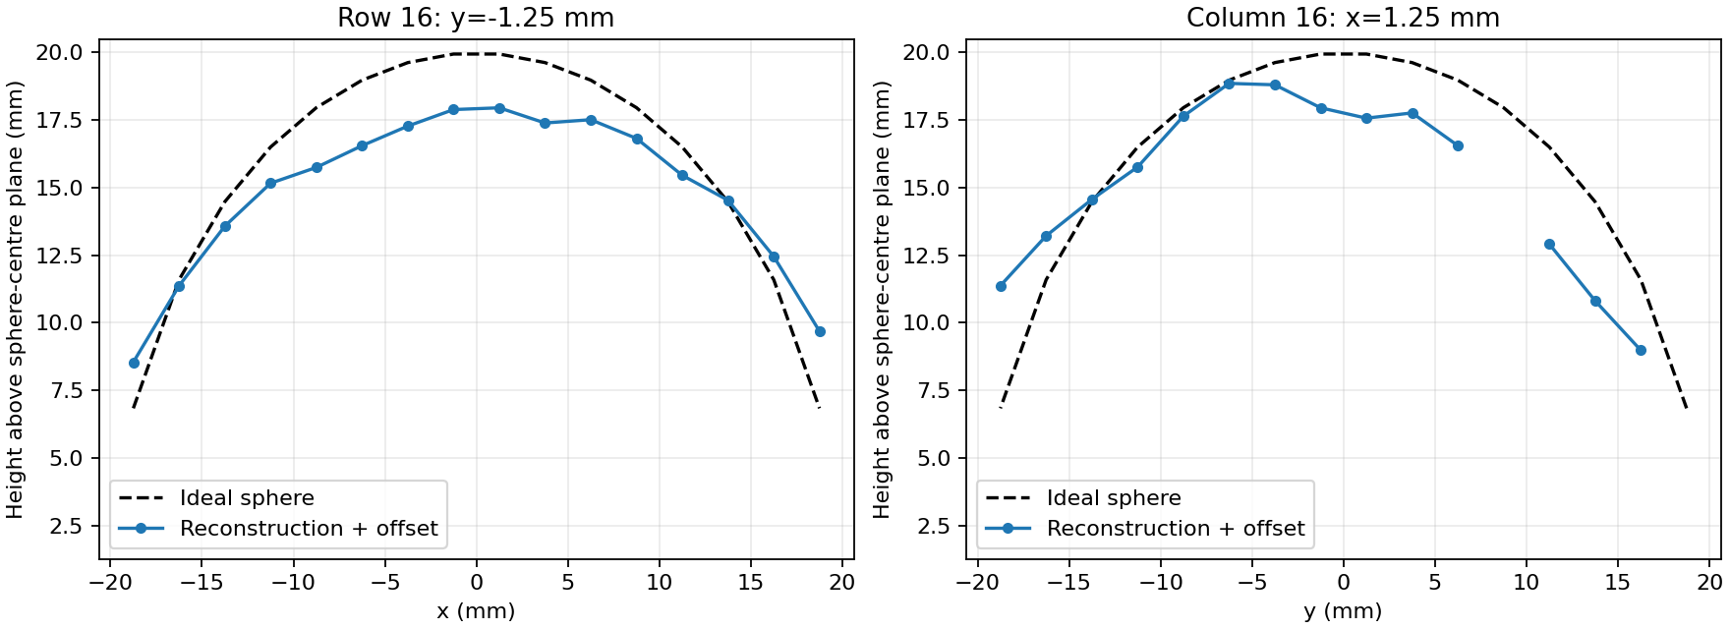
imaging_3d/results/hadamard_capture/2026-11-08_03-16-56/08_evaluate_sphere/cross_sections.png
