GuoJiashu/mech5720-2026-single_pixel_imaging/imaging_3d/results/spi_capture/20261029_203517_780684/04_plot_spi_capture_8x8/raw_adc_preview.png

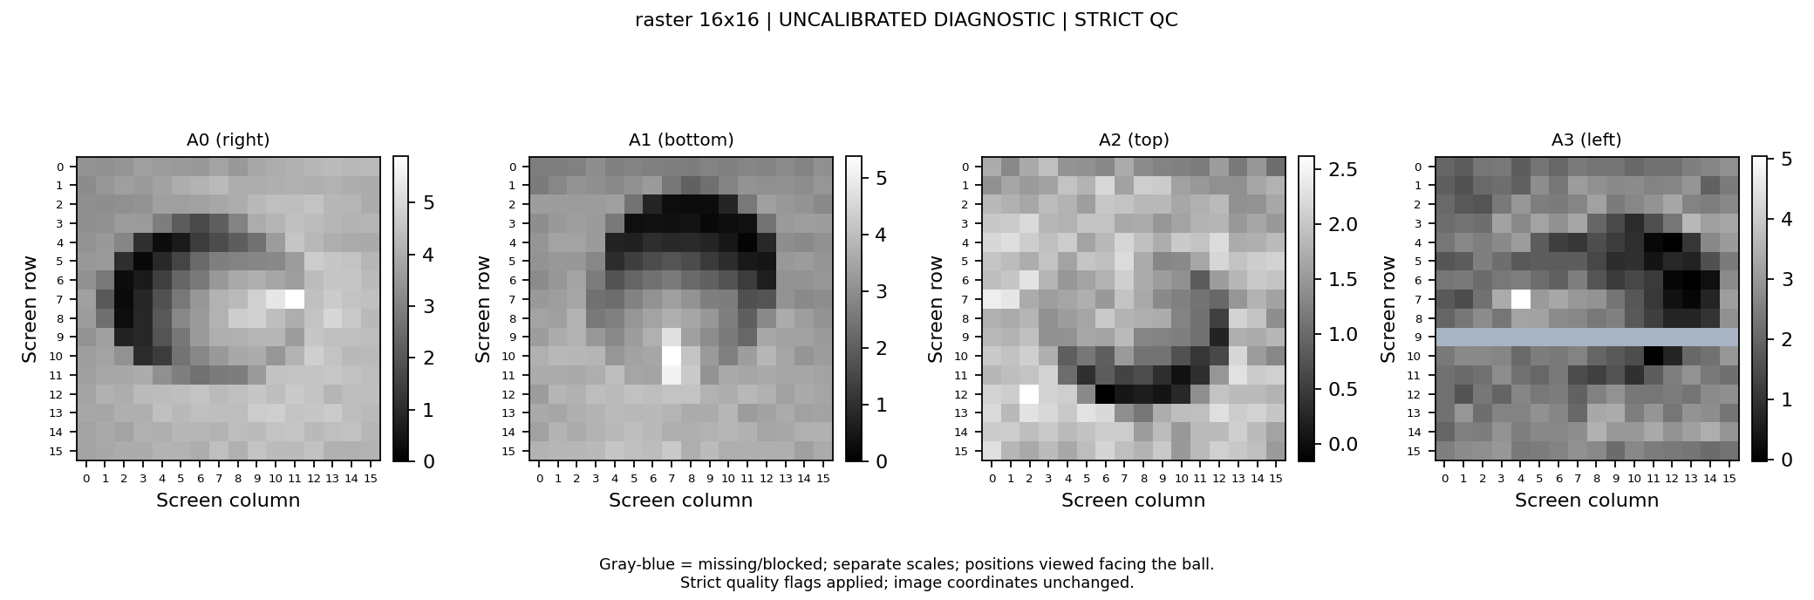
imaging_3d/results/spi_capture/20261029_203517_780684/04_plot_spi_capture_8x8/raw_adc_preview.png
