GuoJiashu/mech5720-2026-single_pixel_imaging/point_scan_results/20261025_020124_483501/admm_results/admm_convergence.png

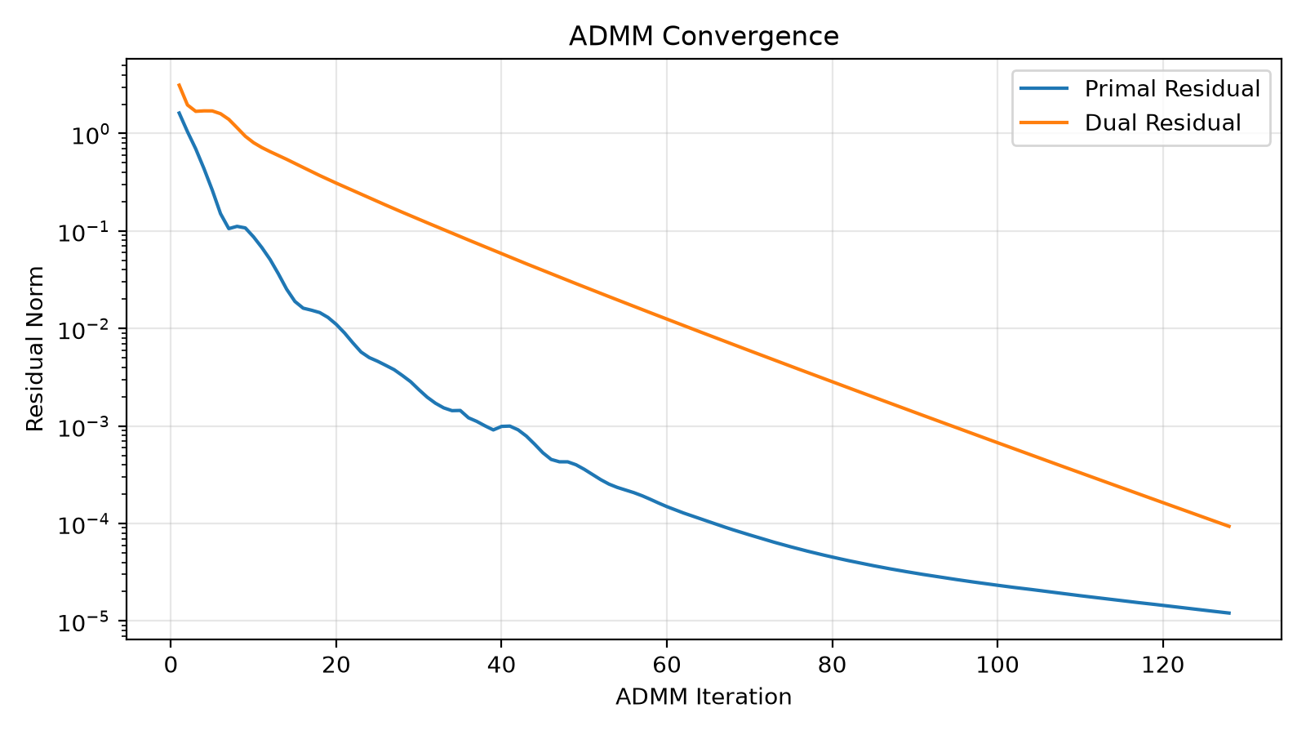
point_scan_results/20261025_020124_483501/admm_results/admm_convergence.png
