GuoJiashu/mech5720-2026-single_pixel_imaging/(commit log)

2026-10-23 Fix Foam Board entry in hardware list
    Corrected the order of columns for Foam Board entry in the hardware list.
2026-10-25 ground truth
2026-10-25 black ground analyze
2026-10-29 3d calibration and preliminary reconstruction result upload
2026-11-06 relocate the calibration code for 3d
